decentespresso/openscale/README.md

# Decent Open Scale (aka "openscale")
Decent Open Scale
Copyright 2024 Decent Espresso International Ltd

Credits:
Invention and authorship: Chen Zhichao (aka "Sofronio")

# Introduction:
The Decent Open Scale is a full open sourced(software/hardware/cad design) BLE scale. Currently you can use it with de1app and Decent Espresso machine. But with Decent Scale API, you can use it for anything.<br />
To make it work, you need at least an ESP32 for MCU, a Loadcell for weighing, an HX711 for Loadcell ADC, a SSD1306 for OLED display, a MPU6050 for gyro function.<br />
The current PCB for HDS uses ESP32S3N16, i2000 2kg loadcell, ADS1232(instead of HX711), SH1106/SH1116(instead of SSD1306), ADS1115(for battery voltage), TP4056(battery charging), CH340K(COM to USB), REF5025(analog VDD), BMA400(instead of MPU6050, but gyro will be dropped in the future).
If you want to use it unplugged, you'll also need a 3.7v battery.<br />
If you only want to burn the firmware, please read How to upload HEX file.<br />

# How to build

Beginning with firmware version 3.0.0, OpenScale now uses [Platform.io](https://platformio.org) for development, building and flashing the firmware.  

To build and flash the scale from your computer, make sure you have the `pio` command line tool and OpenSSL installed. Set `OPENSSL` to its executable path if it is not available through `PATH`; Git for Windows is also detected when `git.exe` is on `PATH`.
After this, one can simply use `$pio run -t upload` and platformio will build and flash the firmware to the connected Esp32s3 chip.

# New in 3.1.14

## Custom firmware

The [custom build configurator](https://decentespresso.github.io/openscale/custom-build/) builds approved feature and plugin combinations. Choose `3.1.14 (stable)`, selected by default, for normal use. The other option, `main (development)`, is for testing only and requires confirmation before building. Download the build for USB installation or assign it to linked scales for signed WiFi installation and status tracking.

Plugin authors can use the [plugin development guide](docs/plugin-development.md) for package, webapp, and presentation rules.

## App Text (Development)

Development firmware includes BLE App Text in standard and custom builds. Enable
`Setup > Display > App Text` on the scale before connecting a supported app. The
setting defaults Off and survives reboot. Apps can show up to 128 printable ASCII
characters underneath the live weight or clear them to restore the timer area.
Text that fits stays centered. Longer instructions scroll left, pausing for one
second at the beginning and end before repeating.
The timer keeps running. Menus, errors, Pressensor, and grinder-operation screens
retain priority. Hold Circle while text is visible to block it until reconnection.
See the [protocol and browser example](examples/ble-app-text/README.md).

On updated `main`, custom firmware can include both Pressensor and Grind by Weight.
Their Enabled controls switch integrations immediately in the menu; saved sensor,
plug, and tuning settings remain intact. Switching is blocked while grinder
shutdown is unconfirmed. App Text has its own setting and does not select a mode.
Older firmware refs keep their existing plugin conflicts.

## Scale-top tap controls

Optional scale-top gestures can tare with a double tap and start or stop the timer with a triple tap. Both are disabled by default and can be enabled independently under `Setup > Scale`.

## Power and wake

Weight changes during use now refresh the auto-off timer, so active weighing does not require a button press to keep the scale awake. A static load does not keep resetting the timer.

Optional [Wake-on-Weight](docs/wake-on-weight.md) is available under `Setup > Power` and defaults to off. It checks for added or removed weight between deep-sleep intervals. This mode consumes battery during standby and has no ongoing low-voltage cutoff; read its limitations before enabling it.

Custom builds with `Energy Saving Beta` also expose OLED idle/redraw controls and a single `Light Sleep` toggle under `Power`. These remain optional, not part of the standard release build.

# New Features in 3.0.0

## Wifi mode

Decent Scale uses WiFi for web apps, WebSocket data streaming, and OTA updates.

To enable WiFi mode in 3.1.14, open `Setup > Connections` and toggle `WiFi`. Older firmware groups these entries under `WiFi Settings`. A restart is required for changes to take effect; exiting setup applies the queued restart.

**First-time setup:** if no WiFi credentials are stored, the scale opens its own access point: SSID `DecentScale`, password `12345678`, IP `192.168.1.1`. Connect to it and open [192.168.1.1](http://192.168.1.1), or [hds.local](http://hds.local) if your device resolves that hostname, to enter your home WiFi credentials. The same page can rename the scale (see **Scale name** below). Published 3.1.14 saves the credentials and restarts; its dashboard retains the manual setup controls.

In 3.1.15, enter the network name and password manually while `DecentScale` is active. Network search is hidden in setup AP mode, including AP+STA, because scanning can disconnect the phone from the scale. Find networks remains available when the setup AP is off.

**3.1.15 setup:** Connect opens a progress dialog. For a different network, stay on the original network while the scale tests the new connection without saving credentials, then returns to report the result. When starting from `DecentScale`, the setup AP stays active during the test and reports the result before the final switch. If your phone cannot reach the setup AP while mobile data is enabled, temporarily use airplane mode with WiFi enabled. A successful test offers the scale's tested IP address and starts the final switch. Click that link to show the network-change instructions, join the new network on your phone or computer, then select Continue. IP address is selected by default; hostname is an explicit alternative. The link also opens this address choice after a confirmed connection or same-network reconnect, without asking you to change networks again. If DHCP changes the address, enter the current IP shown on the scale. The destination checks the same scale and operation before confirming that credentials were saved. Navigation never starts automatically, and losing contact does not prove success. A failed switch restores the previous network or opens the setup AP. Retry closes the result dialog and returns to the password field without resubmitting. Current setup pages use network names and passwords exactly as entered, including meaningful leading or trailing spaces.

**Reconnect:** once configured, the scale stays in STA mode and reconnects automatically after signal loss with exponential backoff (5 s → 10 → 20 → 40 → 60 s cap). Ordinary signal loss does not open the AP. After a failed 3.1.15 setup test whose previous network cannot be restored, the recovery AP retries the saved network after ten minutes; a failed retry reopens the AP.

**Discovery:** the scale advertises itself via mDNS (`hds.local` by default) and DNS-SD (`_decentscale._tcp`) so apps can discover it on the LAN without knowing the IP.

**Scale name:** the mDNS name defaults to `hds`, so a scale you never rename answers at [hds.local](http://hds.local). When two scales share a network they both ask for that name and the mDNS stack pushes the loser to `hds-2.local` — which works, but which scale gets which address depends on boot order. Name them instead: on the scale's web page, use the "Scale Name" field in the WiFi setup area. Names are 1-24 characters of letters, digits, and hyphens (lowercased automatically); leaving the field empty restores `hds`, and re-submitting the name a scale already has changes nothing and does not restart it. Otherwise saving restarts the scale, after which it answers at `<name>.local`, advertises the DNS-SD instance `Half Decent Scale (<name>)`, and reports the name in the `/snapshot` status frame as `mdns_name`. The name is also shown on the scale's WiFi status screen (setup menu, "Wifi settings"). Names are not checked for uniqueness — pick a different one per scale.

If you rename during first-time setup, before entering WiFi credentials, the scale restarts back into access-point mode under the new name — reach it at `192.168.1.1` or `<name>.local`, not `hds.local`.

WiFi firmware updates are documented in [docs/wifi-ota.md](docs/wifi-ota.md).

## Web apps
The same web apps that could be used with Half Decent Scale from [the web](https://decentespresso.com/docs/introducing_half_decent_scale_web_apps) have now been rewritten to run directly from the Half Decent Scale.

You can find these apps on the index page of Half Decent Scale Web User Interface - navigating to [hds.local](http://hds.local)

## WebSockets support

When WiFi mode is enabled on HDS, there is also a new WebSocket endpoint available, where you can receive real-time information regarding the weight in the following format  

```json
{
  "grams": 25.66,
  "ms": 12345
}
```

you can also send a simple `tare` String over the websocket and the scale will tare itself.

For backwards compatibility, snapshot frames do not include a `type` field.
Clients should treat the absence of `type` as a weight snapshot. Event and
response frames always include `type`.

> **Security / trust model:** the WebSocket endpoint is unauthenticated, just
> like the BLE interface. Any host that can reach the scale on the network can
> read weight and send control commands, including destructive ones such as
> `power off`, `soft_sleep on`, and `display off` (a remote `power off` cannot
> be woken over the network). Only expose HDS on a trusted LAN.

Multiple clients may connect at once (e.g. the on-device web UI and a separate
app). They share a single negotiated stream rate (the most recent `rate` command
applies to all clients); each client is served independently, so a backed-up
client drops its own frames without stalling the others.

By default, WiFi clients receive weight snapshots at 2 Hz. A connected client
can negotiate one of the supported WiFi stream rates by sending one of these
WebSocket messages:

```text
rate 2k
rate 5k
rate 10k
```

or JSON (any of these forms work):

```json
{ "command": "rate", "value": "10k" }
{ "rate": "10k" }
{ "rate_hz": 10 }
{ "hz": 10 }
{ "interval_ms": 100 }
```

The supported rates are 2 Hz, 5 Hz, and 10 Hz. The firmware sends back a
`type: "rate"` acknowledgement with the active interval and rate. The firmware
does not automatically downgrade a requested rate on weak WiFi; if a client's
socket is not writable for a tick, that frame is skipped for that client rather
than queued.

WiFi snapshots are intentionally kept small, especially at 10 Hz:

```json
{
  "grams": 25.66,
  "ms": 12345
}
```

Battery, charging, timer, and power/display state are sent in typed `status`
frames on demand only. Send `status`, `battery`, or `info` to get one. The
firmware does not push status periodically (mirrors the BT side, which has no
periodic state push either — clients request battery via `0x22`, etc.).

WiFi clients can send these text commands over the same WebSocket:

```text
tare
events on
events off
timer start
timer stop
timer reset
display on
display off
low_power on
low_power off
soft_sleep on
soft_sleep off
power off
status
battery
info
```

The legacy text `tare` command is intentionally silent for backwards
compatibility. JSON `{ "command": "tare" }` returns a `type: "status"` ack.

The same commands can be sent as JSON (full form):

```json
{ "command": "tare" }
{ "command": "timer", "action": "start" }
```

**JSON shorthand** — control keys at the top level are also accepted:

```json
{ "events": "on" }
{ "display": "off" }
{ "tare": true }
{ "timer": "start" }
```

Bool values map to on/off (`{"display":false}` → off). The `power` key is excluded from the bool form — power-off requires the explicit `{"command":"power","action":"off"}` or text `power off`.

An unrecognized or malformed command (bad JSON, or an unknown verb) returns an
`error` frame rather than silence, so a client can distinguish a rejected
command from a frame that never arrived:

```json
{
  "type": "error",
  "code": "unknown_command",
  "message": "unrecognized or malformed command",
  "ms": 12345
}
```

Status frame shape:

```json
{
  "type": "status",
  "status": "ok",
  "protocol_version": 1,
  "firmware_version": "FW: 3.0.9",
  "grams": 25.66,
  "ms": 12345,
  "battery_percent": 82,
  "battery_voltage": 3.95,
  "charging": false,
  "timer_running": true,
  "timer_seconds": 12,
  "display_on": true,
  "low_power": false,
  "soft_sleep": false,
  "events_enabled": true,
  "rate_hz": 10,
  "interval_ms": 100
}
```

For backwards compatibility, WiFi only sends weight snapshots by default. A
client must send `events on` before local scale button presses or power-off
notifications are emitted (status frames remain on-request regardless of the
`events` flag). The event stream resets to off when the WebSocket disconnects.

Button event fields:

```json
{
  "type": "button",
  "button": "circle",
  "button_number": 1,
  "press": "short",
  "press_code": 1,
  "ms": 12345
}
```

Button numbers are `1 = circle` and `2 = square`. Press codes currently emitted
over WiFi are `1 = short` and `2 = long`; the current finger-detection path only
emits short-press events.

Power event fields:

```json
{
  "type": "power",
  "event": "power_off",
  "reason": "low_battery",
  "reason_code": 3,
  "ms": 12345
}
```

Power reason codes are `0 = disabled/failed`, `1 = circle double-click`,
`2 = square double-click`, `3 = low battery`, and `4 = gyro` when gyro support
is compiled in.

Power and display command semantics:

- `display on` / `display off`: OLED power save on/off. The scale and WiFi stay
  awake.
- `low_power on` / `low_power off`: sets OLED contrast to minimum/maximum. It
  does not disable the WiFi modem or drop the WebSocket link.
- `soft_sleep on`: turns off the OLED and sensor power rails and pauses normal
  scale-loop work. WiFi remains configured so a later WebSocket command can wake
  it, but weight snapshots stop while soft sleep is active.
- `soft_sleep off` / `soft_sleep wake`: restores sensor power, OLED power, and
  normal scale-loop work.
- `power off`: full scale power-off. The WebSocket link will drop and cannot
  wake the scale.

A scriptable regression test for this protocol lives in
[`tools/ws_feature_test.py`](tools/ws_feature_test.py): with WiFi enabled on the
scale, `pip install websocket-client` then `python3 tools/ws_feature_test.py`
(it auto-discovers `hds.local`, or pass an IP).

# How to upload Web apps?

In order to build and upload Web apps to HDS, you need to use `pio` to build and upload the filesystem image to the Esp32s3.  
Simply run `pio run -t buildfs -t uploadfs` with the Esp32s3 connected to your computer

# Development workflow

Trunk-based: `main` is the single long-lived branch and is always releasable. Do work on short-lived feature branches and merge into `main` once CI passes.

`Release firmware` prepares a signed draft from a version tag (`vX.Y.Z`); `Publish firmware` publishes the verified draft without rebuilding. See [release workflow details](docs/AI_RELEASE_NOTES.md#release-model) for inputs and checks. Releases include the legacy USB ZIP, dependency inventory, signed release evidence, and machine-readable OTA assets:

- `firmware.bin`: raw OTA firmware image.
- `littlefs.bin`: raw filesystem image. WiFi OTA releases always publish and require it so skipped versions and test builds with unknown filesystem state are brought back to the production filesystem.
- `manifest.json`: release metadata downloaded by the scale before installing.
- `manifest.sig`: detached SHA-256 signature. The workflow requires `HDS_OTA_SIGNING_KEY_PEM` as a repository secret. Firmware trusts the three public keys tracked under `keys/ota/`.

Key 1 continues signing releases until firmware containing all three public keys has rolled out. Firmware released before the three-key migration trusts only Key 1 and cannot recover with Key 2 or Key 3 if the Key 1 private key is lost. Losing a private key does not require removing its public key from firmware.

The scale checks `https://github.com/decentespresso/openscale/releases/latest/download/manifest.json`, downloads `manifest.sig`, verifies the detached signature with the public key compiled into the firmware, then verifies `model`, optional `pcb`, `min_from`, chip, environment, flash size, partition schema, filesystem partition size/schema, HTTPS certificate chain, asset URL prefix, asset size, and SHA-256 before writing firmware. Manifest `version` and `min_from` must be stable numeric `major.minor.patch` values. The workflow builds a signed catalog from `v3.1.13` upward by merging the previous latest stable signed manifest with the new release, deduping compatible entries, and sorting newest to oldest. The WiFi updater lists compatible stable releases except the firmware version already running.

WiFi OTA always stages the required LittleFS update. With signed rollback metadata available, the current firmware saves both target and rollback metadata, writes the inactive app slot, and reboots. The new firmware verifies or attempts the target filesystem at most twice before accepting normal operation. On failure it rolls back, restoring the previous filesystem once if writing had begun. Firmware with the 3.1.14 recovery support pauses a failed restore, disables unverified web assets, and keeps the embedded WiFi setup page and update menus available for repair. Older rollback firmware can instead stop at `UPDATE ERROR` and require USB recovery. Successful recovery clears the pending state and reboots.

When the installed build has no published recovery assets, firmware that already supports forward recovery may install a signed target declaring `forward_recovery: 1`. It verifies the newly running firmware before attempting filesystem writes, then either completes the update or retains filesystem-free repair access. This cannot add recovery support to already-installed older firmware. See [WiFi OTA updates](docs/wifi-ota.md) for supported source paths. `HDS_RELEASE_MIN_FROM` may raise the minimum source version, but release verification rejects a value that excludes the previous stable release.

The single LittleFS partition has no independent rollback slot, so recovery requires the signed rollback asset to remain available. The firmware records attempt and write state before changing the partition so power loss resumes the same bounded recovery transaction instead of entering normal weighing with a partial installation.

# Automated builds

With version 3, we have also started using GitHub actions to build the firmware and filesystem images. You can find the recent builds on the "Actions" tab on the GitHub page of this project. From there you can also download the firmware files (e.g. for development builds).

# How to upload firmware files
Web USB Flash(please use Chrome/Edge, Safari or Firefox is not supported):<br />
https://adafruit.github.io/Adafruit_WebSerial_ESPTool/ <br />
The offset values are:<br />
bootloader.bin 0x0000<br />
partitions.bin 0x8000<br />
firmware.bin 0x10000<br />
littlefs.bin: 0x670000<br />

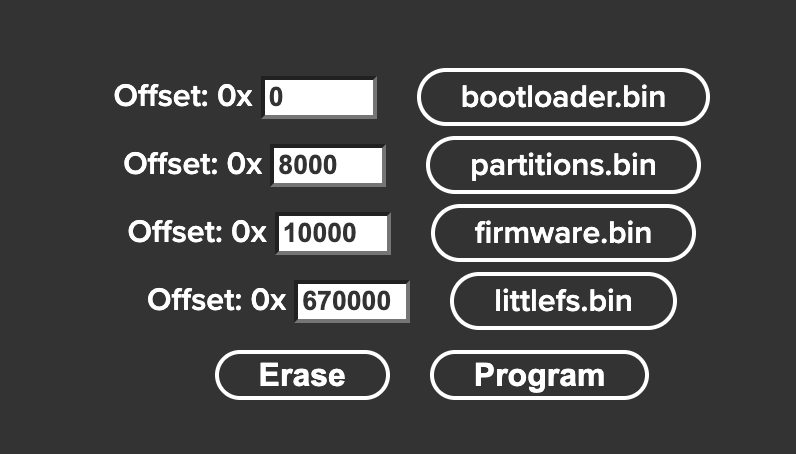
[picture p1: assets/esp-tool.png]
binary offsets


This tool works great, but need to reset by pressing the button on the PCB.<br />
And as it erase the eprom, a calibration is also required.<br />

Or use OpenJumper™ Serial Assistant, link as below.(In Chinese)<br />
https://www.cnblogs.com/wind-under-the-wing/p/14686625.html <br />
