decentespresso/openscale/plugins/grind-by-weight/README.md

# HDS Grind by weight

HDS support for using a Tasmota smart plug as a grinder power switch.

Plug-side firmware lives at:

https://github.com/decentespresso/tasmota-auto-doser

This is a trusted-local-WLAN feature. The plug MAC is used as an identity label, not as authentication.

## What It Does

- Lets the scale switch the grinder plug on and off automatically
- After a new plug connection, starts only after you tare the empty cup and it becomes stable
- Stops the grinder when the dose reaches the target
- Waits for cup removal before preparing the next dose
- Learns a better safety value from normal shots over time
- Keeps the plug off if the connection is lost while grinding
- Keeps normal weighing responsive even when the plug is offline

The grinder itself still needs to be ready to run. This feature controls power to the plug, not the physical grinder switch.

## Plug Setup

Install the linked plug firmware on the Tasmota plug, then connect the plug to the same WiFi network as the scale.

## Scale Setup

1. Build firmware with the `Grind by weight` plugin and flash it to the HDS scale.
2. Connect the scale to WiFi.
3. Open the HDS OLED menu.
4. Open `Grind by weight`.
5. Select `Enable`.
6. Select `Select Plug`.
7. Choose the plug MAC address.
8. Adjust the grinder settings if needed.
9. Leave the menu with `Back`.

The selected MAC is the saved identity. Hostname and IP are cached only to find the plug faster later.

## First Safe Test

Keep the grinder's physical switch off for the first test so the plug can switch without starting the motor.

1. Complete `Scale Setup` and leave the menu.
2. Confirm that the display reaches `Tare to arm`.
3. Put the empty dosing cup in its normal position and tare the scale.
4. Wait for `Ready` and confirm that the plug relay switches on.
5. Add weight gradually until the cutoff is reached and confirm that the plug switches off.
6. Remove the weight and return the empty cup. After stable zero, the display should return to `Ready`.

Only enable the grinder's physical switch after this dry test works reliably.

## Settings

From the normal weight view, hold both buttons for 500 ms to open the `Grind by weight` menu when the feature is enabled. Use `Target g` there for quick target changes.

Defaults:

```text
Grind by weight: disabled
Target: 15.0 g
Safety: 2.0 g
Zero range: -1.0 g to 1.0 g
Zero hold: 1000 ms
Target tolerance: 0.5 g
```

`Enable` forces WiFi on boot.

Entering the grinder menu while the plug is armed sends OFF first. The TCP connection is kept alive where possible, and leaving the menu rearms only after stable zero.

The cutoff threshold is:

```text
target grams - safety grams
```

Latency compensation is not used. Adaptive safety is the only early-stop compensation.

Example with the defaults:

```text
target: 15.0 g
safety: 2.0 g
cutoff: 13.0 g
```

The earlier cutoff allows for grounds that continue falling after power is removed. Adaptive learning adjusts safety from valid completed doses; it does not change the target.

## Normal Use

1. Enable Grind by weight and select a plug.
2. Put the empty dosing cup on the scale.
3. On the first plug connection after Grind by weight starts, the display shows `Tare to arm`.
4. Tare the scale.
5. Wait until the cup is stable inside the zero range.
6. The display shows `Ready` and the scale sends `ON` to the plug.
7. Start the grinder physically if needed.
8. The display changes to `Grinding` after a rising dose is detected.
9. The scale sends fast OFF when cutoff is reached.
10. Remove the filled cup.
11. Put the empty cup back.
12. The scale rearms after stable zero hold without requiring another tare.

After a reconnect, the existing tare baseline remains valid. The relay stays off; remove and return the cup to resume without another tare. Automatic startup, charging-wake, and ADC-recovery tares do not arm the grinder.

After `Ready` appears, only ground coffee should add weight. Slowly placing another object can look like a valid grind because the scale only sees weight changes. If the cup or setup changes, tare again before grinding.

## Display Status

| Display | Meaning | What to do |
| --- | --- | --- |
| `WiFi wait` | Scale is waiting for WiFi | Wait for WiFi or check the saved network |
| `Plug wait` | Selected plug is not reachable | Power the plug or use `Select Plug` |
| `Tare to arm` | Plug is connected but safely OFF | Put down the empty cup and tare |
| `Zero wait` | Waiting for a stable zero reading | Leave the empty cup untouched |
| `Ready` | Plug relay is ON and dosing can begin | Start the grinder physically |
| `Grinding` | A plausible rising dose was detected | Let the dose run |
| `Stopping` | OFF was sent and acknowledgement is pending | Wait briefly |
| `Remove cup` | Dose ended | Remove the filled cup |
| `Await zero` | Waiting for the empty cup to return | Return the empty cup and leave it stable |
| `Tare cup` | Weight rose too quickly to be a plausible grind | Return to zero or tare the changed setup |
| `Busy` | Another scale/client owns the plug connection | Disconnect the other client or restart the plug |
| `Error` | Fail-safe stopped Grind by weight | Check the plug and reconnect Grind by weight |

`Grinding` is a display indication, not the cutoff authority. It appears after at least 750 ms, 1.0 g rise, three positive steps, and an average rise no faster than 6 g/s.

## Cutoff Protection

OFF is blocked until all of these are true:

- tare is not pending
- one user-requested tare completed during the current grinder session
- weight has left zero range
- 1500 ms passed since leaving zero range
- weight is at or above `target - safety`
- the selected plug connection is still valid

Grind confirmation changes the display from `Ready` to `Grinding`. If cutoff weight is reached at an impossible average rate above 6 g/s, the scale treats it as cup/setup mass and does not send OFF. This block remains until tare or return to zero, so a stationary cup cannot later become a valid grind merely because time passes.

`Target g` accepts 10.0 to 200.0 g. `Safety g` accepts 0.0 to the smaller of 10.0 g or `target - 5.0 g`, keeping cutoff at 5.0 g or higher.

## Adaptive Safety

After a valid grind, the scale compares final weight to target and adjusts safety for later shots.

Example:

```text
target: 15.0 g
final: 15.3 g
result: safety increases for future shots
```

The adaptive value averages the last 3 valid recommendations.

Learning is skipped when the shot does not look like a normal grind:

- final weight did not become stable
- the cup was removed too early
- weight dropped after OFF
- the grind stalled below target
- average grind rate was too high
- final result was too far from target

Adaptive changes are saved before deep sleep instead of on every loop.

## Technical Details

The plug advertises itself with mDNS:

```text
service: _grinderplug._tcp.local
port: 31980
TXT mac=<plug_mac>
TXT proto=1
TXT model=<optional model name>
```

The scale stores the selected plug MAC as the identity. Hostname and last IP are only cached lookup hints.

The scale keeps one TCP connection open while active. It sends `HELLO <scale_mac>` and only accepts the plug if the returned MAC matches the selected MAC.

After validation, cutoff uses the fast OFF command `!`. The scale also sends PING heartbeats while connected.

The plug relay must default to OFF on boot. If the active TCP connection drops, the plug must also turn the relay OFF.

Each plug accepts one active scale connection. A second client receives `BUSY` and is closed.

## Troubleshooting

### Select Plug Finds Nothing

Check mDNS from another machine:

```powershell
dns-sd -B _grinderplug._tcp local
dns-sd -L "INSTANCE NAME HERE" _grinderplug._tcp local
```

Expected result:

```text
port=31980
mac=<plug_mac>
proto=1
model=<optional model name>
```

If `_http._tcp` appears but `_grinderplug._tcp` does not, the plug service advertisement is wrong.

### Scale Shows Plug Wait

The selected plug cannot currently be reached.

Check:

- plug is powered
- plug is on the same WLAN
- plug TCP service is listening on port 31980
- saved hostname still resolves
- saved IP still belongs to the selected plug

If the plug IP changed and hostname lookup does not recover it, run `Select Plug` again.

### Scale Shows Busy

Another scale or client is already connected to the plug. Disconnect the other client or restart the plug.

### Scale Shows Wrong Mac

The TCP server answered with a MAC different from the selected plug MAC. This usually means the cached IP points to another device. Run `Select Plug` again.

### Scale Shows an Error

The scale entered the Grind by weight fail-safe state.

Common causes:

- plug connection lost while grinding
- malformed TCP response
- wrong plug MAC
- plug returned `ERR`
- `ON` timed out
- `OFF` timed out

The plug is expected to turn OFF automatically when the active TCP connection drops.

### Scale Shows Tare To Arm

The plug connection is valid, but the grinder remains OFF until a user-requested tare completes. Put the empty basket on the scale and press tare. Startup and recovery tares do not clear this prompt.

### Plug Is Offline And Weighing Must Stay Responsive

Normal weighing does not run full blocking service discovery in the background. Runtime lookup only tries the saved IP and saved hostname with short timeouts. Full mDNS discovery happens in manual `Select Plug`.

### The Scale Does Not Rearm

Rearming requires:

- filled cup removal detected
- empty cup returned
- weight stable inside zero range for the zero hold time

Default zero hold is 1000 ms.

## Serial Debug

Grind by weight debug logs are printed on USB serial. The internal prefix remains:

```text
[grinder] connect
[grinder] tx HELLO
[grinder] rx OK
[grinder] cutoff
[grinder] safety learn
[grinder] error
```

## Security Notes

This protocol has no cryptographic authentication. Any host on the trusted WLAN that can reach the plug or scale network services may interact with them. Do not expose the scale or plug to untrusted networks.
