decentespresso/openscale/docs/AI_PROTOCOL_NOTES.md

# AI Protocol Notes

Read this when changing Decent binary commands, BLE or USB framing, shared response packets, compatibility behavior, or the WebSocket control surface.

## Sources

- Shared Decent packet helpers, response builders, command lengths, and dispatch: `include/decent_protocol.h`.
- BLE GATT transport and `BleDecentCommandSink`: `include/ble.h`.
- USB buffering, text/binary separation, and `UsbDecentCommandSink`: `include/usbcomm.h`.
- WebSocket text and JSON protocol: `include/websocket.h`; its user-facing wire contract is in `README.md`.
- ADS debug host helpers and decoders: `tools/ads_debug_protocol.py`, `tools/decode_ads_debug.py`.

WebSocket is not a wrapper around the Decent binary dispatcher. Keep its backward-compatible JSON/text behavior separate while routing equivalent hardware actions through the same runtime helpers where practical.

## Binary Command Flow

BLE and USB both route Decent commands through `handleDecentBinaryCommand()`. The shared dispatcher owns command validation and meaning; transport sink methods own delivery and transport-specific side effects.

- BLE accepts one GATT write on service `fff0`, write characteristic `36f5`, and notifies responses on `fff4`.
- USB shares serial with text commands and logs. It buffers up to 160 bytes, separates text from frames beginning with `0x03`, and uses a 30 ms timeout to resolve incomplete legacy frames.
- `decentCommandFrameLength()` is the USB stream boundary contract. Update it whenever a binary command length changes.
- Every command handler must guard the bytes it reads with `decentRequireLength()`.

Do not duplicate command interpretation in BLE and USB. Add shared behavior to the dispatcher and only add sink methods when the transports genuinely perform the effect differently.

## BLE Notification State

App Text is a separate core characteristic in `FFF0`, UUID
`8b8dc7c0-6bf7-4bdf-9a2c-0ba9cb9a4a01`. Read returns `[1,128,10,enabled]`;
write `[1,...text]` to Show or `[0]` to Clear. Text is 1-128 printable ASCII bytes.
Each Show is one acknowledged write, up to 129 bytes; the BLE stack handles
long-write assembly. The updated browser helper negotiates the advertised limit
and still accepts the original 18-byte firmware capability.
Only the local persisted Display opt-in enables Show. BLE callbacks validate and
update protected fixed buffers; the main loop renders text below weight on the
normal weighing screen. Overflowing text holds its beginning for one second,
scrolls left at ten pixels per second until its end is visible, holds for one
second, and starts over. Scrolling position participates in Energy Menu redraw
detection. Legacy heartbeat refreshes the ten-second text session, not scrolling.
Disconnect, expiry, Off, or Clear removes text; Circle cancellation blocks Show
until reconnection. Neither USB nor WebSocket exposes this text command. See
`examples/ble-app-text/README.md` and run `python tools/test_app_text.py`.

A live BLE connection does not imply an FFF4 notification subscription. A client becomes eligible for outbound FFF4 notifications only after its current connection handle subscribes to the characteristic.

All outbound FFF4 paths pass through `bleCanNotifyCurrent()`. The shared gate checks the feature state, characteristic, live connection, and current subscription before touching the characteristic.

On iOS 9 the pinned arduino-esp32 framework can insert a peer before descriptor lookup, then skip both `onConnect` and its connection-count increment when that lookup fails. `onSubscribe` removes the uncounted peer before disconnect can underflow the framework counter, adopts the connection without clearing queued responses, and records that the connection requires direct NimBLE notifications. Normal connections continue through `BLECharacteristic::notify()`.

Display status responses are deferred through a mailbox. The BLE callback queues the response, and `processBleStatusResponse()` drains it from the main loop. The mailbox waits two seconds for the FFF4 subscription, then rechecks the connection handle, connection generation, pending requests, and subscription before disconnecting. A newer request or reused connection cancels stale recovery.

## Framing And Checksums

Decent binary frames begin with model byte `0x03`. Checksums are XORs of the preceding bytes.

- `0x0F` tare is a seven-byte checksummed command; an invalid checksum must not tare.
- `0x0A`, `0x0B`, `0x25`, and `0x26` have legacy short-form compatibility in the USB length resolver. Do not make checksums universally mandatory without checking existing clients.
- A short USB form is accepted after the receive timeout; a complete valid checksummed form takes precedence.
- Shared seven-byte response builders calculate byte 6 from bytes 0 through 5.
- The `03 0A` LED response stores weight in bytes 2-3, battery state in byte 4, firmware major in byte 5, and checksum in byte 6. The firmware byte must be assigned before calculating the checksum.
- Weight packets use command `0xCE` and signed tenths of a gram. Decent fixed-point values are rounded to the nearest tenth rather than truncated, then clamped to the `int16_t` range.

`0x1B` starts a WiFi pull OTA and has two accepted forms:

- `03 1B` is the bare form. It starts the interactive on-OLED release picker and frames as exactly two bytes. An isolated prefix waits for the existing 30 ms USB receive timeout; a following unbiased byte resolves it immediately.
- `03 1B <major> <minor> <patch>` names a target release for an unattended install. Each version byte is encoded `0x80 | value`, so every component is capped at 127 and the firmware masks with `0x7F` on receipt.

The USB length resolver picks the five-byte form only when `data[2]` has its high bit set. A following command always begins with model byte `0x03`, and a biased version byte never can, so that byte distinguishes the forms without a checksum. Until a third byte arrives, the resolver retains the two-byte prefix. Timeout resolution waits while UART bytes remain unread, including across the main loop's 32-byte receive boundary. A frame whose payload has begun but is shorter than five bytes is refused and logged, never truncated to the bare form.

Every byte of a started payload must stay biased. An unbiased byte resynchronizes the resolver after one byte, so `03 1B 83` followed by `03 22` refuses the update and still delivers `03 22`. The dispatcher repeats the check, since BLE delivers whole packets and never reaches the resolver.

The bias is what lets one request form serve every scale. `processUsbRxBuffer()` enters the binary resolver only when the buffer's first byte is `0x03`, so firmware predating the payload frames `03 1B` as two bytes, starts its picker, and then discards the trailing bytes through the text path. A client never has to know the scale's firmware version or negotiate a capability.

The reserved target `0.0.0`, encoded as `03 1B 80 80 80`, requests an unattended
installation of the currently assigned Custom Build instead of an official release.
It uses the same BLE and USB queue and five-byte framing. No individual version bit
is repurposed. A missing pairing or assignment never starts an installation or pairing.
An already installed combination never downloads again. Older firmware does not
support this target: it either rejects the unsupported version or opens its legacy picker.

The client supplies no asset URLs. Official assets come from the signature-verified
catalog; custom assets come from the authenticated assignment and verified custom
manifest, with the same mandatory LittleFS and rollback checks. See `docs/AI_OTA_NOTES.md`.

The `/snapshot` WebSocket carries the same request as a `wifi_update` control command, accepted bare, as `wifi_update <version>`, and as `{"command":"wifi_update","action":"<version>"}`. The version is dotted `major.minor.patch` with an optional leading `v`. The command is compiled out when `HDS_FEATURE_PULL_OTA` is disabled and then answers `unknown_command`. A JSON `action` that is present but not a string answers `invalid_action`: an omitted action means the bare form, so a boolean, number, or object must not silently collapse into it.

ADS debug responses are separate fixed formats: the debug packet is 41 bytes and the reset response is 5 bytes. Keep their Python helpers, decoder, and firmware builders aligned.

Because WebSocket OTA uses the same target dispatcher, `wifi_update 0.0.0` also
requests the assigned Custom Build. Ordinary release versions and the bare picker
command retain their existing behavior.

## Runtime Effects

Shared packet meaning does not imply identical execution context:

- BLE sink actions that touch display, power, timer, or sleep state generally queue pending work for the main loop.
- USB sink actions run through the USB path and currently perform some effects directly.
- AsyncTCP WebSocket callbacks must only update visible state, reply to their client, or queue main-loop work. Never move I2C, SPI, OLED, power-gating, or blocking work into them.
- Remote tare paths should converge on `requestRemoteTare()`.
- Soft wake paths should converge on `wakeScaleFromSoftSleep()` and remain idempotent.

Preserve response ownership: BLE replies notify `fff4`; USB replies use `Serial.write`; WebSocket replies go only to the requesting client unless an event is explicitly broadcast and heap-gated.

## Compatibility Checklist

- Search both sinks and every response builder before changing a command.
- Preserve exact command lengths, legacy short forms, checksum coverage, and byte order unless a protocol version transition is planned.
- Keep BLE and USB response payloads identical when they use the same shared builder.
- Do not add a WebSocket `type` field to weight snapshots; clients use its absence to identify legacy snapshot frames.
- Keep the legacy WebSocket text `tare` command silent; JSON tare returns a status response.
- Treat `03 0A` as compatibility-sensitive because it covers display, power, low-power, heartbeat, soft-sleep, and the LED response.
- Keep `0x1B` version bytes biased with `0x80`. An unbiased payload could hold `0x03`, which older firmware would read as the start of a command: a `3.10.2` target would decode to `03 0A 02`, the power-off command, and `3.11.x` would land on the timer opcode.

## Checks

Use the smallest relevant set:

```sh
python tools/test_ads_debug_protocol.py
python tools/test_decode_ads_debug.py
python tools/test_soft_sleep_ads_wake.py
python tools/test_ble_subscription_contract.py
python tools/test_decent_ota_target_contract.py
pio run -e esp32s3
```

Device checks are still required for transport timing and delivery: use `tools/ble_scale_client.py` for BLE heartbeat behavior, `tools/usb_rate_check.py` for USB framing/rate behavior, and the matching ADS monitor for debug packets. There is no complete host-side test for the shared Decent dispatcher, so command-length or dispatch changes need focused coverage rather than relying only on a successful build.
