decentespresso/openscale/plugins/default-web-apps/assets/Quality_Control_Assistant/README.md

# A Quality Control Weighing Application for Decent Scales

Use this app for repeated pass/fail weighing on a Half Decent Scale. The
bundled app connects to the serving scale's `/snapshot` WebSocket over WiFi;
it does not use browser Bluetooth or a pairing dialog.

---

## Live Demo

The separately hosted Bluetooth variant is available here. Its connection
controls differ from the firmware-bundled WiFi app described below:

[https://decentespresso.com/support/scale/decentscale_qcweigh](https://decentespresso.com/support/scale/decentscale_qcweigh)

---

## Features

* **Real-time Weight Display:** Get live weight readings from your Half Decent Scale in grams.
* **Guided QC Workflow:** A robust **state machine** guides you through the measurement process, prompting for object placement and removal.
* **Configurable Thresholds:** Define **goal weight**, **low threshold**, **high threshold**, and a **minimum weight** for object detection to customize pass/fail criteria.
* **Audible Feedback:** Optional sound alerts indicate whether a measurement **passed or failed**, allowing for quick, non-visual feedback.
* **Comprehensive Measurement Logging:** Every QC reading is saved with:
    * A unique reading ID
    * Timestamp
    * Measured weight
    * Pass/Fail result
    * The exact QC settings active at the time of measurement.
* **Local Data Storage:** Completed readings are saved in this browser's local storage and restored on reload at the same origin. Clearing site data, private-browsing restrictions, or storage limits can remove or prevent persistence. Export important readings; a storage warning means the current readings must be exported before closing the tab. Each reading has its own `hds.qc.history.v1.*` key, so simultaneous tabs do not overwrite one another. Reload combines saved readings and numbers the displayed rows.
* **Flexible Data Export:** Easily download your collected QC data in:
    * **CSV (Comma Separated Values):** Perfect for spreadsheet analysis.
    * **JSON (JavaScript Object Notation):** Ideal for programmatic use or integration with other systems.
* **User Presets:** Save and load your specific QC settings (e.g., for different coffee beans or products) to quickly switch between workflows. Presets are stored locally for convenience.
* **Fullscreen Mode:** Toggle full-screen view for a distraction-free experience.
* **No Frameworks:** Built purely with native JavaScript, HTML, and CSS for a lightweight and transparent codebase.

---

## How to Use

1.  **Ensure Scale is Ready:** Turn on your Half Decent Scale and connect it to WiFi.
2.  **Open in Browser:** Join the scale's network and open its web page at `http://hds.local` or its displayed IP address, then select Quality Control Assistant.
3.  **Check Connection:** Wait for `Status: Connected (WebSocket)`. The app connects to the scale serving the page; no Bluetooth pairing is needed.
4.  **Configure Settings:**
    * Input your target **Goal Weight**, allowable **Low Threshold**, and **High Threshold**.
    * Set the **Min Weight** above 0.2 g (the empty-scale tolerance). All weight fields must be finite, with the goal between the low and high thresholds. Incomplete or inconsistent settings cannot start QC.
    * Check **"Enable Sounds"** if you want audio cues for pass/fail.
    * You can also save your current settings as a **preset** by typing a name in "Object Name" and selecting "Save Current Settings as Preset" from the dropdown. To load a saved preset, simply select it from the dropdown.
5.  **Start QC Mode:** Click the **"Start QC Mode"** button. The app will tare the scale and display status messages.
6.  **Follow On-Screen Prompts:**
    * "Place object on scale": Place your first item on the scale.
    * "Stabilizing...": The app waits for the weight to become stable.
    * "Measurement done, place next object": Once a stable reading is recorded and evaluated (Pass/Fail), a sound will play (if enabled), and you'll be prompted to remove the current item and place the next.
7.  **Export Data:** After completing your measurements, click **"Export to CSV"** or **"Export to JSON"** to download your collected data.
8.  **Stop QC Mode:** Click **"Stop QC Mode"** to end the current QC session.

---

## Technical Details

The `decentscale_qcweigh` application relies on a few key technical aspects:

* **WebSocket Communication:** `quality_control.js` connects to `ws://<page-host>/snapshot`, receives weight snapshots, and sends `tare` on that connection. A successful send does not acknowledge completed hardware tare. Use only a trusted network; the endpoint has no client authentication.
* **QC State Machine:** The core of the QC logic is managed by a state machine with three states:
    * **`WAITING_FOR_NEXT`**: The scale is waiting for an object to be placed.
    * **`MEASURING`**: An object has been detected, and the app is waiting for the weight to stabilize.
    * **`REMOVAL_PENDING`**: A measurement has been recorded, and the app is waiting for the object to be removed before prompting for the next.
* **Weight Stability:** After object detection, the observed weight range must stay within `stabilityThreshold` (default **0.2 g**) for **2.5 seconds**. A sample gap over one second or a WebSocket interruption restarts settling. Removing an unsettled object does not create a reading. A completed object still has to be removed before the next reading, including after reconnect. Stopping QC clears settling and its pending removal reminder.
* **Local Storage for Presets:** QC uses `decentScaleQCPresets` with `{version: 1, presets: {...}}` and `lastUsedQCPreset`, separate from Dosing Assistant. Before the first save, it reads compatible legacy entries and selections from `decentScalePresets` and `lastUsedPreset`. Saving copies them into the QC namespace without changing the legacy data. Once the QC store exists, the app stops consulting either shared key. It ignores unsupported store versions and refuses to overwrite them.
* **Sound Generation:** Basic pass/fail sounds are generated directly in the browser using the **Web Audio API** (`AudioContext`, `OscillatorNode`, `GainNode`).
* **Fullscreen API:** Utilizes the HTML Fullscreen API (`requestFullscreen`, `exitFullscreen`) for a more immersive user interface.

---

## Development Setup

To explore, modify, or contribute to this application:

1.  **Download all files in this folder**.
2.  **Navigate to the folder** in your terminal:

    ```bash
    cd openscale/plugins/default-web-apps/assets/Quality_Control_Assistant
    ```

3.  **Serve the files locally over HTTP/HTTPS:**
    A local server lets you inspect layout, but the app tries `/snapshot` on
    that server's host. It will not connect to a separate scale without a
    development proxy or an explicit development-only endpoint change. For
    end-to-end use, serve the bundled app from the scale with the shared assets.
    You can use a local web server for the layout preview:

    **Using Python's `http.server` (Python 3, recommended):**

    ```bash
    python -m http.server 8000
    ```

    Then, open your Chrome or Edge browser and go to: `http://localhost:8000/`

    **Using Node.js `http-server` (if you have Node.js installed):**

    ```bash
    npm install -g http-server
    http-server -p 8000
    ```

    Then, open your Chrome or Edge browser and go to: `http://localhost:8000/`

---

## Code Structure Highlights

The core logic resides within the `DecentScale` class (`quality_control.js`):

* **`constructor()`**: Initializes properties, sets up event listeners after DOM is loaded, and loads saved presets.
* **`initializeElements()` & `addEventListeners()`**: Handles linking JavaScript to HTML elements and attaching user interaction handlers.
* **`handleWebSocketWeight(weight)`**: Updates the displayed weight from `/snapshot`.
* **`processQCWeight(weight)`**: Runs the QC state machine and weight evaluation.
* **`tare()`**: Sends the WebSocket tare command.
* **`evaluateWeight(weight)`**: Simple logic to determine if a reading is "pass" or "fail" based on thresholds.
* **`playSound(type)`**: Generates audible feedback for pass/fail results.
* **`toggleQCmode()`, `startQCMode()`, `stopQCMode()`**: Controls the overall QC mode activation and deactivation.
* **`updateQCStatus(state, message)`**: Updates the user interface with current QC status messages and dynamic styling.
* **`saveMeasurement(weight, result)`**: Records each individual QC measurement, including its context.
* **`displayWeightReadings()`**: Updates the displayed list of past measurements and manages export button states.
* **`exportToCSV()` / `exportToJSON()` / `downloadFile()`**: Handles the logic for converting `weightData` into downloadable CSV and JSON files.
* **`setupPresetHandlers()`, `saveCurrentPreset()`, `savePreset()`, `getPresets()`, `getPreset()`, `loadPresets()`, `loadPreset()`, `updatePresetList()`**: A comprehensive set of methods for managing user-defined QC presets via `localStorage`.
* **`toggleFullScreen()`, `setupFullscreenHandler()`, `updateFullscreenState()`**: Manages the fullscreen browser functionality.

---

## Contributing

We welcome community contributions! If you have suggestions, bug reports, or want to contribute code, please refer to the main [Programmers guide to the Half Decent Scale](https://decentespresso.com/docs/programmers_guide_to_the_half_decent_scale).

---

## License

This project is licensed under the **GNU General Public License v3.0**. See the `LICENSE` file in the main repository for more details.

---
