decentespresso/openscale/Scale Case/half_decent_scale_electrionics v8.step

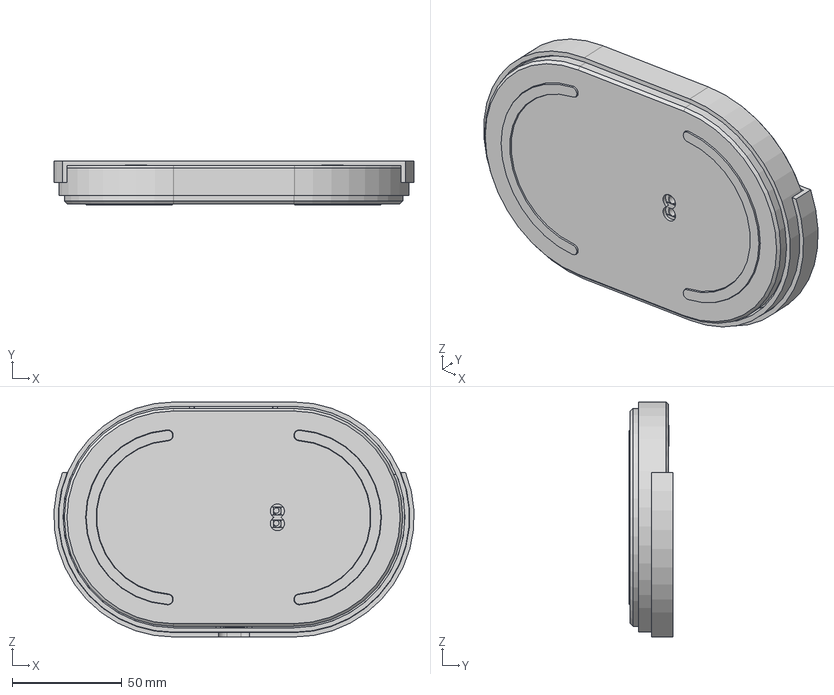
[picture p2: CAD file, 2024-04-07]
Scale Case/half_decent_scale_electrionics v8.step
164.2 x 20.1 x 107.2 mm
PRT0002_2
称重单元47x9.5x6
SH1116
ESP32 Wemos Lolin32 Lite
PCB (6)
零部件2
零部件4
零部件5
零部件6
零部件7
零部件8
零部件9
零部件10
零部件11
零部件12
零部件13
零部件14
零部件15
零部件16
零部件17
零部件18
零部件19
零部件20
零部件21
零部件22
零部件23
零部件24
零部件25
零部件26
零部件27
零部件28
零部件29
零部件30
零部件31
零部件32
零部件33
零部件34
零部件35
零部件36
零部件37
零部件38
零部件39
零部件40
零部件41
零部件42
零部件43
零部件44
零部件45
零部件46
零部件47
Type-C 母座
MPU6050
SHELL3_8(镜像)
