decentespresso/openscale/Scale Case/half_decent_scale v9.step

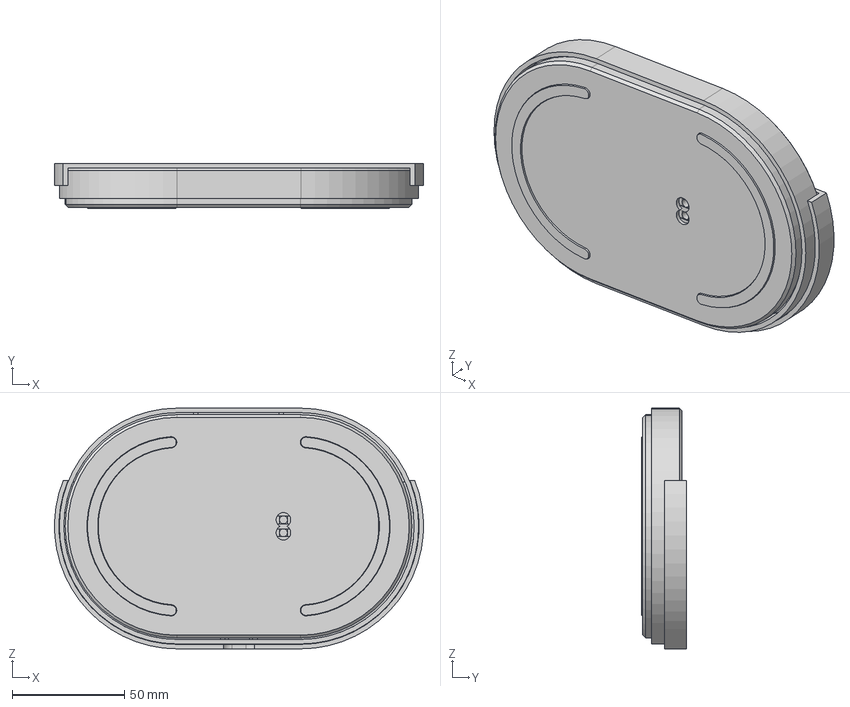
[picture p3: CAD file, 2024-04-07]
Scale Case/half_decent_scale v9.step
164.3 x 20.1 x 107.2 mm
SHELL3_8(镜像)
