decentespresso/openscale/docs/custom-build/scale-workbench.webp

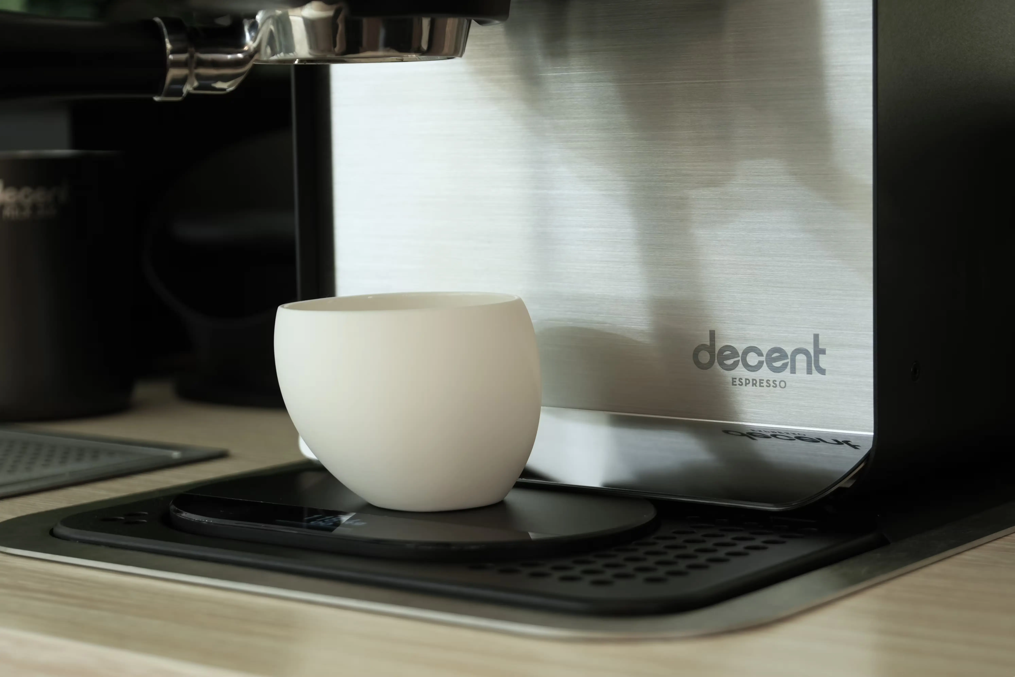
docs/custom-build/scale-workbench.webp
