decentespresso/openscale/(threads)

Thread 1 (2024-05-27):

Missing files so_boot_menu.h and so_wifi_ota.h

smc8050, 2024-05-27:
Can it be that the files `so_boot_menu.h` and `so_wifi_ota.h` used by the `2024-04-06_SofronioCoffeeRatioScale.ino` file are missing in this repository?
I have problems compiling the `.ino` file

decentjohn, 2024-05-28:
@Sofronio can you answer?

Sofronio, 2024-05-28:
those two files are added at version 4.2. Hope this helps.

smc8050, 2024-05-28:
Thank you, yes now I can upload it to the ESP32.
All files complete 👍

Closed 2024-05-28.

Thread 2 (2025-06-05):

hardware buttons disabled when connected to bluetooth

vasu2001, 2025-06-05:
DecentScale disables the tare and timer function through the button when it is connected to any bluetooth client. This means the client will have to implement those features at their end.

For clients like bean-conqueror where i want to only record the data, this becomes a nuisance to operate the scale from the app.

Ideally, there should be a flag that can turn those buttons back on to their default features. It can be defaulted to FALSE to maintain the current expected behaviour

decentjohn, 2025-06-05:
Agreed. We're implementing it.

decentjohn, 2025-06-05:
we're going to make the default be buttons-respond and there'll be a special BLE command to make buttons-not-respond, so I think there won't be any work for app programmers to do.

Sofronio, 2025-06-17:
This issue was resolved in release v2.7.3. 🎉
See: https://github.com/decentespresso/openscale/releases/tag/v2.7.3

Closed 2025-06-17.
