decentespresso/openscale/src/hds.ino

#include <Arduino.h>
#include <cstring>
#include "config.h"

#include "parameter.h"
#if HDS_ENABLE_ENERGY_MENU
#include "energy_idle_wake.h"
void applyEnergyDisplayCommand(bool enabled);
void applyEnergyLowPowerCommand();
void applyEnergyFeatureTransition(EnergyFeature feature, bool wasEnabled, bool isEnabled);
bool initEnergyPowerManagement();
bool applyEnergyLightSleepSetting(bool enabled);
bool setEnergyLightSleepEnabled(bool enabled);
void refreshEnergyIdleWakeForRuntimeState();
bool setEnergyPerformanceCritical(bool required);
void serviceEnergyPowerManagement();
bool setEnergyIdleWakeEnabled(bool enabled);
void waitForEnergyMainLoopWork();
#endif

#include "storage.h"
#include "power.h"
#include "gyro.h"
#include "display.h"
#include "declare.h"
#if HDS_FEATURE_WIFI
#include "wifi_setup.h"
#include <WiFi.h>
#endif
#if HDS_FEATURE_WEBSERVER
#include "webserver.h"
#endif
#include "websocket.h"
#if HDS_FEATURE_ELEGANT_OTA
#include "wifi_ota.h"
#endif
#if HDS_ENABLE_GRINDER
#include "grinder_runtime.h"
#endif
#if HDS_FEATURE_PULL_OTA
#include "pull_ota.h"
#include "ota_rollback.h"
#include "custom_build_ota.h"
#endif


#include "menu.h"
#include "ble.h"
#include "usbcomm.h"
#include "fuel_gauge.h"
#include "finger_detection.h"
#include "timing.h"
#include "tap_detection.h"

#if HDS_ENABLE_GRINDER
#ifndef GRINDER_MENU_CHORD_HOLD_MS
#define GRINDER_MENU_CHORD_HOLD_MS 500
#endif
#endif
bool handleMenuChord();

constexpr unsigned long BUTTON_POLL_INTERVAL_MS = 2;

bool anyScaleButtonPressed() {
  return digitalRead(BUTTON_CIRCLE) == LOW || digitalRead(BUTTON_SQUARE) == LOW;
}

void resetReleasedScaleButtons() {
  const uint16_t debounceDelay = config1.getDebounceDelay();
  config1.setDebounceDelay(0);
  buttonCircle.init(BUTTON_CIRCLE);
  buttonCircle.checkState(HIGH);
  buttonCircle.checkState(HIGH);
  buttonSquare.init(BUTTON_SQUARE);
  buttonSquare.checkState(HIGH);
  buttonSquare.checkState(HIGH);
  config1.setDebounceDelay(debounceDelay);
}

bool buttonChecksSuppressedUntilRelease() {
  if (!b_buttonChordSuppressUntilRelease) {
    return false;
  }
  if (!anyScaleButtonPressed()) {
    resetReleasedScaleButtons();
    b_buttonChordSuppressUntilRelease = false;
  }
  return true;
}

#if HDS_ENABLE_ENERGY_MENU
constexpr unsigned long ENERGY_ADC_SIGNAL_TIMEOUT_MS = 301;
constexpr unsigned long ENERGY_ADC_RECOVERY_START_MS = 1501;
constexpr unsigned long ENERGY_ADC_RECOVERY_RETRY_MS = 5001;
constexpr unsigned long ENERGY_DISPLAY_DEADLINE_MS = 500;
constexpr unsigned long ENERGY_USB_FALLBACK_POLL_MS = 10;
constexpr unsigned long ENERGY_BUTTON_RESPONSE_BOOST_MS = 50;

bool energyLightSleepButtonWake(uint64_t wakeMask) {
  return (wakeMask & energyLightSleepWakePinMask((gpio_num_t)BUTTON_CIRCLE)) != 0 ||
         (wakeMask & energyLightSleepWakePinMask((gpio_num_t)BUTTON_SQUARE)) != 0;
}

bool clearEnergyLightSleepProfileSelection() {
  energyPolicy.settings.select(EnergyFeature::LightSleep, false);
  energyPolicy.settings.select(EnergyFeature::LightSleepPlus, false);
  const bool lightStored = energyStoreFeature(EnergyFeature::LightSleep, false);
  const bool plusStored = energyStoreFeature(EnergyFeature::LightSleepPlus, false);
  updateEnergyMenuRow(EnergyFeature::LightSleep);
  return lightStored && plusStored;
}

bool energySerialTransportActive() {
#ifdef USB_DET
  return b_usbLinked || digitalRead(USB_DET) == LOW;
#else
  return true;
#endif
}

bool energyLightSleepAllowedByUsbPolicy() {
  return energyPolicy.settings.lightSleepAllowed(energySerialTransportActive());
}

bool energyUsbSleepTestActive() {
  return energyPolicy.settings.usbSleepTestActive();
}

bool setEnergyIdleWakeEnabled(bool enabled) {
  const bool scaleWakeEnabled = !b_softSleep;
  const bool usbWakeEnabled =
    !energyPolicy.featureEnabled(EnergyFeature::UsbSleepTest);
  if (enabled == energyIdle.wakeInterruptsAttached &&
      scaleWakeEnabled == energyIdle.scaleWakeEnabled &&
      usbWakeEnabled == energyIdle.usbWakeEnabled) return true;
  uint64_t rtcWakeMask = 0;
  if (!setEnergyLightSleepWakeSourceEnabled(
        enabled, scaleWakeEnabled, usbWakeEnabled, &rtcWakeMask)) {
    if (energyIdle.wakeInterruptsAttached) {
      detachInterrupt(digitalPinToInterrupt(SCALE_DOUT));
      detachInterrupt(digitalPinToInterrupt(BUTTON_CIRCLE));
      detachInterrupt(digitalPinToInterrupt(BUTTON_SQUARE));
#ifdef USB_DET
      detachInterrupt(digitalPinToInterrupt(USB_DET));
#endif
      energyIdle.wakeInterruptsAttached = false;
    }
    energyIdle.scaleWakeFallback = false;
    energyIdle.circleButtonWakeFallback = false;
    energyIdle.squareButtonWakeFallback = false;
    energyIdle.usbWakeFallback = false;
    energyIdle.rtcWakeMask = 0;
    return false;
  }
  const bool interruptsChanged = enabled != energyIdle.wakeInterruptsAttached;
  if (interruptsChanged && enabled) {
    attachInterruptArg(digitalPinToInterrupt(SCALE_DOUT), energyMainLoopWakeIsr,
                       energyIdle.mainTask, FALLING);
    attachInterruptArg(digitalPinToInterrupt(BUTTON_CIRCLE), energyMainLoopWakeIsr,
                       energyIdle.mainTask, FALLING);
    attachInterruptArg(digitalPinToInterrupt(BUTTON_SQUARE), energyMainLoopWakeIsr,
                       energyIdle.mainTask, FALLING);
#ifdef USB_DET
    attachInterruptArg(digitalPinToInterrupt(USB_DET), energyMainLoopWakeIsr,
                       energyIdle.mainTask, FALLING);
#endif
  } else if (interruptsChanged) {
    detachInterrupt(digitalPinToInterrupt(SCALE_DOUT));
    detachInterrupt(digitalPinToInterrupt(BUTTON_CIRCLE));
    detachInterrupt(digitalPinToInterrupt(BUTTON_SQUARE));
#ifdef USB_DET
    detachInterrupt(digitalPinToInterrupt(USB_DET));
#endif
  }
  energyIdle.wakeInterruptsAttached = enabled;
  energyIdle.scaleWakeEnabled = scaleWakeEnabled;
  energyIdle.usbWakeEnabled = usbWakeEnabled;
  energyIdle.scaleWakeFallback = enabled && scaleWakeEnabled &&
    !energyLightSleepWakePinSupported((gpio_num_t)SCALE_DOUT);
  energyIdle.circleButtonWakeFallback = enabled &&
    !energyLightSleepWakePinSupported((gpio_num_t)BUTTON_CIRCLE);
  energyIdle.squareButtonWakeFallback = enabled &&
    !energyLightSleepWakePinSupported((gpio_num_t)BUTTON_SQUARE);
#ifdef USB_DET
  energyIdle.usbWakeFallback = enabled && usbWakeEnabled &&
    !energyLightSleepWakePinSupported((gpio_num_t)USB_DET);
#else
  energyIdle.usbWakeFallback = enabled && usbWakeEnabled;
#endif
  energyIdle.rtcWakeMask = rtcWakeMask;
  return true;
}

bool initEnergyIdleWake() {
  if (energyIdle.lightSleepCallbackRegistered) return true;
  energyIdle.lightSleepCallbackRegistered =
    registerEnergyMainLoopLightSleepCallback(&energyIdle);
  return energyIdle.lightSleepCallbackRegistered;
}

bool setEnergyLightSleepEnabled(bool enabled) {
  if (enabled) {
    if (!energyPowerManagement.ready() ||
        !energyIdle.lightSleepCallbackRegistered ||
        !setEnergyIdleWakeEnabled(true)) {
      setEnergyIdleWakeEnabled(false);
      applyEnergyLightSleepSetting(false);
      return false;
    }
    if (applyEnergyLightSleepSetting(true)) return true;
    setEnergyIdleWakeEnabled(false);
    applyEnergyLightSleepSetting(false);
    return false;
  }
  const bool powerManagementDisabled = applyEnergyLightSleepSetting(false);
  const bool wakeDisabled = setEnergyIdleWakeEnabled(false);
  return powerManagementDisabled && wakeDisabled;
}

void refreshEnergyIdleWakeForRuntimeState() {
  if (!energyPolicy.featureEnabled(EnergyFeature::LightSleep) ||
      setEnergyIdleWakeEnabled(true)) return;
  setEnergyLightSleepEnabled(false);
  clearEnergyLightSleepProfileSelection();
  Serial.println("[energy] Light Sleep disabled after wake source failure");
}

uint64_t serviceEnergyLightSleepWakeRestore() {
  if (!energyIdle.wakePinsNeedRestore) return 0;
  energyIdle.wakePinsNeedRestore = false;
  const uint64_t wakeMask = esp_sleep_get_wakeup_cause() == ESP_SLEEP_WAKEUP_EXT1
                              ? esp_sleep_get_ext1_wakeup_status()
                              : 0;
  energyIdle.lastLightSleepWakeMask = wakeMask;
  if (energyLightSleepButtonWake(wakeMask)) {
    const unsigned long wakeAt = millis();
    energyIdle.buttonGestureActive = true;
    energyIdle.lastButtonActivityAt = wakeAt;
    energyIdle.lastLightSleepButtonWakeAt = wakeAt;
    energyIdle.lastLightSleepButtonPollAt = 0;
    energyIdle.lastLightSleepButtonEventAt = 0;
    energyIdle.lightSleepButtonTracePending = true;
    energyIdle.lightSleepButtonWakeCount++;
  }
  const bool restored = restoreEnergyLightSleepWakePins(energyIdle.rtcWakeMask);
  pinMode(SCALE_DOUT, INPUT);
  pinMode(BUTTON_CIRCLE, INPUT_PULLUP);
  pinMode(BUTTON_SQUARE, INPUT_PULLUP);
#ifdef USB_DET
  pinMode(USB_DET, INPUT_PULLUP);
#endif
  if (restored) return wakeMask;
  setEnergyLightSleepEnabled(false);
  clearEnergyLightSleepProfileSelection();
  Serial.println("[energy] Light Sleep disabled after wake pin restore failure");
  return 0;
}

bool serviceEnergyButtonGesture(unsigned long now) {
  if (!energyPolicy.featureEnabled(EnergyFeature::LightSleep)) return true;
  if (anyScaleButtonPressed()) {
    energyIdle.buttonGestureActive = true;
    energyIdle.lastButtonActivityAt = now;
  } else if (energyIdle.buttonGestureActive &&
             now - energyIdle.lastButtonActivityAt > DOUBLECLICK_DELAY) {
    energyIdle.buttonGestureActive = false;
    energyIdle.lightSleepButtonTracePending = false;
  }
  return energyIdle.buttonGestureActive;
}

bool energyResponsiveButtonBoostActive(unsigned long now) {
  return energyPolicy.featureEnabled(EnergyFeature::LightSleep) &&
         energyIdle.buttonGestureActive &&
         now - energyIdle.lastButtonActivityAt <= ENERGY_BUTTON_RESPONSE_BOOST_MS;
}

bool energyMainLoopHasPendingWork() {
  if ((!b_softSleep && digitalRead(SCALE_DOUT) == LOW) || wsPendingMask != 0 ||
      bleStatusResponsesPending != 0 || bleVoltageResponsesPending != 0 ||
      otaDisplayState != OTA_DISPLAY_NONE || b_powerOff) {
    return true;
  }
  return !b_softSleep && hasRemoteTareRequest();
}

bool energyMainLoopCanBlock() {
  const bool usbSleepTest = energyUsbSleepTestActive();
  const bool chargingBlocksSleep = !usbSleepTest &&
    (b_showChargingUI || b_is_charging ||
     GPIO_power_on_with == BATTERY_CHARGING);
  if (!energyLightSleepAllowedByUsbPolicy() ||
      b_ota || b_pullOtaRunning || b_menu || b_calibration ||
      chargingBlocksSleep) {
    return false;
  }
#if HDS_ENABLE_GRINDER
  if (grinderRuntimeKeepsAwake()) return false;
#endif
#if HDS_FEATURE_WIFI && !HDS_FEATURE_WEBSERVER
  if (b_wifiEnabled) return false;
#endif
  return true;
}

unsigned long energyMainLoopWaitMs(unsigned long now) {
  unsigned long waitMs = 200;
  if (!b_softSleep && scale.getSignalTimeoutFlag()) {
    const unsigned long dataWait = EnergyRuntimePolicy::timeUntil(
      now, energyIdle.lastScaleData, ENERGY_ADC_RECOVERY_START_MS);
    const unsigned long recoveryWait = EnergyRuntimePolicy::timeUntil(
      now, energyIdle.lastScaleRecovery, ENERGY_ADC_RECOVERY_RETRY_MS);
    waitMs = max(dataWait, recoveryWait);
  } else if (!b_softSleep) {
    waitMs = EnergyRuntimePolicy::timeUntil(
      now, energyIdle.lastScaleData, ENERGY_ADC_SIGNAL_TIMEOUT_MS);
  }

  if (!b_softSleep && energyIdle.scaleWakeFallback) {
    const float conversionMs = scale.getConversionTime();
    const unsigned long scalePollMs = isfinite(conversionMs) && conversionMs >= 1.0f
      ? static_cast<unsigned long>(ceilf(conversionMs))
      : ADS1232_DEFAULT_CONVERSION_MS;
    waitMs = EnergyRuntimePolicy::earlier(
      waitMs, EnergyRuntimePolicy::timeUntil(
        now, energyIdle.lastScaleData, max(1UL, scalePollMs)));
  }

  if (energyIdle.circleButtonWakeFallback ||
      energyIdle.squareButtonWakeFallback) {
    waitMs = EnergyRuntimePolicy::earlier(waitMs, BUTTON_POLL_INTERVAL_MS);
  }

  if (energyIdle.usbWakeFallback) {
    waitMs = EnergyRuntimePolicy::earlier(waitMs, ENERGY_USB_FALLBACK_POLL_MS);
  }

  if (anyScaleButtonPressed() || energyIdle.buttonGestureActive) {
    waitMs = EnergyRuntimePolicy::earlier(
      waitMs, EnergyRuntimePolicy::timeUntil(
        now, energyIdle.lastButtonPoll, BUTTON_POLL_INTERVAL_MS));
  }

  const bool weightOutputActive = b_weight_in_serial || b_usbweight_enabled ||
                                  bleHasLiveClient()
#if HDS_FEATURE_WEBSOCKET
                                  || (b_wifiEnabled && websocketHasClients())
#endif
                                  ;
  if (!b_softSleep && weightOutputActive) {
    waitMs = EnergyRuntimePolicy::earlier(
      waitMs, EnergyRuntimePolicy::timeUntil(
        now, energyIdle.lastWeightTick, WEIGHT_BASE_INTERVAL_MS));
  }

  if (stopWatch.isRunning()) {
    waitMs = EnergyRuntimePolicy::earlier(waitMs, 1000);
  }
  if (!b_u8g2Sleep) {
    waitMs = EnergyRuntimePolicy::earlier(waitMs, ENERGY_DISPLAY_DEADLINE_MS);
  }
  waitMs = EnergyRuntimePolicy::earlier(waitMs, 200);
  if (!b_softSleep) {
    waitMs = EnergyRuntimePolicy::earlier(
      waitMs, EnergyRuntimePolicy::timeUntil(
        now, t_batteryRefresh, i_batteryRefreshTareInterval));
  }

#if HDS_FEATURE_WIFI
  if (b_wifiEnabled) {
    waitMs = EnergyRuntimePolicy::earlier(waitMs, WIFI_SUPERVISE_INTERVAL_MS);
  }
#endif

  if (bleHasLiveClient() && b_requireHeartBeat) {
    unsigned long heartbeatWait = max(
      EnergyRuntimePolicy::timeUntil(now, t_firstConnect, HEARTBEAT_TIMEOUT + 1),
      EnergyRuntimePolicy::timeUntil(now, t_heartBeat, HEARTBEAT_TIMEOUT + 1));
    if (t_lastDisconnectAttempt != 0) {
      heartbeatWait = max(
        heartbeatWait,
        EnergyRuntimePolicy::timeUntil(
          now, t_lastDisconnectAttempt, HEARTBEAT_DISCONNECT_RETRY_INTERVAL));
    }
    waitMs = EnergyRuntimePolicy::earlier(waitMs, heartbeatWait);
  }
  return waitMs;
}

void waitForEnergyMainLoopWork() {
  if (!energyMainLoopCanBlock() || energyMainLoopHasPendingWork()) return;
  const unsigned long waitMs = energyMainLoopWaitMs(millis());
  if (waitMs == 0) return;
  TickType_t waitTicks = pdMS_TO_TICKS(waitMs);
  if (waitTicks == 0) waitTicks = 1;
  ulTaskNotifyTake(pdTRUE, waitTicks);
}
#endif

bool serviceScaleButtonInputs(bool forcePoll) {
  const bool buttonInputAllowed = !b_ota
      && !buttonChecksSuppressedUntilRelease()
      && !handleMenuChord()
      ;
  if (!buttonInputAllowed) return false;
  const unsigned long buttonNow = millis();
#if HDS_ENABLE_ENERGY_MENU
  const bool gestureWasActive = energyIdle.buttonGestureActive;
  const bool gestureActive = serviceEnergyButtonGesture(buttonNow);
  const bool gestureExpired = gestureWasActive && !gestureActive;
  const bool buttonPollDue = forcePoll || gestureExpired ||
    (gestureActive &&
     hdsIntervalElapsed(buttonNow, energyIdle.lastButtonPoll, BUTTON_POLL_INTERVAL_MS));
  if (buttonPollDue) energyIdle.lastButtonPoll = buttonNow;
#else
  static unsigned long lastButtonPoll = 0;
  const bool buttonPollDue = forcePoll ||
    hdsIntervalElapsed(buttonNow, lastButtonPoll, BUTTON_POLL_INTERVAL_MS);
  if (buttonPollDue) lastButtonPoll = buttonNow;
#endif
  if (!buttonPollDue) return false;
#if HDS_ENABLE_ENERGY_MENU
  if (forcePoll && energyIdle.lightSleepButtonTracePending &&
      energyIdle.lastLightSleepButtonPollAt == 0) {
    energyIdle.lastLightSleepButtonPollAt = buttonNow;
  }
  const uint8_t previousCircleState = buttonCircle.getLastButtonState();
  const uint8_t previousSquareState = buttonSquare.getLastButtonState();
#endif
  buttonCircle.check();
  buttonSquare.check();
#if HDS_ENABLE_ENERGY_MENU
  if ((previousCircleState == LOW && buttonCircle.getLastButtonState() == HIGH) ||
      (previousSquareState == LOW && buttonSquare.getLastButtonState() == HIGH)) {
    energyIdle.lastButtonActivityAt = millis();
    energyIdle.buttonGestureActive = true;
  }
#endif
  return true;
}

#if HDS_ENABLE_ENERGY_MENU
void primeScaleButtonInputs() {
  buttonCircle.check();
  buttonSquare.check();
  const unsigned long startedAt = millis();
  while (millis() - startedAt < config1.getDebounceDelay()) {
    delay(BUTTON_POLL_INTERVAL_MS);
  }
  buttonCircle.check();
  buttonSquare.check();
  serviceEnergyButtonGesture(millis());
}

void finishEnergyButtonWakeDebounce() {
  if (energyPolicy.settings.lightSleepPlusActive()) return;
  const unsigned long startedAt = millis();
  const unsigned long debounceMs = config1.getDebounceDelay();
  while ((buttonCircle.isPressedRaw() && buttonCircle.getLastButtonState() != LOW) ||
         (buttonSquare.isPressedRaw() && buttonSquare.getLastButtonState() != LOW)) {
    if (millis() - startedAt >= debounceMs + BUTTON_POLL_INTERVAL_MS) break;
    delay(BUTTON_POLL_INTERVAL_MS);
    if (!serviceScaleButtonInputs(true)) break;
  }
}
#endif

void adsDebugCallback(const ADS1232DebugInfo& info) {
  static unsigned long lastDebugPrint = 0;
  unsigned long now = millis();

  if (now - lastDebugPrint >= 1000) {
    Serial.println("=== ADS1232 Debug Info ===");
    Serial.print("Timestamp: "); Serial.println(info.timestamp);
    Serial.print("Raw Value: "); Serial.print(info.rawValue);
    Serial.print(" | Smoothed: "); Serial.println(info.smoothedValue);
    Serial.print("Tare Offset: "); Serial.println(info.tareOffset);
    Serial.print("Conv Time: "); Serial.print(info.conversionTimeMs, 3);
    Serial.print("ms | SPS: "); Serial.println(info.sps, 2);
    Serial.print("Samples: "); Serial.print(info.samplesInUse);
    Serial.print(" | Valid: "); Serial.print(info.validSamples);
    Serial.print(" | Read Index: "); Serial.println(info.readIndex);

    Serial.print("Flags - OutOfRange: "); Serial.print(info.dataOutOfRange);
    Serial.print(" | SignalTimeout: "); Serial.println(info.signalTimeout);
    Serial.println("==========================");

    lastDebugPrint = now;
  }
}


void aceButtonHandleEvent(AceButton *button, uint8_t eventType, uint8_t buttonState) {
  power_off(-1);
  const bool chargingUi = chargingUiActive();
#if HDS_ENABLE_ENERGY_MENU
  if (!chargingUi && b_u8g2Sleep && !energyRuntime.explicitDisplayOff) {
    u8g2.setPowerSave(0);
    b_u8g2Sleep = false;
  }
#else
  if (!chargingUi && b_u8g2Sleep) {
    u8g2.setPowerSave(0);
    b_u8g2Sleep = false;
  }
#endif
  if (!chargingUi && b_softSleep) {
    Serial.println("Exit Soft Sleep.");
    wakeScaleFromSoftSleep("button soft wake");
  }
#if HDS_ENABLE_ENERGY_MENU
  if (!chargingUi && !energyRuntime.explicitDisplayOff) {
    u8g2.setContrast(255);
    b_websocketLowPowerEnabled = false;
    energyRuntime.requestedDisplayContrast = 255;
  }
#else
  if (!chargingUi) {
    u8g2.setContrast(255);
    b_websocketLowPowerEnabled = false;
  }
#endif
  int pin = button->getPin();
  switch (eventType) {
    case AceButton::kEventPressed:
#if HDS_ENABLE_ENERGY_MENU
      if (energyIdle.lightSleepButtonTracePending) {
        energyIdle.lastLightSleepButtonEventAt = millis();
        energyIdle.lightSleepButtonTracePending = false;
      }
#endif
#ifdef BUZZER
      if (GPIO_power_on_with != BATTERY_CHARGING)
        buzzer.beep(1, BUZZER_DURATION);
#endif
      if (b_menu) {
        recordEnergyActivity();
        if (pin == BUTTON_CIRCLE) {
          b_menuCirclePressPending = true;
          b_menuCircleLongHandled = false;
        } else if (pin == BUTTON_SQUARE) {
          b_menuSquarePressPending = true;
          b_menuSquareLongHandled = false;
        }
        break;
      }
      switch (pin) {
        case BUTTON_CIRCLE:
          buttonCircle_Pressed();
          break;
        case BUTTON_SQUARE:
          buttonSquare_Pressed();
          break;
      }
      break;
    case AceButton::kEventDoubleClicked:
      switch (pin) {
        case BUTTON_CIRCLE:
          buttonCircle_DoubleClicked();
          break;
        case BUTTON_SQUARE:
          buttonSquare_DoubleClicked();
          break;
      }
      break;
    case AceButton::kEventLongPressed:
      if (pin == BUTTON_CIRCLE && b_menuCirclePressPending) {
        b_menuCircleLongHandled = true;
        navigateMenu(-1);
        break;
      }
      if (pin == BUTTON_SQUARE && b_menuSquarePressPending) {
        b_menuSquareLongHandled = true;
        backMenu();
        break;
      }
      switch (pin) {
        case BUTTON_CIRCLE:
          buttonCircle_LongPressed();
          break;
        case BUTTON_SQUARE:
          buttonSquare_LongPressed();
          break;
      }
      break;
    case AceButton::kEventReleased:
      if (pin == BUTTON_CIRCLE && b_menuCirclePressPending) {
        if (!b_menuCircleLongHandled && b_menu) navigateMenu(1);
        b_menuCirclePressPending = false;
        b_menuCircleLongHandled = false;
        break;
      }
      if (pin == BUTTON_SQUARE && b_menuSquarePressPending) {
        if (!b_menuSquareLongHandled && b_menu) selectMenu();
        b_menuSquarePressPending = false;
        b_menuSquareLongHandled = false;
        break;
      }
      switch (pin) {
        case BUTTON_CIRCLE:
          buttonCircle_Released();
          break;
        case BUTTON_SQUARE:
          buttonSquare_Released();
          break;
      }
      break;
  }
}

void scaleTimer() {
  if (stopWatch.isRunning() == false) {
    if (stopWatch.elapsed() == 0) {
      stopWatch.start();
      recordEnergyActivity();
      Serial.println("Timer Start");
    }
    if (stopWatch.elapsed() > 0) {
      stopWatch.reset();
      recordEnergyActivity();
      Serial.println("Timer Reset");
    }
  } else {
    stopWatch.stop();
    recordEnergyActivity();
    Serial.println("Timer Stop");
  }
}

void enterUsbStandby() {
  b_powerOff = false;
  if (b_menu || b_calibration) return;
#if HDS_ENABLE_GRINDER
  if (grinderSettings.enabled &&
      (grinderRuntime.state == GRINDER_STATE_ARMED ||
       grinderRuntime.state == GRINDER_STATE_GRINDING ||
       grinderRuntime.state == GRINDER_STATE_STOPPING ||
       grinderRuntime.state == GRINDER_STATE_ERROR ||
       grinderRuntime.relayOn || grinderRuntime.recovery.active)) {
    Serial.println("USB standby blocked: stop grinder first");
    return;
  }
#endif
  if (b_softSleep) wakeScaleFromSoftSleep("USB standby");
  b_shutdownFailBle = false;
  GPIO_power_on_with = BATTERY_CHARGING;
  b_showChargingUI = b_chargingOLED;
  b_buttonChordSuppressUntilRelease = true;
  circle_press_data = {};
  square_press_data = {};
#if HDS_ENABLE_GRINDER
  grinderPauseForMenu();
#endif
#if HDS_ENABLE_ENERGY_MENU
  requestEnergyDisplay(b_chargingOLED);
  applyEnergyDisplayCommand(b_chargingOLED);
#else
  b_u8g2Sleep = !b_chargingOLED;
  u8g2.setPowerSave(!b_chargingOLED);
#endif
  Serial.println("USB charging standby");
}

void wakeFromChargingUi(uint8_t buttonPin) {
  if (!chargingUiActive()) return;
  if (b_softSleep) wakeScaleFromSoftSleep("charging button wake");
  GPIO_power_on_with = buttonPin;
  b_showChargingUI = false;
  b_is_charging = false;
  b_buttonChordSuppressUntilRelease = true;
  circle_press_data = {};
  square_press_data = {};
#if HDS_ENABLE_GRINDER
  grinderResumeAfterMenu();
#endif
#if HDS_ENABLE_ENERGY_MENU
  requestEnergyDisplay(true);
  applyEnergyDisplayCommand(true);
#else
  b_u8g2Sleep = false;
  u8g2.setPowerSave(0);
#endif
  if (!b_ble_enabled) {
    b_ble_enabled = true;
    ble_init();
  }
#if HDS_FEATURE_WIFI
  if (!b_wifiEnabled) {
    wifi_init();
  }
#endif
}

void buttonCircle_Released() {
  Serial.println("O button released");
  onButtonReleased(BUTTON_CIRCLE);
}

void buttonCircle_Pressed() {
  recordEnergyActivity();
  if (chargingUiActive()) {
    if (i_buttonBootDelay == 0) wakeFromChargingUi(BUTTON_CIRCLE);
    return;
  }

  if (b_menu) {
    navigateMenu(1);
  }
  if (b_calibration) {
    recordEnergyActivity();
    i_cal_weight++;
    Serial.print("i_cal_weight = ");
    Serial.println(i_cal_weight);
    if (i_cal_weight > 5)
      i_cal_weight = 0;
  }
  if (!b_calibration) {
    startPressSampling(BUTTON_CIRCLE);
  }
}
void buttonSquare_Released() {
  Serial.println("□ button released");
  if (!b_calibration) {
    onButtonReleased(BUTTON_SQUARE);
  }
}

void buttonSquare_Pressed() {
  recordEnergyActivity();
  if (chargingUiActive()) {
    if (i_buttonBootDelay == 0) wakeFromChargingUi(BUTTON_SQUARE);
    return;
  }
  if (b_menu) {
    selectMenu();
  } else if (b_calibration) {
    recordEnergyActivity();
    i_button_cal_status++;
    Serial.print("i_button_cal_status:");
    Serial.println(i_button_cal_status);
  }
  if (bleHasLiveClient() && millis() - t_shutdownFailBle < 3000 && !b_menu && !b_calibration && millis() - t_menuExitTime > 1000) {
    Serial.println("Going to sleep now by SquarePress");
    b_powerOff = true;
  }
  if (!b_calibration) {
    startPressSampling(BUTTON_SQUARE);
  }
}

void setButtonPressConfig(int button, float min_peak, float max_net,
                         float min_recovery, unsigned long max_press_time,
                         unsigned long min_total_time) {
  Serial.print("Button config updated for ");
  Serial.print(button == BUTTON_CIRCLE ? "Circle" : "Square");
  Serial.print(": min_peak=");
  Serial.print(min_peak);
  Serial.print(", max_net=");
  Serial.print(max_net);
  Serial.print(", min_recovery=");
  Serial.print(min_recovery);
  Serial.println();
}



void buttonCircle_DoubleClicked() {
  Serial.println("O button double clicked");
  const bool bleClientLive = bleHasLiveClient();
  if (!bleClientLive && !b_menu && !b_calibration) {
    Serial.println("Going to sleep now by CircleDoubleClick");
    sendBlePowerOff(1);
#if HDS_FEATURE_WEBSOCKET
    sendWebsocketPowerOff(1);
#endif
    b_powerOff = true;
  } else {
    if (bleClientLive) {
      t_shutdownFailBle = millis();
      b_shutdownFailBle = true;
      Serial.println("BLE connected, not going to sleep.");
    }
    if (b_menu)
      Serial.println("Menu operating, not going to sleep.");
    if (!b_menu) {
      sendBlePowerOff(0);
#if HDS_FEATURE_WEBSOCKET
      sendWebsocketPowerOff(0);
#endif
    }
  }
}

void buttonSquare_DoubleClicked() {
  Serial.println("[] button double clicked");
  const bool bleClientLive = bleHasLiveClient();
  if (!bleClientLive && !b_menu && !b_calibration) {
    Serial.println("Going to sleep now by SquareDoubleClick");
    sendBlePowerOff(2);
#if HDS_FEATURE_WEBSOCKET
    sendWebsocketPowerOff(2);
#endif
    b_powerOff = true;
  } else {
    if (bleClientLive) {
      t_shutdownFailBle = millis();
      b_shutdownFailBle = true;
      Serial.println("BLE connected, not going to sleep.");
    }
    if (b_menu)
      Serial.println("Menu operating, not going to sleep.");
    if (!b_menu) {
      sendBlePowerOff(0);
#if HDS_FEATURE_WEBSOCKET
      sendWebsocketPowerOff(0);
#endif
    }
  }
}

void buttonCircle_LongPressed() {
  if (!b_menu) {
    Serial.println("O button long pressed");
#ifdef BUZZER
    buzzer.beep(1, 200);
#endif
    if (GPIO_power_on_with == BATTERY_CHARGING) {
      wakeFromChargingUi(BUTTON_CIRCLE);
    }
  }
}

void buttonSquare_LongPressed() {
  if (!b_menu) {
    Serial.println("[] button long pressed");
#ifdef BUZZER
    buzzer.beep(1, 200);
#endif
    if (GPIO_power_on_with == BATTERY_CHARGING) {
      wakeFromChargingUi(BUTTON_SQUARE);
    }
  }
}

bool handleMenuChord() {
  const bool bothPressed = digitalRead(BUTTON_CIRCLE) == LOW && digitalRead(BUTTON_SQUARE) == LOW;
#if HDS_ENABLE_GRINDER
  const bool grinderMenuRequested = grinderSettings.enabled && GPIO_power_on_with != BATTERY_CHARGING;
  const unsigned long holdMs = GRINDER_MENU_CHORD_HOLD_MS;
#else
  const bool grinderMenuRequested = false;
  const unsigned long holdMs = 500;
#endif
  if (!bothPressed || b_menu || b_calibration ||
      (!grinderMenuRequested && !usbPowerKeepsAwake())) {
    menuChordPressedAt = 0;
    return false;
  }
  const unsigned long now = millis();
  if (menuChordPressedAt == 0) {
    menuChordPressedAt = now;
    return true;
  }
  if (now - menuChordPressedAt < holdMs) {
    return true;
  }
  wakeFromChargingUi(BUTTON_SQUARE);
  b_menu = true;
  invalidateMenuFrame();
  b_buttonChordSuppressUntilRelease = true;
  circle_press_data = {};
  square_press_data = {};
  currentMenu = mainMenu;
  currentMenuSize = getMenuSize(mainMenu);
#if HDS_ENABLE_GRINDER
  b_grinderMenuDirectEntry = grinderMenuRequested;
  if (grinderMenuRequested) {
    currentMenu = grinderMenu;
    currentMenuSize = getMenuSize(grinderMenu);
  }
  grinderPauseForMenu();
#endif
  currentIndex = 0;
  currentSelection = currentMenu[currentIndex];
  menuChordPressedAt = 0;
  Serial.println("Menu chord");
  return true;
}


void button_init() {
  pinMode(BUTTON_CIRCLE, INPUT_PULLUP);
  pinMode(BUTTON_SQUARE, INPUT_PULLUP);
  buttonCircle.init(BUTTON_CIRCLE);
  buttonSquare.init(BUTTON_SQUARE);
  config1.setEventHandler(aceButtonHandleEvent);
  config1.setFeature(ButtonConfig::kFeatureClick);
  config1.setFeature(ButtonConfig::kFeatureDoubleClick);
  config1.setFeature(ButtonConfig::kFeatureLongPress);
  config1.setClickDelay(CLICK_DELAY);
  config1.setDoubleClickDelay(DOUBLECLICK_DELAY);
  config1.setLongPressDelay(LONGPRESS_DELAY);
}

#if HDS_FEATURE_WIFI
void _wifi_init(void *args) {
  wifiWorkerStarted();
  bool transportsStarted = false;
  for (;;) {
    if (!transportsStarted || (!b_wifiEnabled && wifiWorkerNeedsStart())) {
      setupWifi();
      if (b_wifiEnabled) {
#if HDS_FEATURE_ELEGANT_OTA
        wifiOta();
#endif
#if HDS_FEATURE_WEBSOCKET
        setupWebsocketEvents();
#endif
#if HDS_FEATURE_WEBSERVER
        startWebServer();
#endif
        transportsStarted = true;
      }
    }
    wifiSupervise();
    vTaskDelay(pdMS_TO_TICKS(WIFI_SUPERVISE_INTERVAL_MS));
  }
}
void wifi_init() {
  if (!b_wifiOnBoot) {
    return;
  }
  if (!wifiRequestWorkerStart()) return;
  if (xTaskCreate(_wifi_init, "Wifi Init Task", configMINIMAL_STACK_SIZE + 6144,
                  NULL, 0, NULL) != pdPASS) {
    wifiWorkerStartFailed();
    Serial.println("WiFi worker startup failed");
  }
}
#endif

MyUsbCallbacks usbCallbacks;

const char *resetReasonStr(esp_reset_reason_t r) {
  switch (r) {
    case ESP_RST_POWERON:   return "poweron";
    case ESP_RST_EXT:       return "ext";
    case ESP_RST_SW:        return "sw";
    case ESP_RST_PANIC:     return "panic";
    case ESP_RST_INT_WDT:   return "int_wdt";
    case ESP_RST_TASK_WDT:  return "task_wdt";
    case ESP_RST_WDT:       return "wdt";
    case ESP_RST_DEEPSLEEP: return "deepsleep";
    case ESP_RST_BROWNOUT:  return "brownout";
    case ESP_RST_SDIO:      return "sdio";
    default:                return "unknown";
  }
}

#if HDS_ENABLE_GRINDER
void beforeDeepSleepFlush() {
  grinderFlushSettingsIfDirty();
}
#endif

void setup() {
  wowMicroWakeOrContinue();
#if HDS_ENABLE_ENERGY_MENU
  energyIdle.mainTask = xTaskGetCurrentTaskHandle();
#endif
  Serial.begin(115200);
  while (!Serial)
    ;
  {
    esp_reset_reason_t r = esp_reset_reason();
    g_resetReasonCode = (uint8_t)r;
    Serial.printf("[boot] reset_reason=%s (%u)\n", resetReasonStr(r), (unsigned)g_resetReasonCode);
#if HDS_FEATURE_PULL_OTA
    hdsOtaRollbackBegin(r);
#endif
  }
  if (!storageInit()) {
    Serial.println("NVS settings init failed!");
    while (1) {
      delay(1000);
    }
  }
#if HDS_ENABLE_ENERGY_MENU
  if (!energyLoadSettings(energyPolicy.settings)) {
    Serial.println("Energy settings init failed!");
    while (1) {
      delay(1000);
    }
  }
  if (energyPolicy.featureEnabled(EnergyFeature::UsbSleepTest)) {
    Serial.println("[energy] USB Sleep Test ON: USB serial reliability not guaranteed");
  }
  if (!initEnergyPowerManagement() || !applyEnergyLightSleepSetting(false)) {
    Serial.println("[energy] Light Sleep unavailable; continuing awake");
  }
  energyPolicy.begin(millis());
  refreshEnergyMenuRows();
#endif
#if HDS_ENABLE_GRINDER
  grinderLoadSettings();
#endif

  b_quickBoot = storageGetBool(KEY_QUICK_BOOT, false);
  i_buttonBootDelay = b_quickBoot ? 0 : 500;
  i_wow_interval = storageGetInt(KEY_WOW_INTERVAL, 0);

  Serial.println("NVS settings init success");

  usbCallbacks.setStableOutputThreshold = setStableOutputThreshold;
  usbCallbacks.setTrackingThreshold = setTrackingThreshold;
  usbCallbacks.setTrackingUpdateInterval = setTrackingUpdateInterval;
  usbCallbacks.buttonSquare_Pressed = buttonSquare_Pressed;
  usbCallbacks.buttonCircle_Pressed = buttonCircle_Pressed;
  usbCallbacks.toggleTimer = scaleTimer;
#ifdef ESP32
  releaseWakePinsFromRtcMode();
#endif
  button_init();
  pinMode(BATTERY_CHARGING, INPUT_PULLUP);
#if defined(V7_4) || defined(V7_5) || defined(V8_0) || defined(V8_1) || defined(V9_0_5)
  pinMode(USB_DET, INPUT_PULLUP);
  pinMode(OLED_CS, OUTPUT);
  pinMode(OLED_DC, OUTPUT);
  pinMode(SCALE_PDWN, OUTPUT);
  pinMode(SCALE_SCLK, OUTPUT);
  pinMode(PWR_CTRL, OUTPUT);
#endif
  print_wakeup_reason();
  Serial.println("GPIO_power_on_with = " + String(GPIO_power_on_with));

  if (GPIO_power_on_with == BATTERY_CHARGING)
    b_is_charging = true;
  if (GPIO_power_on_with == BUTTON_CIRCLE)
    b_ble_enabled = true;
  else {
    b_ble_enabled = false;
  }
  if (GPIO_power_on_with == -1) {
    b_ble_enabled = true;
  }
  while (true && GPIO_power_on_with > 0) {
    if (GPIO_power_on_with == BATTERY_CHARGING && usbPowerKeepsAwake()) break;
#ifdef ADS1232ADC
    if (wowButtonWake) break;
#endif
    if (i_buttonBootDelay == 0){
      Serial.println("Quick boot. Powering on...");
      break;
    }

    if (digitalRead(GPIO_power_on_with) == LOW) {
      if (!b_button_pressed) {
        t_power_on_button = millis();
        b_button_pressed = true;
      }

      if (millis() - t_power_on_button >= i_buttonBootDelay) {
        Serial.println("Button held for 0.5 second. Powering on...");
        break;
      }
    } else {
      Serial.println("Button released before 0.5 second.");
      Serial.println("Going to sleep now.");
      esp32_sleep();
      break;
      b_button_pressed = false;
    }
  }
  pinMode(PWR_CTRL, OUTPUT);
  digitalWrite(PWR_CTRL, HIGH);
  pinMode(OLED_SDIN, OUTPUT);
  digitalWrite(OLED_SDIN, LOW);
  pinMode(OLED_SCLK, OUTPUT);
  digitalWrite(OLED_SCLK, LOW);
  pinMode(OLED_DC, OUTPUT);
  digitalWrite(OLED_DC, LOW);
  pinMode(OLED_RST, OUTPUT);
  digitalWrite(OLED_RST, HIGH);
  pinMode(OLED_CS, OUTPUT);
  digitalWrite(OLED_CS, HIGH);
  pinMode(SCALE_SCLK, OUTPUT);
  digitalWrite(SCALE_SCLK, LOW);
  pinMode(SCALE_PDWN, OUTPUT);
  digitalWrite(SCALE_PDWN, HIGH);
  pinMode(SCALE_DOUT, INPUT);
  pinMode(SCALE2_SCLK, OUTPUT);
  digitalWrite(SCALE2_SCLK, LOW);
  pinMode(SCALE2_PDWN, OUTPUT);
  digitalWrite(SCALE2_PDWN, HIGH);
  pinMode(SCALE2_DOUT, INPUT);
  pinMode(I2C_SCL, INPUT_PULLUP);
  pinMode(I2C_SDA, INPUT_PULLUP);
  gpio_hold_dis((gpio_num_t)OLED_SDIN);
  gpio_hold_dis((gpio_num_t)OLED_SCLK);
  gpio_hold_dis((gpio_num_t)OLED_DC);
  gpio_hold_dis((gpio_num_t)OLED_RST);
  gpio_hold_dis((gpio_num_t)OLED_CS);
  gpio_hold_dis((gpio_num_t)SCALE_SCLK);
  gpio_hold_dis((gpio_num_t)SCALE_PDWN);
  gpio_hold_dis((gpio_num_t)SCALE_DOUT);
  gpio_hold_dis((gpio_num_t)SCALE2_SCLK);
  gpio_hold_dis((gpio_num_t)SCALE2_PDWN);
  gpio_hold_dis((gpio_num_t)SCALE2_DOUT);
  gpio_hold_dis((gpio_num_t)I2C_SCL);
  gpio_hold_dis((gpio_num_t)I2C_SDA);
  gpio_hold_dis((gpio_num_t)PWR_CTRL);

#if defined(V7_3) || defined(V7_4) || defined(V7_5) || defined(V8_0) || defined(V8_1) || defined(V9_0_5)
  gpio_hold_dis((gpio_num_t)ACC_PWR_CTRL);
#endif
  gpio_deep_sleep_hold_dis();
#ifdef ESP32
  Wire.begin(I2C_SDA, I2C_SCL);
#endif
  b_batteryProtect = storageGetBool(KEY_BAT_PROTECT, false);
  const int storedBatteryCapacity = storageGetInt(KEY_BAT_CAPACITY, 0);
  const uint16_t batteryCapacity = storedBatteryCapacity >= 300 && storedBatteryCapacity <= 2000
      ? static_cast<uint16_t>(storedBatteryCapacity) : 0;
  fuelGaugeBegin(batteryCapacity, storageGetBool(KEY_BAT_CAPACITY_SET, false));
  if (fuelGaugeLegacyHardware()) {
    pinMode(ACC_PWR_CTRL, OUTPUT);
    digitalWrite(ACC_PWR_CTRL, HIGH);
  }
#ifdef HW_SPI
  SPI.begin(OLED_SCLK, -1, OLED_SDIN, OLED_CS);
#endif
#ifdef ADS1115ADC
  if (fuelGaugeLegacyHardware()) {
    ADS_init();
  }
#endif
  delay(50);
  b_requireHeartBeat = storageGetBool(KEY_HEARTBEAT, true);
  Serial.println("Begin!");
#if defined(ACC_MPU6050) || defined(ACC_BMA400)
  ACC_init();
  Serial.println("ACC_init complete");
  if (b_gyroEnabled) {
#ifdef GYROFACEUP
#if HDS_ENABLE_ENERGY_MENU
    const double bootGyroZUp = gyro_z(true);
#else
    const double bootGyroZUp = gyro_z();
#endif
    if (bootGyroZUp < 8) {
      Serial.print("gyro_z:");
      Serial.println(bootGyroZUp);
      shut_down_now_accidentTouch();
    }
#endif
#ifdef GYROFACEDOWN
#if HDS_ENABLE_ENERGY_MENU
    const double bootGyroZDown = gyro_z(true);
#else
    const double bootGyroZDown = gyro_z();
#endif
    if (bootGyroZDown > -8) {
      Serial.print("gyro_z:");
      Serial.println(bootGyroZDown);
      shut_down_now_accidentTouch();
    }
#endif
  }
#endif
  analogReadResolution(ADC_BIT);
#ifdef BUZZER
  pinMode(BUZZER, OUTPUT);
  b_beep = storageGetInt(KEY_BEEP, 1);

  if (GPIO_power_on_with != BATTERY_CHARGING) {
    buzzer.beep(1, BUZZER_DURATION);
  }
#endif
  u8g2.begin();
  b_u8g2Sleep = false;
  u8g2.enableUTF8Print();
  u8g2.setContrast(255);
  u8g2.setFont(FONT_M);
  power_off(15);
  b_screenFlipped = storageGetBool(KEY_SCREEN_FLIP, false);
  if (b_screenFlipped)
    u8g2.setDisplayRotation(U8G2_R0);
  else
    u8g2.setDisplayRotation(U8G2_R2);

  invalidateEnergyOledFrame();
  u8g2.firstPage();
  do {
    u8g2.setFont(u8g2_font_logisoso22_tf);
    u8g2.drawStr(AC("Half"), 26, "Half");
    u8g2.drawBox(4, LCDHeight / 2, LCDWidth - 4 * 2, 2);
    u8g2.drawStr(AC("Decent"), LCDHeight - 2, "Decent");
  } while (u8g2.nextPage());
  unsigned long stabilizingtime = 500;
  scale.begin();
  scale.setSamplesInUse(1);
  scale.start(stabilizingtime, false);
  resetAdcRecoveryState();
  scale.setCalFactor(f_calibration_value);

  scale.setDebugCallback(adsDebugCallback);


  stopWatch.setResolution(StopWatch::SECONDS);
  stopWatch.start();
  stopWatch.reset();
  INPUTCOFFEEPOUROVER = storageGetFloat(KEY_POUROVER, 16.0f);
  INPUTCOFFEEESPRESSO = storageGetFloat(KEY_ESPRESSO, 18.0f);
  f_batteryCalibrationFactor = storageGetFloat(KEY_BAT_CAL, storageBatteryCalibrationDefault());
  b_mode = storageGetInt(KEY_MODE, 0);
  f_maxDriftCompensation = storageGetFloat(KEY_DRIFT_MAX, 0.05f);

  if (isnan(INPUTCOFFEEPOUROVER)) {
    INPUTCOFFEEPOUROVER = 16.0;
    storagePutFloat(KEY_POUROVER, INPUTCOFFEEPOUROVER);
  }
  if (isnan(INPUTCOFFEEESPRESSO)) {
    INPUTCOFFEEESPRESSO = 18.0;
    storagePutFloat(KEY_ESPRESSO, INPUTCOFFEEESPRESSO);
  }
  if (isnan(f_maxDriftCompensation)) {
    f_maxDriftCompensation = 0.05;
    storagePutFloat(KEY_DRIFT_MAX, f_maxDriftCompensation);
  }
#ifdef V7_2
  if (isnan(f_batteryCalibrationFactor) || f_batteryCalibrationFactor < 1.4 || f_batteryCalibrationFactor > 1.8) {
    f_batteryCalibrationFactor = 1.66;
    storagePutFloat(KEY_BAT_CAL, f_batteryCalibrationFactor);
  }
#else
  if (isnan(f_batteryCalibrationFactor) || f_batteryCalibrationFactor < 0.9 || f_batteryCalibrationFactor > 1.3) {
    f_batteryCalibrationFactor = 1.06;
    storagePutFloat(KEY_BAT_CAL, f_batteryCalibrationFactor);
  }
#endif
#ifdef BUZZER
  if (b_beep != 0 && b_beep != 1) {
    b_beep = 1;
    storagePutInt(KEY_BEEP, b_beep);
  }
#endif

  b_timeOnTop = storageGetBool(KEY_TIME_ON_TOP, false);
  b_btnFuncWhileConnected = storageGetBool(KEY_BTN_CONN, false);
  b_autoSleep = storageGetBool(KEY_AUTO_SLEEP, true);
  b_tapTareEnabled = storageGetBool(KEY_TAP_TARE, false);
  b_tapTimerEnabled = storageGetBool(KEY_TAP_TIMER, false);
  if (b_mode > 1) {
    b_mode = 0;
    storagePutInt(KEY_MODE, b_mode);
  }
  if (b_mode < 0) {
    b_mode = 0;
    storagePutInt(KEY_MODE, b_mode);
  }

  f_calibration_value = storageGetFloat(KEY_CAL1, CALIBRATION_VALUE_DEFAULT);
  if (!isValidCalibrationValue(f_calibration_value)) {
    float storedCalibrationValue = f_calibration_value;
    CalibrationRejectReason bootCalibrationReason = CAL_REJECT_FACTOR_SIGN;
    if (!isfinite(storedCalibrationValue) ||
        fabsf(storedCalibrationValue) < CALIBRATION_VALUE_MIN_ABS) {
      bootCalibrationReason = CAL_REJECT_FACTOR_NEAR_ZERO;
    } else if (fabsf(storedCalibrationValue) > CALIBRATION_VALUE_MAX_ABS) {
      bootCalibrationReason = CAL_REJECT_FACTOR_TOO_LARGE;
    }
    b_calibrationInvalid = true;
    snprintf(c_calibrationStatus, sizeof(c_calibrationStatus), "%s",
             calibrationRejectReasonText(bootCalibrationReason));
    Serial.print(F("Invalid stored calibration value: "));
    Serial.print(storedCalibrationValue, 6);
    Serial.print(F(" reason="));
    Serial.println(c_calibrationStatus);
    f_calibration_value = CALIBRATION_VALUE_DEFAULT;
    Serial.println(F("Using temporary default calibration; NVS not overwritten."));
  } else {
    b_calibrationInvalid = false;
    snprintf(c_calibrationStatus, sizeof(c_calibrationStatus), "%s",
             calibrationRejectReasonText(CAL_REJECT_NONE));
  }
  scale.setCalFactor(f_calibration_value);

#ifdef DEBUG
  if (digitalRead(BUTTON_DEBUG) == LOW && digitalRead(BUTTON_CIRCLE) == HIGH)
    b_debug = true;
  if (digitalRead(BUTTON_DEBUG) == LOW && digitalRead(BUTTON_CIRCLE) == LOW)
    b_debug_battery = true;
#endif  //DEBUG

#ifdef CAL
  if (digitalRead(BUTTON_CIRCLE) == HIGH && digitalRead(BUTTON_SQUARE) == LOW) {
    b_calibration = true;
    i_button_cal_status = 1;
    calibration(0);
  }
#endif
#if HDS_FEATURE_WIFI
  b_wifiOnBoot = storageGetBool(KEY_WIFI_BOOT, false);
#endif
#if HDS_ENABLE_GRINDER
  if (grinderSettings.enabled && !b_wifiOnBoot) {
    b_wifiOnBoot = true;
  }
  grinderRuntimeBegin();
#endif
  refreshMenuRows();
#if HDS_FEATURE_PULL_OTA
  const bool b_pendingOtaLittleFs = pullOtaHasPendingLittleFs();
#else
  const bool b_pendingOtaLittleFs = false;
#endif
  if (b_ble_enabled && !b_pendingOtaLittleFs) {
    ble_init();
  }
#if HDS_FEATURE_WIFI
  if (b_wifiOnBoot && GPIO_power_on_with != BATTERY_CHARGING && !b_pendingOtaLittleFs &&
      !filesystemRecoveryActive.load()) {
    wifi_init();
  }
#endif
  if (digitalRead(BUTTON_CIRCLE) == LOW && digitalRead(BUTTON_SQUARE) == LOW) {
    b_menu = true;
    invalidateMenuFrame();
    b_buttonChordSuppressUntilRelease = true;
#if HDS_ENABLE_GRINDER
    b_grinderMenuDirectEntry = false;
    grinderPauseForMenu();
#endif
    refreshOLED((char *)"HDS Setup", FONT_EXTRACTION);
    delay(1000);
  }

#if DEBUG
  Serial.print("digitalRead(BUTTON_CIRCLE):");
  Serial.print(digitalRead(BUTTON_CIRCLE));
  Serial.print("\tdigitalRead(BUTTON_CIRCLE):");
  Serial.println(digitalRead(BUTTON_CIRCLE));
#endif

  {
#ifdef WELCOME
    String welcome = storageGetString(KEY_WELCOME, String(WELCOME1));
    welcome.trim();
#else
    String welcome = "welcome";
#endif
    Serial.print("Welcome: ");
    if (welcome.length() == 127)
      Serial.print(WELCOME1);
    else
      Serial.print(welcome);
    Serial.print("\t");
    Serial.print(WELCOME2);
    Serial.print("\t");
    Serial.println(WELCOME3);
  }
  Serial.print("Info: ");
  Serial.print(LINE1);
  Serial.print("\t");
  Serial.print(LINE2);
  Serial.print("\t");
  Serial.print(LINE3);
  Serial.print("\t");
  Serial.println(GIT_REV);
  Serial.print("\tCal_Val: ");
  Serial.print(f_calibration_value);
  Serial.print("\tHB_DET: ");
  Serial.print(b_requireHeartBeat);
  Serial.print("\tTime_on_top: ");
  Serial.print(b_timeOnTop);
  Serial.print("\tButton_Func_While_Connected: ");
  Serial.print(b_btnFuncWhileConnected);
  Serial.println("");


  Serial.println("Button:\tSQARE\tCIRCLE");
  Serial.print("Pin:");
  Serial.print("\t");
  Serial.print(BUTTON_SQUARE);
  Serial.print("\t");
  Serial.println(BUTTON_CIRCLE);
#ifdef ADS1232ADC
#ifdef BUZZER
  Serial.println("Pin:\tI2C_SDA\tI2C_SCK ADC_DOUT ADC_SCLK\tADC_PWDN\tBUZZER");
#else
  Serial.println("Pin:\tI2C_SDA\tI2C_SCK ADC_DOUT ADC_SCLK\tADC_PWDN");
#endif
  Serial.print("Pin:");
  Serial.print("\t");
  Serial.print(I2C_SDA);
  Serial.print("\t");
  Serial.print(I2C_SCL);
  Serial.print("\t ");
  Serial.print(SCALE_DOUT);
  Serial.print("\t ");
  Serial.print(SCALE_SCLK);
  Serial.print("\t");
  Serial.print(SCALE_PDWN);
#ifdef BUZZER
  Serial.print("\t");
  Serial.print(BUZZER);
#endif
  Serial.println("");

#endif
#ifdef HX711ADC
  Serial.println("Button:\tI2C_SDA\tI2C_SCK\t711SDA\t711SCK\tBUZZER");
  Serial.print("Pin:");
  Serial.print("\t");
  Serial.print(I2C_SDA);
  Serial.print("\t");
  Serial.print(I2C_SCL);
  Serial.print("\t");
  Serial.print(HX711_SDA);
  Serial.print("\t");
  Serial.print(HX711_SCL);
  Serial.print("\t");
  Serial.println(BUZZER);
#endif

  Serial.println("Setup complete...");
  t_bootTare = millis();
  b_bootTare = true;
  updateBattery(BATTERY_PIN);
#if HDS_FEATURE_PULL_OTA
  if (b_pendingOtaLittleFs) {
    b_ota = true;
    blePauseForOta();
    if (!pullOtaResumePendingLittleFs()) {
      hdsOtaRollback("LittleFS update");
    }
  } else {
    if (filesystemRecoveryActive.load()) {
      if (!filesystemRecoveryStore(true) || !hdsOtaAcceptFilesystemRecovery()) {
        hdsOtaRollback("LittleFS recovery");
      }
    } else {
      hdsOtaRollbackMarkValid();
    }
  }
  if (filesystemRecoveryActive.load()) {
    b_ota = false;
    if (b_pendingOtaLittleFs && b_ble_enabled) ble_init();
    if (!b_wifiEnabled) {
      b_wifiOnBoot = true;
      wifi_init();
    } else {
      pullOtaResumeFilesystemServices();
    }
  }
#endif
#if HDS_ENABLE_ENERGY_MENU
  primeScaleButtonInputs();
  const bool lightSleepRequested =
    energyPolicy.featureEnabled(EnergyFeature::LightSleep);
  const bool lightSleepReady = initEnergyIdleWake();
  if (lightSleepRequested &&
      (!lightSleepReady || !setEnergyLightSleepEnabled(true))) {
    setEnergyLightSleepEnabled(false);
    const bool stored = clearEnergyLightSleepProfileSelection();
    Serial.println(stored
      ? "[energy] Stored Light Sleep rejected; disabled"
      : "[energy] Stored Light Sleep rejected; persistence failed");
  } else if (!lightSleepReady) {
    Serial.println("[energy] Light Sleep wake setup unavailable; continuing awake");
  }
#endif
}

void updateAdaptiveTracking(float current_weight) {
  unsigned long current_time = millis();

  if (!b_tracking_enabled) {
    return;
  }

  float weight_diff = current_weight - f_tracking_target;

  if (fabs(weight_diff) <= TRACKING_THRESHOLD) {
    i_stable_count++;

    if (i_stable_count >= 3) {
      float adjustment = weight_diff * 0.1;

      if (fabs(adjustment) > MAX_TRACKING_ADJUSTMENT) {
        adjustment = (adjustment > 0) ? MAX_TRACKING_ADJUSTMENT : -MAX_TRACKING_ADJUSTMENT;
      }

      f_tracking_target += adjustment;
   }

  } else {
    i_stable_count = 0;
    b_tracking_active = false;

    if (fabs(weight_diff) > TRACKING_THRESHOLD * 2) {
      if (verifyWeightStability(current_weight)) {
        f_tracking_target = current_weight;
        b_tracking_active = true;
        if (b_weight_in_serial) {
          Serial.print("New weight target set: ");
          Serial.println(f_tracking_target, 4);
        }
      }
    }
  }

  if (i_stable_count >= i_STABLE_COUNT_THRESHOLD) {
    if (current_time - t_last_tracking_update >= TRACKING_UPDATE_INTERVAL) {
      performTrackingAdjustment(current_weight);
    }
  }
}

void performTrackingAdjustment(float current_weight) {
  float old_offset = f_tracking_offset;

  float calculated_offset = current_weight - f_tracking_target;

  f_tracking_offset = f_tracking_offset * 0.8 + calculated_offset * 0.2;

  if (!b_tracking_active) {
    b_tracking_active = true;
  }

  if (b_weight_in_serial) {
    Serial.print("Tracking adjustment: Offset ");
    Serial.print(old_offset, 4);
    Serial.print("g -> ");
    Serial.print(f_tracking_offset, 4);
    Serial.print("g | Target: ");
    Serial.print(f_tracking_target, 4);
    Serial.print("g | Raw: ");
    Serial.print(current_weight, 4);
    Serial.println("g");
  }

  i_stable_count = i_STABLE_COUNT_THRESHOLD - 2;
  t_last_tracking_update = millis();
}

bool verifyWeightStability(float current_weight) {
  static float last_verified_weight = 0.0;
  static int verification_count = 0;

  if (fabs(current_weight - last_verified_weight) <= TRACKING_THRESHOLD) {
    verification_count++;
  } else {
    verification_count = 0;
  }

  last_verified_weight = current_weight;

  return (verification_count >= 3);
}

float applyTrackingCompensation(float raw_weight) {
  if (b_tracking_active && b_tracking_enabled) {
    return raw_weight - f_tracking_offset;
  }
  return raw_weight;
}

float applyStableOutput(float current_value) {
  if (!b_stable_output_enabled) {
    return current_value;
  }

  float change = fabs(current_value - f_previous_stable_value);

  if (change >= STABLE_OUTPUT_THRESHOLD) {
    f_previous_stable_value = current_value;
    t_last_stable_change = millis();

    if (b_weight_in_serial) {
      Serial.print("Output updated: ");
      Serial.print(current_value, 4);
      Serial.print("g (Change: ");
      Serial.print(change, 4);
      Serial.println("g)");
    }
  }

  return f_previous_stable_value;
}

void pureScale() {
  static bool b_newDataReady = 0;
#if HDS_ENABLE_ENERGY_MENU
  static float f_last_displayed = 0.0;
#endif
#if HDS_ENABLE_ENERGY_MENU
  unsigned long &t_lastScaleData = energyIdle.lastScaleData;
  unsigned long &t_lastScaleRecovery = energyIdle.lastScaleRecovery;
#else
  static unsigned long t_lastScaleData = 0;
  static unsigned long t_lastScaleRecovery = 0;
#endif
  static unsigned long t_zeroDisplayMismatch = 0;
  static int f_similar_diff_count = 0;
  static float f_last_diff = 0.0;

  if (t_lastScaleData == 0) {
    t_lastScaleData = millis();
  }

  if (scale.update()) {
    b_newDataReady = true;
    t_lastScaleData = millis();
    resetAdcRecoveryState();
  } else if (scale.getSignalTimeoutFlag() &&
             millis() - t_lastScaleData > 1500 &&
             millis() - t_lastScaleRecovery > 5000) {
    Serial.println("Scale ADC timeout. Power cycling ADC.");
#if HDS_ENABLE_GRINDER
    if (grinderSettings.enabled && grinderRuntime.state != GRINDER_STATE_ERROR &&
        grinderRuntime.state != GRINDER_STATE_DISABLED) {
      grinderEnterError("ADC timeout");
    }
#endif
    b_adc_recovery_active = true;
    if (i_adc_recovery_count < 255) {
      i_adc_recovery_count++;
    }
    scale.powerDown();
    delay(5);
    scale.powerUp();
    if (refreshScaleDatasetAfterDiscontinuity("ADC recovery") &&
        tareScaleWhenAdcReady("ADC recovery tare")) {
      resetScaleOutputAfterAdcDiscontinuity();
    }
    t_lastScaleRecovery = millis();
    t_lastScaleData = millis();
  }

  if (b_newDataReady) {
    float raw_weight = scale.getData();
    updatePressSampling();
    f_current_raw_value = raw_weight;
    if (b_tapTraceEnabled) {
      Serial.printf("[TAPRAW] %lu %.3f\n", t_lastScaleData, raw_weight);
    }

    float current_diff = raw_weight - f_displayedValue - f_driftCompensation;

    if (fabs(current_diff) > 0.01 && fabs(current_diff) < f_maxDriftCompensation) {
      if ((f_last_diff * current_diff) > 0) {
        f_similar_diff_count++;

        if (f_similar_diff_count >= 3) {
          f_driftCompensation += current_diff * 0.3;

          if (fabs(f_driftCompensation) > 2.0) {
            f_driftCompensation = (f_driftCompensation > 0) ? 2.0 : -2.0;
          }

          if (b_weight_in_serial) {
            Serial.print("TEMP-DRIFT-COMP: diff=");
            Serial.print(current_diff, 4);
            Serial.print("g, total_comp=");
            Serial.print(f_driftCompensation, 4);
            Serial.print("g, count=");
            Serial.println(f_similar_diff_count);
          }

          f_similar_diff_count = 2;
        }
      } else {
        f_similar_diff_count = 1;
      }

      f_last_diff = current_diff;
    } else {
      f_similar_diff_count = 0;
      f_last_diff = 0.0;
    }

    float temperature_compensated = raw_weight - f_driftCompensation;

    float tracking_compensated = applyTrackingCompensation(temperature_compensated);
#if HDS_ENABLE_GRINDER
    f_grinder_fast_weight = tracking_compensated;
    grinderFastWeightSequence++;
    if (grinderFastWeightSequence == 0) {
      grinderFastWeightSequence = 1;
    }
    grinderRuntimeFreshWeightTick(f_grinder_fast_weight, grinderFastWeightSequence);
#endif
    float stable_output = applyStableOutput(tracking_compensated);

    if (stable_output >= -0.14 && stable_output <= 0.14) {
      f_displayedValue = 0.0;
    } else {
      f_displayedValue = stable_output;
    }
#if HDS_ENABLE_ENERGY_MENU
    if (EnergyRuntimePolicy::meaningfulWeightChange(
          f_last_displayed, f_displayedValue, STABLE_OUTPUT_THRESHOLD)) {
      recordEnergyActivity();
      f_last_displayed = f_displayedValue;
    }
#endif
    updateAdaptiveTracking(tracking_compensated);

    if (!b_bootTare && !b_weight_quick_zero &&
        fabs(f_displayedValue) <= 0.14 &&
        fabs(raw_weight) > ZERO_DISPLAY_MISMATCH_THRESHOLD) {
      if (t_zeroDisplayMismatch == 0) {
        t_zeroDisplayMismatch = millis();
      } else if (millis() - t_zeroDisplayMismatch > ZERO_DISPLAY_MISMATCH_TIMEOUT) {
        Serial.println("Display held at zero while raw weight moved. Resetting output filters.");
        resetTracking();
        resetStableOutput();
        f_driftCompensation = 0.0;
        f_displayedValue = raw_weight;
        t_zeroDisplayMismatch = 0;
      }
    } else {
      t_zeroDisplayMismatch = 0;
    }

    formatFloatSafe(c_weight, sizeof(c_weight), f_displayedValue, i_decimal_precision);
    if (b_weight_in_serial == true) {
      unsigned long current_time = millis();
      if (current_time - t_last_status_display >= STATUS_DISPLAY_INTERVAL) {
        Serial.println("=== Temperature Drift Status ===");
        Serial.print("Raw: ");
        Serial.print(raw_weight, 4);
        Serial.print("g | TempComp: ");
        Serial.print(f_driftCompensation, 4);
        Serial.print("g | AfterTempComp: ");
        Serial.print(temperature_compensated, 4);
        Serial.println("g");

        Serial.print("Displayed: ");
        Serial.print(f_displayedValue, 4);
        Serial.print("g | Raw-Display Diff: ");
        Serial.print(raw_weight - f_displayedValue, 4);
        Serial.println("g");

        displayEnhancedStatus(temperature_compensated, tracking_compensated, stable_output);
        t_last_status_display = current_time;
      }
    }

    b_newDataReady = false;
  }

  if (!b_bootFreshTarePending && scale.getTareStatus()) {
    t_tareStatus = millis();
    b_weight_quick_zero = false;
    resetTracking();
    resetStableOutput();
    f_driftCompensation = 0.0;
    f_displayedValue = 0.0;
#if HDS_ENABLE_GRINDER
    f_grinder_fast_weight = 0.0f;
    grinderRuntimeNotifyTareComplete();
#endif
    if (b_weight_in_serial) {
      Serial.println("TARE: Temperature drift compensation reset");
    }
  }
  if (b_weight_quick_zero && millis() - t_quickZeroStart > QUICK_ZERO_HOLD_TIMEOUT) {
    Serial.println("Quick zero timeout. Releasing display zero hold.");
    b_weight_quick_zero = false;
    resetTracking();
    resetStableOutput();
    f_driftCompensation = 0.0;
#if HDS_ENABLE_GRINDER
    f_grinder_fast_weight = 0.0f;
#endif
  }


  if (b_weight_quick_zero || b_bootTare) {
    f_displayedValue = 0.0;
    f_driftCompensation = 0.0;
  }
}

float getTemperatureDriftCompensation() {
  return f_driftCompensation;
}

void adjustTemperatureDriftCompensation(float amount) {
  f_driftCompensation += amount;
  Serial.print("Manual temp-comp adjust: ");
  Serial.print(amount, 4);
  Serial.print("g, total: ");
  Serial.println(f_driftCompensation, 4);
}

void resetTracking() {
  f_tracking_offset = 0.0;
  f_tracking_target = 0.0;
  i_stable_count = 0;
  b_tracking_active = false;
  t_last_tracking_update = millis();
  if (b_weight_in_serial) {
    Serial.println("Tracking system reset");
  }
}

void resetStableOutput() {
  f_previous_stable_value = 0.0;
  t_last_stable_change = millis();
  if (b_weight_in_serial) {
    Serial.println("Stable output reset");
  }
}

bool wakeScaleFromSoftSleep(const char *context) {
  digitalWrite(PWR_CTRL, HIGH);
  if (fuelGaugeLegacyHardware()) {
    digitalWrite(ACC_PWR_CTRL, HIGH);
  }
  delay(5);
  scale.powerUp();
#if HDS_ENABLE_ENERGY_MENU
  b_softSleep = false;
  refreshEnergyIdleWakeForRuntimeState();
  clearPendingEnergyActivity();
  energyPolicy.recordActivity(millis());
  applyEnergyDisplayCommand(!energyRuntime.explicitDisplayOff);
#else
  u8g2.setPowerSave(0);
  b_softSleep = false;
  b_u8g2Sleep = false;
#endif
  if (refreshScaleDatasetAfterDiscontinuity(context)) {
    resetScaleOutputAfterAdcDiscontinuity();
    return true;
  }
  return false;
}

bool refreshScaleDatasetAfterDiscontinuity(const char *context) {
  if (scale.refreshDataSet()) {
    resetAdcRecoveryState();
    Serial.print(context);
    Serial.println(" dataset refreshed");
    return true;
  }

  b_adc_recovery_active = true;
  if (i_adc_recovery_count < 255) {
    i_adc_recovery_count++;
  }
  Serial.print(context);
  Serial.println(" dataset refresh failed");
  return false;
}

void resetScaleOutputAfterAdcDiscontinuity() {
  resetTracking();
  resetStableOutput();
  f_driftCompensation = 0.0;
  f_displayedValue = 0.0;
#if HDS_ENABLE_GRINDER
  f_grinder_fast_weight = 0.0f;
#endif
  formatFloatSafe(c_weight, sizeof(c_weight), f_displayedValue,
                  i_decimal_precision);
}

void holdScaleOutputAtZero() {
  f_driftCompensation = 0.0;
  f_displayedValue = 0.0;
  formatFloatSafe(c_weight, sizeof(c_weight), f_displayedValue,
                  i_decimal_precision);
}

bool isBootFreshTareInputSettled() {
  if (b_menu || b_calibration || GPIO_power_on_with == BATTERY_CHARGING) {
    return false;
  }
  if (digitalRead(BUTTON_CIRCLE) == LOW || digitalRead(BUTTON_SQUARE) == LOW) {
    return false;
  }
  if (t_menuExitTime > 0 &&
      millis() - t_menuExitTime <= BOOT_FRESH_TARE_INPUT_SETTLE) {
    return false;
  }
  return true;
}

void restoreBootFreshTareSamples() {
  uint8_t samplesInUse = i_bootFreshTareSamplesInUse > 0
                           ? i_bootFreshTareSamplesInUse
                           : 1;
  if (scale.getSamplesInUse() != samplesInUse) {
    scale.setSamplesInUse(samplesInUse);
  }
  i_bootFreshTareSamplesInUse = samplesInUse;
}

bool startBootFreshTare() {
  if (b_bootFreshTarePending) {
    return true;
  }

  int currentSamplesInUse = scale.getSamplesInUse();
  i_bootFreshTareSamplesInUse = currentSamplesInUse > 0
                                  ? (uint8_t)currentSamplesInUse
                                  : 1;
  if (scale.getSamplesInUse() != BOOT_FRESH_TARE_SAMPLES) {
    scale.setSamplesInUse(BOOT_FRESH_TARE_SAMPLES);
  }
  scale.tareFreshNoDelay();
  t_bootFreshTare = millis();
  b_bootFreshTarePending = true;
  holdScaleOutputAtZero();
  Serial.println("Boot fresh tare started");
  return true;
}

bool processBootFreshTare() {
  holdScaleOutputAtZero();

  if (!b_bootFreshTarePending) {
    if (!isBootFreshTareInputSettled()) {
      t_bootTare = millis();
      return false;
    }
    if (millis() - t_bootTare <= (unsigned long)i_bootTareDelay) {
      return false;
    }
    return startBootFreshTare();
  }

  if (scale.getTareStatus()) {
    b_bootFreshTarePending = false;
    restoreBootFreshTareSamples();
    if (!refreshScaleDatasetAfterDiscontinuity("boot tare restore")) {
      t_bootTare = millis();
      resetScaleOutputAfterAdcDiscontinuity();
      Serial.println("Boot fresh tare restore failed");
      return false;
    }
    resetScaleOutputAfterAdcDiscontinuity();
    b_bootTare = false;
    t_bootFreshTare = 0;
    Serial.println("Boot fresh tare complete");
    return true;
  }

  if (millis() - t_bootFreshTare > BOOT_FRESH_TARE_TIMEOUT) {
    b_bootFreshTarePending = false;
    restoreBootFreshTareSamples();
    resetScaleOutputAfterAdcDiscontinuity();
    t_bootTare = millis();
    t_bootFreshTare = 0;
    Serial.println("Boot fresh tare timeout");
  }

  return false;
}

bool tareScaleWhenAdcReady(const char *context, bool userRequested) {
  if (userRequested) recordEnergyActivity();
  const ADS1232DebugInfo info = scale.getDebugInfo();
  const unsigned long sampleAge = millis() - info.lastConversionTimestamp;
  if (info.signalTimeout || sampleAge > DEFAULT_SIGNAL_TIMEOUT_MS ||
      (info.samplesInUse > 0 && info.validSamples < info.samplesInUse)) {
    if (!refreshScaleDatasetAfterDiscontinuity(context)) {
      return false;
    }
  }
#if HDS_ENABLE_GRINDER
  grinderRuntimeNotifyTareRequested(userRequested);
#endif
  scale.tareNoDelay();
  return true;
}

void consumeScaleTareStatus() {
  scale.getTareStatus();
}

void clearPendingAutomaticTareState() {
  if (b_bootFreshTarePending) {
    restoreBootFreshTareSamples();
  }
  b_bootFreshTarePending = false;
  b_bootTare = false;
  b_weight_quick_zero = false;
  b_tareByButton = false;
  b_tareByBle = false;
  t_bootFreshTare = 0;
  t_quickZeroStart = 0;
  consumeRemoteTareRequests();
}

bool setScaleSamplesInUseWhenReady(uint8_t samplesInUse, const char *context) {
#if HDS_ENABLE_GRINDER
  if (grinderRuntimeLocksScaleSampling()) {
    Serial.print("Samples in use locked by grinder: ");
    Serial.println(context);
    return false;
  }
#endif
  scale.setSamplesInUse(samplesInUse);
  if (!refreshScaleDatasetAfterDiscontinuity(context)) {
    return false;
  }
  resetScaleOutputAfterAdcDiscontinuity();
  return true;
}

void setStableOutputEnabled(bool enabled) {
  b_stable_output_enabled = enabled;
  if (!enabled) {
    resetStableOutput();
  }
  Serial.print("Stable output ");
  Serial.println(enabled ? "enabled" : "disabled");
}

void setStableOutputThreshold(float threshold) {
  STABLE_OUTPUT_THRESHOLD = threshold;
  Serial.print("Stable threshold set to: ");
  Serial.println(threshold, 4);
}

void setTrackingThreshold(float threshold) {
  TRACKING_THRESHOLD = threshold;
  Serial.print("Tracking threshold set to: ");
  Serial.println(threshold, 4);
}

void setTrackingUpdateInterval(float interval) {
  TRACKING_UPDATE_INTERVAL = interval;
  Serial.print("Tracking update interval set to: ");
  Serial.println(interval, 4);
}


void setTrackingEnabled(bool enabled) {
  b_tracking_enabled = enabled;
  if (!enabled) {
    resetTracking();
  }
  Serial.print("Tracking system ");
  Serial.println(enabled ? "enabled" : "disabled");
}

void displayEnhancedStatus(float raw_weight, float compensated_weight, float stable_weight) {
  Serial.println("=== Enhanced Scale Status ===");
  Serial.print("Raw Input: ");
  Serial.print(raw_weight, 4);
  Serial.print("g | Compensated: ");
  Serial.print(compensated_weight, 4);
  Serial.print("g | Stable Output: ");
  Serial.print(stable_weight, 4);
  Serial.println("g");

  Serial.print("Stable Output: ");
  Serial.print(b_stable_output_enabled ? "ON" : "OFF");
  Serial.print(" | Threshold: ±");
  Serial.print(STABLE_OUTPUT_THRESHOLD, 4);
  Serial.println("g");

  Serial.print("Last Stable Change: ");
  Serial.print((millis() - t_last_stable_change) / 1000);
  Serial.println("s ago");

  Serial.print("Tracking System: ");
  Serial.print(b_tracking_enabled ? "ON" : "OFF");
  Serial.print(" | Active: ");
  Serial.println(b_tracking_active ? "YES" : "NO");

  Serial.print("Tracking Offset: ");
  Serial.print(f_tracking_offset, 4);
  Serial.print("g | Target: ");
  Serial.print(f_tracking_target, 4);
  Serial.println("g");

  Serial.print("Stable Count: ");
  Serial.print(i_stable_count);
  Serial.print("/");
  Serial.println(i_STABLE_COUNT_THRESHOLD);

  Serial.println("=============================");
}

float getTrackingOffset() {
  return f_tracking_offset;
}

float getStableOutputValue() {
  return f_previous_stable_value;
}

void setManualTrackingOffset(float offset) {
  f_tracking_offset = offset;
  b_tracking_active = true;
  Serial.print("Manual tracking offset set: ");
  Serial.println(offset, 4);
}

void setManualStableValue(float value) {
  f_previous_stable_value = value;
  t_last_stable_change = millis();
  Serial.print("Manual stable value set: ");
  Serial.println(value, 4);
}

#if HDS_ENABLE_ENERGY_MENU
void recordEnergyStateTransitions() {
  static bool initialized = false;
  static bool charging = false;
  static bool calibrating = false;
#if HDS_ENABLE_GRINDER
  static GrinderDosingState grinderState = GRINDER_STATE_DISABLED;
#endif
  const bool chargingNow = b_is_charging;
  if (!initialized) {
    charging = chargingNow;
    calibrating = b_calibration;
#if HDS_ENABLE_GRINDER
    grinderState = grinderRuntime.state;
#endif
    initialized = true;
    return;
  }
  if (charging != chargingNow) {
    charging = chargingNow;
    recordEnergyActivity();
  }
  if (calibrating != b_calibration) {
    calibrating = b_calibration;
    recordEnergyActivity();
  }
#if HDS_ENABLE_GRINDER
  if (grinderState != grinderRuntime.state) {
    grinderState = grinderRuntime.state;
    recordEnergyActivity();
  }
#endif
}

uint32_t mixEnergyDisplaySignature(uint32_t signature, uint32_t value) {
  return (signature ^ value) * 16777619u;
}

uint32_t mixEnergyDisplayText(uint32_t signature, const char *text) {
  while (*text != '\0') {
    signature = mixEnergyDisplaySignature(signature, static_cast<uint8_t>(*text));
    text++;
  }
  return signature;
}

uint32_t energyDisplaySignature(unsigned long now) {
  uint32_t signature = 2166136261u;
  const bool bleConnected = bleHasLiveClient();
#if HDS_FEATURE_WIFI
  const bool wifiBlink = b_wifiEnabled && WiFi.getMode() == WIFI_STA &&
                         WiFi.status() != WL_CONNECTED;
#else
  const bool wifiBlink = false;
#endif
  const int percent = batteryPercent();
  bool chargingNow = digitalRead(BATTERY_CHARGING) == LOW;
#ifdef USB_DET
  chargingNow = digitalRead(USB_DET) == LOW;
#endif
  const uint8_t batteryBucket = EnergyRuntimePolicy::batteryDisplayBucket(percent);
  const uint8_t displayedBattery = chargingNow ? 5 : batteryBucket;
  const bool tareVisible = now - t_tareStatus < 500;
  const bool shutdownWarningVisible = b_shutdownFailBle && now - t_shutdownFailBle < 3000;
  const uint32_t animationPhase =
    ((wifiBlink || (!chargingNow && batteryBucket == 0)) ? (now / 500) & 1 : 0) |
    ((b_ble_enabled && !bleConnected ? (now / 1000) & 1 : 0) << 1);
  signature = mixEnergyDisplaySignature(signature, static_cast<uint32_t>(lroundf(f_displayedValue * 10.0f)));
  signature = mixEnergyDisplaySignature(signature, (f_displayedValue > OVER_WEIGHT) |
                                                    ((f_displayedValue <= -1000.0f) << 1));
  signature = mixEnergyDisplaySignature(signature, stopWatch.elapsed());
  signature = mixEnergyDisplaySignature(signature, displayedBattery);
#if HDS_FEATURE_WIFI
  signature = mixEnergyDisplaySignature(signature, static_cast<uint32_t>(WiFi.status()));
  signature = mixEnergyDisplaySignature(signature, static_cast<uint32_t>(WiFi.getMode()));
#endif
#if HDS_ENABLE_GRINDER
  signature = mixEnergyDisplaySignature(signature, static_cast<uint32_t>(grinderRuntime.state));
  signature = mixEnergyDisplayText(signature, grinderRuntime.status);
#endif
  signature = mixEnergyDisplaySignature(signature, animationPhase);
  signature = mixEnergyDisplaySignature(signature, b_screenFlipped | (b_debug << 1) |
                                                    (b_about << 2) | (b_timeOnTop << 3));
  signature = mixEnergyDisplaySignature(signature, b_adc_recovery_active | (b_heartBeatIcon << 1) |
                                                    (tareVisible << 2) | (shutdownWarningVisible << 3));
  signature = mixEnergyDisplaySignature(signature, i_adc_recovery_count);
  uint32_t connectionState = bleConnected | (b_ble_enabled << 1);
#if HDS_FEATURE_WIFI
  connectionState |= b_wifiEnabled << 2;
#endif
  signature = mixEnergyDisplaySignature(signature, connectionState);
  signature = mixEnergyDisplaySignature(signature, digitalRead(BUTTON_CIRCLE) | (digitalRead(BUTTON_SQUARE) << 1));
  return signature;
}

bool energyDisplayIdleInhibited() {
  bool usbPower = b_is_charging || b_showChargingUI;
#ifdef USB_DET
  usbPower = usbPower || digitalRead(USB_DET) == LOW;
#endif
#if HDS_ENABLE_GRINDER
  const bool grinderDisplayRequired = grinderSettings.enabled &&
                                      grinderRuntime.state >= GRINDER_STATE_ARMED;
#else
  const bool grinderDisplayRequired = false;
#endif
  return usbPower || b_menu || b_calibration || b_ota ||
         b_adc_recovery_active || stopWatch.isRunning() || grinderDisplayRequired ||
         b_debug || b_about || b_shutdownFailBle;
}

void applyEnergyDisplayMode(DisplayIdleMode requested, bool force = false) {
  if (!force && requested == energyRuntime.displayMode) return;
  energyRuntime.displayMode = requested;
  if (requested == DisplayIdleMode::Off) {
    u8g2.setPowerSave(1);
    b_u8g2Sleep = true;
    return;
  }
  u8g2.setPowerSave(0);
  u8g2.setContrast(EnergyRuntimePolicy::displayContrast(
    energyRuntime.requestedDisplayContrast, requested));
  b_u8g2Sleep = false;
  if (requested == DisplayIdleMode::Active) energyRuntime.oledFrames.invalidate();
}

void applyEnergyDisplayCommand(bool enabled) {
  applyEnergyDisplayMode(enabled ? DisplayIdleMode::Active : DisplayIdleMode::Off, true);
}

void applyEnergyLowPowerCommand() {
  u8g2.setContrast(EnergyRuntimePolicy::displayContrast(
    energyRuntime.requestedDisplayContrast, energyRuntime.displayMode));
  energyRuntime.oledFrames.invalidate();
}

bool initEnergyPowerManagement() {
  return energyPowerManagement.begin();
}

bool applyEnergyLightSleepSetting(bool enabled) {
  return energyPowerManagement.applyLightSleepSetting(enabled);
}

bool setEnergyPerformanceCritical(bool required) {
  return energyPowerManagement.setPerformanceCritical(required);
}

void serviceEnergyPowerManagement() {
  static bool failureLogged = false;
  energyPowerManagement.setSerialTransportActive(energySerialTransportActive());
  energyPowerManagement.setUsbSleepTestEnabled(
    energyPolicy.featureEnabled(EnergyFeature::UsbSleepTest));
  const unsigned long now = millis();
  const bool performanceOk = setEnergyPerformanceCritical(
    b_ota || b_pullOtaRunning || energyResponsiveButtonBoostActive(now));
  const bool serviceOk = energyPowerManagement.service(now);
  if (performanceOk && serviceOk) {
    failureLogged = false;
    return;
  }
  if (energyPolicy.featureEnabled(EnergyFeature::LightSleep)) {
    setEnergyLightSleepEnabled(false);
    clearEnergyLightSleepProfileSelection();
  }
  if (!failureLogged) {
    Serial.println("[energy] PM transition failed; Light Sleep disabled");
    failureLogged = true;
  }
}

void applyEnergyDisplayIdle(unsigned long now) {
  if (b_softSleep) return;
  const DisplayIdleMode requested = EnergyRuntimePolicy::displayMode(
    energyPolicy.featureEnabled(EnergyFeature::OledIdle), energyDisplayIdleInhibited(),
    energyRuntime.explicitDisplayOff, energyPolicy.inactiveFor(now));
  applyEnergyDisplayMode(requested);
}

void applyEnergyFeatureTransition(EnergyFeature feature, bool wasEnabled, bool isEnabled) {
  if (wasEnabled == isEnabled) return;
  if (feature == EnergyFeature::OledRedraw) {
    energyRuntime.oledFrames.invalidate();
  } else if (feature == EnergyFeature::OledIdle) {
    clearPendingEnergyActivity();
    if (isEnabled) {
      energyPolicy.begin(millis());
      applyEnergyDisplayIdle(millis());
    } else {
      applyEnergyDisplayMode(energyRuntime.explicitDisplayOff ? DisplayIdleMode::Off
                                                             : DisplayIdleMode::Active);
    }
  } else if (feature == EnergyFeature::LightSleep) {
    setEnergyLightSleepEnabled(isEnabled);
  } else if (feature == EnergyFeature::UsbSleepTest) {
    refreshEnergyIdleWakeForRuntimeState();
    serviceEnergyPowerManagement();
  }
}

void serviceEnergyHousekeeping(unsigned long now) {
  if (b_softSleep || !energyPolicy.featureEnabled(EnergyFeature::OledIdle)) return;
  if (!energyRuntime.oledIdle.shouldRun(now, 100)) return;
  processEnergyActivities(now);
  recordEnergyStateTransitions();
  applyEnergyDisplayIdle(now);
}

#endif



void loop() {
  static bool otaBleClientDisconnected = false;
  static bool otaTransportsStopped = false;
#if HDS_ENABLE_ENERGY_MENU
  const uint64_t lightSleepWakeMask = serviceEnergyLightSleepWakeRestore();
  if (energyLightSleepButtonWake(lightSleepWakeMask)) {
    setEnergyPerformanceCritical(true);
    if (serviceScaleButtonInputs(true)) finishEnergyButtonWakeDebounce();
  }
#endif
  processWsPendingCmds();
  if (b_ota) {
    fuelGaugePauseCharging();
    if (!otaRuntimeIsPaused()) {
      if (!otaTransportsStopped) {
        otaBleClientDisconnected =
            blePauseForOta() || otaBleClientDisconnected;
        otaTransportsStopped = true;
#if HDS_FEATURE_WEBSOCKET
        websocket.closeAll();
#endif
      }
      if (b_softSleep) {
        wakeScaleFromSoftSleep("OTA wake");
      }
#if HDS_ENABLE_ENERGY_MENU
      setEnergyPerformanceCritical(true);
#endif
      if (!bleHasLiveClient()) {
        setOtaRuntimePaused(true);
      }
    } else {
      if (bleHasLiveClient()) {
        otaBleClientDisconnected =
            blePauseForOta() || otaBleClientDisconnected;
      }
#if HDS_ENABLE_ENERGY_MENU
      setEnergyPerformanceCritical(true);
#endif
    }
#if HDS_FEATURE_ELEGANT_OTA
    ElegantOTA.loop();
    processOtaDisplayUpdate();
    processElegantOtaTimeout();
#endif
    return;
  }
  if (otaTransportsStopped) {
    setOtaRuntimePaused(false);
    bleResumeAfterOta(
        otaBleClientDisconnected && !bleHasLiveClient());
    otaBleClientDisconnected = false;
    otaTransportsStopped = false;
  }

  processBleStatusResponse();
  processBleVoltageResponse();
  serviceFuelGauge();
#if HDS_ENABLE_ENERGY_MENU
  serviceEnergyPowerManagement();
  serviceEnergyHousekeeping(millis());
#endif

  if (b_powerOff){
    shut_down_now_nobeep();
    return;
  }

  const unsigned long now = millis();
  if (bleHasLiveClient()
      && b_requireHeartBeat
      && now - t_firstConnect > HEARTBEAT_TIMEOUT
      && now - t_heartBeat > HEARTBEAT_TIMEOUT
      && (t_lastDisconnectAttempt == 0
          || now - t_lastDisconnectAttempt >= HEARTBEAT_DISCONNECT_RETRY_INTERVAL)) {
    disconnectBLE();
  }
#ifdef HEARTBEATICON
  if (millis() - t_heartBeat < 500)
    b_heartBeatIcon = true;
  else
    b_heartBeatIcon = false;
#endif
  if (b_ota || bleHasLiveClient()
#if HDS_FEATURE_WEBSOCKET
      || (b_wifiEnabled && websocketHasClients())
#endif
#if HDS_ENABLE_GRINDER
      || grinderRuntimeKeepsAwake()
#endif
  ) {
    power_off(-1);
  } else {
    power_off(15);
  }
  if (!b_ota && Serial.available()) {
    uint8_t data[32];
    size_t len = 0;
    while (Serial.available() && len < sizeof(data)) {
      data[len++] = Serial.read();
    }
    usbCallbacks.onStream(data, len);
  }
  if (!b_ota) {
    usbCallbacks.poll();
  }

  serviceScaleButtonInputs(false);
#ifdef BUZZER
  buzzer.check();
#endif

  if (b_ota && b_softSleep) {
    wakeScaleFromSoftSleep("OTA wake");
  }
#if HDS_FEATURE_WIFI
  if (b_softSleep && b_wifiEnabled) {
    wifiSupervise();
  }
#endif
  if (!b_softSleep) {
#if defined(ACC_MPU6050) || defined(ACC_BMA400)
    if (b_gyroEnabled) {
#ifdef GYROFACEUP
      if (gyro_z() > 5)
        power_off_gyro(-1);
#endif
#ifdef GYROFACEDOWN
      if (gyro_z() < -5)
        power_off_gyro(-1);
#endif
      power_off_gyro(10);
    }
#endif
#if defined(DEBUG) && defined(CHECKBATTERY)
    debugData();
#endif  //DEBUG
    if (millis() - t_batteryRefresh > i_batteryRefreshTareInterval){
      updateBattery(BATTERY_PIN);
    }
    if (powerCadence.chargeCheck.shouldRun(millis(), 200)) {
      checkBattery();
    }
    if (b_menu) {
#if HDS_FEATURE_WIFI
      if (b_wifiEnabled) {
        wifiSupervise();
      }
#endif
#if HDS_ENABLE_GRINDER
      grinderRuntimeTick(f_displayedValue);
#endif
      showMenu();
    } else if (GPIO_power_on_with == BATTERY_CHARGING && !b_calibration) {
#if HDS_ENABLE_GRINDER
      grinderRuntimeTick(f_displayedValue);
#endif
      if ((digitalRead(BATTERY_CHARGING) == LOW || usbPowerKeepsAwake()) && !b_calibration) {
        b_showChargingUI = b_chargingOLED;
        if (b_chargingOLED) {
          float perc = batteryPercent();
          chargingOLED((int)perc, f_batteryVoltage);
        }
      } else {
        b_showChargingUI = false;
        bool b_usbDisconnected = false;
#ifdef USB_DET
        b_usbDisconnected = digitalRead(USB_DET) == HIGH;
#endif
        if (b_usbDisconnected) {
          Serial.println("USB unplugged. Entering scale mode.");
          wakeFromChargingUi(BUTTON_SQUARE);
          scale.powerUp();
          if (refreshScaleDatasetAfterDiscontinuity("charging wake") &&
              tareScaleWhenAdcReady("charging wake tare")) {
            resetScaleOutputAfterAdcDiscontinuity();
          }
        } else {
          if (f_batteryVoltage > 4.1) {
            Serial.println("Charging complete.");
          } else {
            Serial.println("Charging stopped before full.");
          }
          b_powerOff = true;
          Serial.println("Going to sleep now by BatteryFull");
        }
      }
    } else {
      if (b_calibration == true) {
        calibration(i_calibration);
      } else if (b_usbLinked == true) {
      } else {
#if HDS_FEATURE_WIFI
        if (b_wifiEnabled) {
          wifiSupervise();
#if HDS_FEATURE_ELEGANT_OTA
          ElegantOTA.loop();
          processOtaDisplayUpdate();
#endif
        }
#endif

        g_timerRunning = stopWatch.isRunning();
        g_timerElapsed = (unsigned long)stopWatch.elapsed();

        if (!b_adc_recovery_active) {
#if HDS_ENABLE_ENERGY_MENU
          unsigned long &t_weightTick = energyIdle.lastWeightTick;
#else
          static unsigned long t_weightTick = 0;
#endif
          static unsigned long weightTickCount = 0;
          unsigned long nowMs = millis();
          if (nowMs - t_weightTick >= WEIGHT_BASE_INTERVAL_MS) {
            t_weightTick += WEIGHT_BASE_INTERVAL_MS;
            if (nowMs - t_weightTick >= WEIGHT_BASE_INTERVAL_MS) t_weightTick = nowMs;
            weightTickCount++;
            const bool textDue =
              weightTickCount % max(1UL, weightTextNotifyInterval / WEIGHT_BASE_INTERVAL_MS) == 0;
            const bool bleDue = b_ble_enabled &&
              weightTickCount % max(1UL, weightBleNotifyInterval / WEIGHT_BASE_INTERVAL_MS) == 0;
            const bool usbDue = b_usbweight_enabled &&
              weightTickCount % max(1UL, weightUsbNotifyInterval / WEIGHT_BASE_INTERVAL_MS) == 0;
#if HDS_FEATURE_WEBSOCKET
            const bool websocketDue = b_wifiEnabled &&
              weightTickCount % max(1UL, weightWebsocketNotifyInterval / WEIGHT_BASE_INTERVAL_MS) == 0;
#endif
            if (textDue) sendUsbTextWeight();
            if (bleDue) sendBleWeight();
            if (usbDue) sendUsbWeight();
#if HDS_FEATURE_WEBSOCKET
            if (websocketDue) sendWebsocketWeightAll(f_displayedValue, nowMs);
#endif
          }
        }

        if (b_ble_enabled && bleHasLiveClient() && bleDebugMode != DEBUG_OFF) {
          if (bleDebugMode == DEBUG_SINGLE ||
              millis() - t_lastBleDebugNotify >= BLE_DEBUG_MIN_INTERVAL) {
            t_lastBleDebugNotify = millis();
            sendAdsDebugInfoBLE();
          }
        }
        if (b_bootTare) {
          processBootFreshTare();
        } else if (b_tareByButton) {
          if (millis() - t_tareByButton > i_tareDelay) {
            bool tareDone = tareScaleWhenAdcReady("button tare", true);
            b_tareByButton = false;
            Serial.println(tareDone ? "Tare by button" : "Tare by button failed");
          }
        } else if (hasRemoteTareRequest()) {
          uint8_t remoteTareRequests = consumeRemoteTareRequests();
          bool tareDone = tareScaleWhenAdcReady("remote tare", true);
          if (tareDone) {
            Serial.print("Tare by remote command");
            if (remoteTareRequests > 1) {
              Serial.print(" (");
              Serial.print(remoteTareRequests);
              Serial.print(" requests)");
            }
            Serial.println();
          } else {
            Serial.println("Tare by remote command failed");
          }
        }
        pureScale();
        tapDetectTick();
        updateOled();
#if HDS_ENABLE_GRINDER
        grinderRuntimeTick(f_displayedValue);
#endif
      }
    }
  }
#if HDS_ENABLE_ENERGY_MENU
  waitForEnergyMainLoopWork();
#endif
}


void chargingOLED(int perc, float voltage) {
  if (millis() - t_oled_refresh >= 1000) {
    t_oled_refresh = millis();
    invalidateEnergyOledFrame();
    u8g2.firstPage();
    do {
      u8g2.drawXBM(121, 51, 7, 12, image_battery_charging);
    } while (u8g2.nextPage());
  }








}


void updateOled() {
  const unsigned long frameNow = millis();
  if (frameNow - t_oled_refresh >= i_oled_print_interval) {
    t_oled_refresh = frameNow;

#if HDS_ENABLE_ENERGY_MENU
    const bool oledRedraw = energyPolicy.featureEnabled(EnergyFeature::OledRedraw);
    if (energyRuntime.displayMode == DisplayIdleMode::Off) {
      return;
    }
    if (oledRedraw) {
      if (!energyRuntime.oledFrames.shouldRender(
            true, energyDisplaySignature(frameNow), frameNow, 1000)) {
        return;
      }
    }
#endif

    u8g2.firstPage();
    do {
      if (b_screenFlipped)
        u8g2.setDisplayRotation(U8G2_R0);
      else
        u8g2.setDisplayRotation(U8G2_R2);
      u8g2.setFontMode(1);
      u8g2.setDrawColor(1);
      if (!b_debug) {
        if (b_adc_recovery_active) {
          drawAdcRecovery();
        } else {
          drawWeight(f_displayedValue);
          drawTime();
        }
      }
      u8g2.setDrawColor(2);

      drawBattery(frameNow);
      drawButton();
      drawBle(frameNow);
      drawHeartBeat();
#if HDS_ENABLE_GRINDER
      drawGrinder();
#endif
      drawTare();
      drawShutdownFail();
      drawAbout();
      drawDebug();

    } while (u8g2.nextPage());
  }
}

void drawShutdownFail() {
  if (b_shutdownFailBle && millis() - t_shutdownFailBle < 3000 && millis() - t_menuExitTime > 1000) {
    u8g2.setFont(FONT_S);
    u8g2.setDrawColor(0);
    u8g2.drawBox(0, 0, 128, 64);
    u8g2.setDrawColor(1);
    u8g2.drawStr(AC((char *)"Power off with app"), AM() - 25, (char *)"Power off with app");
    u8g2.drawStr(AC((char *)"(Or tap [] now"), AM(), (char *)"(Or tap [] now");
    u8g2.drawStr(AC((char *)"to force off)"), AM() + 25, (char *)"to force off)");
  }
  if (b_shutdownFailBle && millis() - t_shutdownFailBle >= 3000) {
    b_shutdownFailBle = false;
  }
}

int i_weightInt;
int i_weightFirstDecimal;
void separateFloat(float number) {
  int roundedTenths = (int)roundf(number * 10.0f);
  b_negativeWeight = roundedTenths < 0;
  i_weightInt = roundedTenths / 10;
  i_weightFirstDecimal = abs(roundedTenths % 10);
}

void drawWeight(float input) {
  if (input > OVER_WEIGHT){
    u8g2.setFont(FONT_GRAM);
    u8g2.drawStr(AC((char *)"Over"), AT(), (char *)"Over");
    u8g2.drawStr(AC((char *)"Weight"), AT() + 20, (char *)"Weight");
  }
  else {
    separateFloat(input);
    char integerStr[10] = "-0";
    char decimalStr[10] = "0";
    if (!b_negativeWeight || i_weightInt <= -1) {
      snprintf(integerStr, sizeof(integerStr), "%d", i_weightInt);
    }
    snprintf(decimalStr, sizeof(decimalStr), "%d", i_weightFirstDecimal);

    u8g2.setFont(FONT_TIMER);
    int y_timer = u8g2.getMaxCharHeight();
    u8g2.setFont(FONT_GRAM);
    int gramWidth = u8g2.getUTF8Width("g");
    u8g2.setFont(FONT_WEIGHT);
    int integerWidth = u8g2.getUTF8Width(trim(integerStr));
    int decimalWidth = u8g2.getUTF8Width(trim(decimalStr));
    int decimalPointWidth = u8g2.getUTF8Width(".");
    if (input <= -1000.0)
      gramWidth = 0;
    int x_integer = (128 - (integerWidth + decimalWidth + gramWidth + decimalPointWidth - 6 - 1)) / 2;
    int x_decimalPoint = x_integer + integerWidth - 4;
    int x_decimal = x_decimalPoint + decimalPointWidth - 4;
    int x_gram = x_decimal + decimalWidth - 1;
    int y = AT() - 15;
    if (b_timeOnTop)
      y = AT() + 9;
    if (strcmp(sec2sec(stopWatch.elapsed()), "0s") == 0) {
      y = AT();
    }
    u8g2.drawStr(x_decimalPoint, y, ".");
    u8g2.drawStr(x_integer, y, trim(integerStr));
    u8g2.drawStr(x_decimal, y, trim(decimalStr));
    if (input > -1000.0) {
      u8g2.setFont(FONT_GRAM);
      u8g2.drawStr(x_gram, y - 5, "g");
    }
  }
}

void drawTime() {
  if (strcmp(sec2sec(stopWatch.elapsed()), "0s") != 0) {
    u8g2.setFont(FONT_TIMER);
    int y = LCDHeight - 8;
    if (b_timeOnTop)
      y = u8g2.getMaxCharHeight() - 8;
    u8g2.drawStr(AC(sec2sec(stopWatch.elapsed())), y, sec2sec(stopWatch.elapsed()));
  }
}

void drawAdcRecovery() {
  u8g2.setFont(FONT_S);
  const char* line1 = getAdcRecoveryDisplayText();
  const char* line2 = "CHECK SCALE";
  u8g2.drawStr(AC(line1), AM() - 12, line1);
  u8g2.drawStr(AC(line2), AM() + 12, line2);
}

const char* getAdcRecoveryDisplayText() {
  return i_adc_recovery_count >= ADC_ERROR_RECOVERY_COUNT ? "ADC ERROR" : "ADC RECOVER";
}

void drawButton() {
  if (digitalRead(BUTTON_CIRCLE) == LOW) {
    if (b_screenFlipped)
      u8g2.drawXBM(113, 0, 15, 16, image_circle);
    else
      u8g2.drawXBM(0, 0, 15, 16, image_circle);
  }
  if (digitalRead(BUTTON_SQUARE) == LOW)
    if (b_screenFlipped)
      u8g2.drawXBM(0, 0, 14, 16, image_square);
    else
      u8g2.drawXBM(114, 0, 14, 16, image_square);
}

void drawBle(unsigned long now) {
  if (b_ble_enabled) {
    if (bleHasLiveClient()) {
      u8g2.drawXBM(3, 51, 5, 13, image_ble_enabled);
    } else if ((now / 1000) & 1) {
      u8g2.drawXBM(3, 51, 5, 13, image_ble_enabled);
    }
  }
}

void drawHeartBeat(){
  if (b_heartBeatIcon)
    u8g2.drawXBM(30, 51, 13, 13, image_heart_13x13);
}

#if HDS_ENABLE_GRINDER
void drawGrinder() {
  if (!grinderSettings.enabled) {
    return;
  }
  char text[28];
  grinderShortStatus(text, sizeof(text));
  u8g2.setFont(u8g2_font_5x8_tr);
  u8g2.drawStr(46, 64, text);
}
#endif

void drawBattery(unsigned long now) {
#if defined(V7_4) || defined(V7_5) || defined(V8_0) || defined(V8_1)
  if (digitalRead(USB_DET) == LOW) {
#else
  if (digitalRead(BATTERY_CHARGING) == LOW) {
#endif
    b_is_charging = true;
    u8g2.drawXBM(121, 51, 7, 12, image_battery_charging);
  } else {
    b_is_charging = false;
    int i_batteryPercent = batteryPercent();
    switch (EnergyRuntimePolicy::batteryDisplayBucket(i_batteryPercent)) {
      case 0:
        if ((now / 500) & 1) u8g2.drawXBM(121, 52, 7, 12, image_battery_0);
        break;
      case 1:
        u8g2.drawXBM(121, 52, 7, 12, image_battery_1);
        break;
      case 2:
        u8g2.drawXBM(121, 52, 7, 12, image_battery_2);
        break;
      case 3:
        u8g2.drawXBM(121, 52, 7, 12, image_battery_3);
        break;
      default:
        u8g2.drawXBM(121, 52, 7, 12, image_battery_4);
        break;
    }
  }

#if HDS_FEATURE_WIFI
  if (b_wifiEnabled) {
    bool connecting = WiFi.getMode() == WIFI_STA && WiFi.status() != WL_CONNECTED;
    if (!connecting || ((now / 500) & 1)) {
      u8g2.setFont(u8g2_font_open_iconic_www_1x_t);
      int glyph = WiFi.getMode() == WIFI_STA ? 0x004F : 0x0051;
      u8g2.drawGlyph(10, 64, glyph);
    }
  }
#endif
}

void drawAbout() {
  if (b_about) {
    u8g2.setFont(FONT_M);
    if (AC(FIRMWARE_VER) < 0 || AC(PCB_VER) < 0)
      u8g2.setFont(FONT_S);
    if (u8g2.getUTF8Width(FIRMWARE_VER) > LCDWidth ||
        u8g2.getUTF8Width(PCB_VER) > LCDWidth)
      u8g2.setFont(u8g2_font_5x7_tr);
    u8g2.setDrawColor(0);
    u8g2.drawBox(0, 0, LCDWidth, LCDHeight);
    u8g2.setDrawColor(1);
    u8g2.drawStr(AC(FIRMWARE_VER), AM() - 12, FIRMWARE_VER);
    u8g2.drawStr(AC(PCB_VER), AM() + 12, PCB_VER);
    if (digitalRead(BUTTON_SQUARE) == LOW)
      b_about = false;
  }
}

void drawDebug() {
  if (b_debug) {
    char bleText[20];
    if (b_ble_enabled) {
      if (bleHasLiveClient()) {
        snprintf(bleText, sizeof(bleText), "BLE connected");
      } else {
        snprintf(bleText, sizeof(bleText), "BLE enabled");
      }
    } else {
      snprintf(bleText, sizeof(bleText), "BLE disabled");
    }

    char chargingText[20];
    if (digitalRead(BATTERY_CHARGING) == LOW)
      snprintf(chargingText, sizeof(chargingText), "Charging");
    else
      snprintf(chargingText, sizeof(chargingText), "Not charging");

    char batteryText[10];
    int perc = batteryPercent();
    snprintf(batteryText, sizeof(batteryText), "%d%%", (perc > 100) ? 100 : perc);

    char voltageText[10];
    if (perc > 100) {
      strcat(batteryText, "+");
    }
    snprintf(voltageText, sizeof(voltageText), "%.1fV", f_batteryVoltage);

    char gpioText[10];
    snprintf(gpioText, sizeof(gpioText), "GPIO:%d", i_wakeupPin);

#if defined(ACC_MPU6050) || defined(ACC_BMA400)
    char gyroText[10];
    snprintf(gyroText, sizeof(gyroText), "Gyro:%.1f", gyro_z());
#endif

    char weightText[10];
    snprintf(weightText, sizeof(weightText), "%.1fg", f_displayedValue);

    u8g2.setFont(u8g2_font_6x13_tr);
    int lineHeight = 12;
    u8g2.drawStr(-54, lineHeight, LINE1);
    u8g2.drawStr(0, lineHeight * 2, (char *)trim(gpioText));
#if defined(ACC_MPU6050) || defined(ACC_BMA400)
    u8g2.drawStr(0, lineHeight * 3, (char *)trim(gyroText));
#endif
    u8g2.drawStr(0, lineHeight * 4, (char *)trim(chargingText));
    u8g2.drawStr(14, lineHeight * 5, (char *)trim(bleText));

    u8g2.drawStr(55, lineHeight, (char *)trim(batteryText));
    u8g2.drawStr(55, lineHeight * 2, (char *)trim(voltageText));

    u8g2.drawStr(AR((char *)trim(weightText)), lineHeight, (char *)trim(weightText));
    u8g2.drawStr(AR(sec2sec(stopWatch.elapsed())), lineHeight * 2, sec2sec(stopWatch.elapsed()));

  }
}

void drawTare() {
  if (millis() - t_tareStatus < 500) {
    u8g2.drawBox(30, 62, 128 - 30 * 2, 2);
  }
}

void drawDriftCompensationInfo() {
  char factorText[20];
  u8g2.setFont(u8g2_font_6x13_tr);

  snprintf(factorText, sizeof(factorText), "TUI:%lums", TRACKING_UPDATE_INTERVAL);
  u8g2.drawStr(0, 13, (char *)trim(factorText));
  snprintf(factorText, sizeof(factorText), "TT:%.2f", TRACKING_THRESHOLD);
  u8g2.drawStr(AR((char *)trim(factorText)), 13, (char *)trim(factorText));

  snprintf(factorText, sizeof(factorText), "%.3f", f_maxDriftCompensation);
  u8g2.drawStr(0, 26, (char *)"MDC");
  u8g2.drawStr(0, 39, (char *)trim(factorText));

  snprintf(factorText, sizeof(factorText), "TDC:%.2f", f_driftCompensation * -1);
  u8g2.drawStr(AR((char *)trim(factorText)), 26, (char *)trim(factorText));

  snprintf(factorText, sizeof(factorText), "RAW:%.2f", f_current_raw_value);
  u8g2.drawStr(12, 64, (char *)trim(factorText));
  snprintf(factorText, sizeof(factorText), "%.2f", f_displayedValue);
  u8g2.drawStr(80, 64, (char *)trim(factorText));
}
