decentespresso/openscale/include/usbcomm.h

#ifndef USBCOMM_H
#define USBCOMM_H

#include "ADS1232_ADC.h"
#include "decent_protocol.h"
#include <math.h>
#include <string.h>

extern ADS1232_ADC scale;

void sendUsbVoltage();
void sendUsbLedResponse();
void sendUsbAdsDebug();
void sendUsbAdsResetResponse(uint8_t mode, uint8_t status);
void handleAdsReset(uint8_t mode);
#if defined(ACC_MPU6050) || defined(ACC_BMA400)
void sendUsbGyro();
#endif

static inline uint16_t encodeScaledUInt16(float value, float scale) {
  float scaled = value * scale;
  if (!isfinite(scaled) || scaled <= 0.0f) {
    return 0;
  }
  if (scaled > 65535.0f) {
    return 65535;
  }
  return (uint16_t)scaled;
}

struct UsbDecentCommandSink {
  const char *transportName() {
    return "USB";
  }

  void requestTare() {
    requestRemoteTare();
  }

  void displayOff() {
#if HDS_ENABLE_ENERGY_MENU
    requestEnergyDisplay(false);
    applyEnergyDisplayCommand(false);
#else
    u8g2.setPowerSave(1);
    b_u8g2Sleep = true;
#endif
    sendUsbLedResponse();
  }

  void displayOn() {
#if HDS_ENABLE_ENERGY_MENU
    requestEnergyDisplay(true);
    applyEnergyDisplayCommand(true);
#else
    u8g2.setPowerSave(0);
    b_u8g2Sleep = false;
#endif
    sendUsbLedResponse();
  }

  void powerOff() {
    b_powerOff = true;
  }

  void lowPowerOn() {
#if HDS_ENABLE_ENERGY_MENU
    requestEnergyLowPower(true);
    applyEnergyLowPowerCommand();
#else
    u8g2.setContrast(0);
#endif
  }

  void lowPowerOff() {
#if HDS_ENABLE_ENERGY_MENU
    requestEnergyLowPower(false);
    applyEnergyLowPowerCommand();
#else
    u8g2.setContrast(255);
#endif
  }

  void softSleepOn() {
    remoteReplacePending(WSP_SLEEP_ON, WSP_SLEEP_OFF);
  }

  void softSleepOff() {
    remoteReplacePending(WSP_SLEEP_OFF, WSP_SLEEP_ON | WSP_DISPLAY_OFF);
  }

  void timerStart() {
    stopWatch.reset();
    stopWatch.start();
#if HDS_ENABLE_ENERGY_MENU
    recordEnergyActivity();
#endif
  }

  void timerStop() {
    stopWatch.stop();
#if HDS_ENABLE_ENERGY_MENU
    recordEnergyActivity();
#endif
  }

  void timerZero() {
    stopWatch.reset();
#if HDS_ENABLE_ENERGY_MENU
    recordEnergyActivity();
#endif
  }

  void wifiUpdate(const PullOtaTargetVersion &target) {
#if HDS_FEATURE_PULL_OTA
    if (b_pullOtaRunning || b_ota) {
      Serial.println("WiFi OTA already running; start ignored.");
      return;
    }
    if (!remoteQueueWifiUpdate(target)) {
      Serial.println("WiFi OTA start already queued; start ignored.");
      return;
    }
    Serial.println("Start WiFi OTA queued.");
#else
    (void)target;
    Serial.println("WiFi OTA unavailable.");
#endif
  }

#ifdef BUZZER
  void buzzerOff() {
    b_beep = false;
  }

  void buzzerOn() {
    b_beep = true;
  }

  void buzzerBeep() {
    buzzer.beep(1, 50);
  }
#endif

  void setSamplesInUse(uint8_t samplesInUse) {
    if (setScaleSamplesInUseWhenReady(samplesInUse, "USB samples")) {
      Serial.print("Samples in use set to: ");
      Serial.println(scale.getSamplesInUse());
    } else {
      Serial.println("Samples in use refresh failed");
    }
  }

  void reset() {
    ::reset();
  }

#if defined(ACC_MPU6050) || defined(ACC_BMA400)
  void sendGyro() {
    sendUsbGyro();
  }
#endif

  void sendVoltage() {
    sendUsbVoltage();
  }

  void adsDebug(uint8_t mode) {
    if (mode == 0x00) {
      Serial.println("ADS debug off via hex");
      scale.setDebugEnabled(false);
    } else if (mode == 0x01) {
      Serial.println("ADS debug on via hex");
      scale.setDebugEnabled(true);
    } else if (mode == 0x02) {
      Serial.println("ADS debug info via hex");
      sendUsbAdsDebug();
    }
  }

  bool supportsAdsReset() {
    return true;
  }

  void adsReset(uint8_t mode) {
    handleAdsReset(mode);
  }
};

class MyUsbCallbacks {
public:
  void (*setStableOutputThreshold)(float);
  void (*setTrackingThreshold)(float);
  void (*setTrackingUpdateInterval)(float);
  void (*buttonSquare_Pressed)();
  void (*buttonCircle_Pressed)();
  void (*toggleTimer)();

  static const size_t USB_RX_BUFFER_SIZE = 160;
  static const unsigned long USB_RX_FRAME_TIMEOUT_MS = 30;

  uint8_t usbRxBuffer[USB_RX_BUFFER_SIZE];
  size_t usbRxLen = 0;
  unsigned long usbLastByteAt = 0;

  void consumeUsbRxBytes(size_t count) {
    if (count >= usbRxLen) {
      usbRxLen = 0;
      return;
    }
    memmove(usbRxBuffer, usbRxBuffer + count, usbRxLen - count);
    usbRxLen -= count;
  }

  void appendToUsbRxBuffer(uint8_t *data, size_t len) {
    if (data == nullptr || len == 0) {
      return;
    }

    usbLastByteAt = millis();
    if (len > USB_RX_BUFFER_SIZE) {
      data += len - USB_RX_BUFFER_SIZE;
      len = USB_RX_BUFFER_SIZE;
      usbRxLen = 0;
      Serial.println("USB RX buffer overflow; keeping newest bytes");
    } else if (usbRxLen + len > USB_RX_BUFFER_SIZE) {
      usbRxLen = 0;
      Serial.println("USB RX buffer overflow; dropping buffered bytes");
    }

    memcpy(usbRxBuffer + usbRxLen, data, len);
    usbRxLen += len;
  }

  bool usbRxTimedOut() {
    return usbRxLen > 0 && millis() - usbLastByteAt >= USB_RX_FRAME_TIMEOUT_MS;
  }

  size_t bufferedTextLength(bool allowTimeout) {
    for (size_t i = 0; i < usbRxLen; i++) {
      if (usbRxBuffer[i] == 0x03) {
        return i;
      }
      if (usbRxBuffer[i] == '\n' || usbRxBuffer[i] == '\r') {
        return i + 1;
      }
    }
    return allowTimeout ? usbRxLen : 0;
  }

  void processUsbRxBuffer(bool allowTimeout) {
    while (usbRxLen > 0) {
      if (b_ota) return;
      bool timedOut = allowTimeout && usbRxTimedOut();

      if (usbRxBuffer[0] == 0x03) {
        size_t frameLen = decentCommandFrameLength(usbRxBuffer, usbRxLen, timedOut);
        if (frameLen == 0) {
          if (timedOut) {
            Serial.println("Dropping incomplete USB binary frame");
            consumeUsbRxBytes(1);
            continue;
          }
          return;
        }

        onWrite(usbRxBuffer, frameLen);
        consumeUsbRxBytes(frameLen);
        continue;
      }

      size_t textLen = bufferedTextLength(timedOut);
      if (textLen == 0) {
        return;
      }

      onWrite(usbRxBuffer, textLen);
      consumeUsbRxBytes(textLen);
    }
  }

  void onStream(uint8_t *data, size_t len) {
    if (data == nullptr || len == 0) {
      return;
    }

    appendToUsbRxBuffer(data, len);
    processUsbRxBuffer(false);
  }

  void poll() {
    processUsbRxBuffer(true);
  }

  void onWrite(uint8_t *data, size_t len) {
    Serial.print("Timer ");
    Serial.print(millis());
    Serial.print(" onWrite counter:");
    Serial.print(i_onWrite_counter++);
    Serial.print(" ");


    if (data == nullptr || len <= 0) {
      return;
    }


    Serial.print("Received HEX: ");
    for (size_t i = 0; i < len; i++) {
      if (data[i] < 0x10) {
        Serial.print("0");
      }
      Serial.print(data[i], HEX);
    }
    Serial.println(" ");

    if (data[0] != 0x03) {
      String input((const char *)data, len);
      handleStringCommand(input);
      return;
    }
    UsbDecentCommandSink sink;
    handleDecentBinaryCommand(sink, data, len);
  }




  void handleStringCommand(String inputString) {
    inputString.trim();
    Serial.printf("handling %s\n", inputString.c_str());
    if (inputString.startsWith("welcome ")) {
      storagePutWelcome(inputString.substring(8));
    }
#if defined(ACC_MPU6050) || defined(ACC_BMA400)
    if (inputString.startsWith("gyro")) {
      Serial.print("\tGyro:");
      Serial.println(gyro_z());
    }
#endif

    if (inputString.startsWith("cp ")) {
      INPUTCOFFEEPOUROVER = inputString.substring(3).toFloat();
      storagePutFloat(KEY_POUROVER, INPUTCOFFEEPOUROVER);
    }

    if (inputString.startsWith("v")) {
      Serial.print("Battery Voltage:");
      Serial.print(f_batteryVoltage);
      if (b_ads1115InitFail && fuelGaugeLegacyHardware()) {
        int adcValue = analogRead(BATTERY_PIN);
        float voltageAtPin = (adcValue / adcResolution) * referenceVoltage;
        Serial.print("\tADC Voltage:");
        Serial.print(voltageAtPin);
        Serial.print("\tbatteryCalibrationFactor: ");
        Serial.print(f_batteryCalibrationFactor);
      }
      Serial.print("\tlowBatteryCounterTotal: ");
      Serial.print(i_lowBatteryCountTotal);
    }

    if (fuelGaugeLegacyHardware() && inputString.startsWith("vf ")) {
      int adcValue = analogRead(BATTERY_PIN);
      float voltageAtPin = (adcValue / adcResolution) * referenceVoltage;
      float batteryVoltage = voltageAtPin * dividerRatio;
      f_batteryCalibrationFactor = inputString.substring(3).toFloat() / batteryVoltage;
      storagePutFloat(KEY_BAT_CAL, f_batteryCalibrationFactor);

      Serial.print("Battery Voltage Factor set to: ");
      Serial.println(f_batteryCalibrationFactor);
    }

    if (inputString == "bc" || inputString.startsWith("bc ")) {
      uint16_t cap;
      if (!b_hasFuelGauge) {
        Serial.println("Battery gauge unavailable");
      } else if (inputString == "bc") {
        Serial.printf("Battery capacity: %u mAh\n", fuelGaugeDesignCapacityMah());
      } else if (!fuelGaugeParseCapacity(inputString.c_str() + 3, cap)) {
        Serial.println("Invalid capacity (300-2000 mAh)");
      } else if (!storagePutInt(KEY_BAT_CAPACITY, cap)) {
        Serial.println("Battery capacity storage failed; unchanged");
      } else {
        fuelGaugeRuntime.capacityPersistPending = false;
        storagePutBool(KEY_BAT_CAPACITY_SET, true);
        if (fuelGaugeSetCapacity(cap)) {
          Serial.printf("Battery capacity set to: %u mAh\n", cap);
        } else {
          Serial.println("Capacity saved; gauge configuration failed, charging disabled; retry pending");
        }
      }
    }

    if (inputString.startsWith("cv ")) {
      float newCalibrationValue = inputString.substring(3).toFloat();
      if (isValidCalibrationValue(newCalibrationValue)) {
        f_calibration_value = newCalibrationValue;
        scale.setCalFactor(f_calibration_value);
        storagePutFloat(KEY_CAL1, f_calibration_value);
        b_calibrationInvalid = false;
        snprintf(c_calibrationStatus, sizeof(c_calibrationStatus), "%s",
                 calibrationRejectReasonText(CAL_REJECT_NONE));
      } else {
        Serial.print("Ignoring invalid calibration value: ");
        Serial.println(inputString.substring(3));
        b_calibrationInvalid = true;
        snprintf(c_calibrationStatus, sizeof(c_calibrationStatus), "%s",
                 calibrationRejectReasonText(
                   fabsf(newCalibrationValue) > CALIBRATION_VALUE_MAX_ABS
                     ? CAL_REJECT_FACTOR_TOO_LARGE
                     : CAL_REJECT_FACTOR_SIGN));
      }
    }

    if (inputString.startsWith("sot ")) {
      if (setStableOutputThreshold != nullptr) {
        setStableOutputThreshold(inputString.substring(4).toFloat());
      }
    }

    if (inputString.startsWith("tt ")) {
      if (setTrackingThreshold != nullptr) {
        setTrackingThreshold(inputString.substring(3).toFloat());
      }
    }

    if (inputString.startsWith("tui ")) {
      if (setTrackingUpdateInterval != nullptr) {
        setTrackingUpdateInterval(inputString.substring(4).toFloat());
      }
    }

    if (inputString.startsWith("oled ")) {
      int i_oled_contrast = inputString.substring(5).toInt();

      i_oled_contrast = constrain(i_oled_contrast, 0, 255);

#if HDS_ENABLE_ENERGY_MENU
      requestEnergyContrast(static_cast<uint8_t>(i_oled_contrast));
      applyEnergyLowPowerCommand();
#else
      u8g2.setContrast(i_oled_contrast);
#endif

      Serial.print("OLED contrast set to ");
      Serial.println(i_oled_contrast);
    }

    if (inputString.startsWith("oledon")) {
#if HDS_ENABLE_ENERGY_MENU
      requestEnergyDisplay(true);
      applyEnergyDisplayCommand(true);
#else
      u8g2.setPowerSave(0);
#endif
    }
    if (inputString.startsWith("oledoff")) {
#if HDS_ENABLE_ENERGY_MENU
      requestEnergyDisplay(false);
      applyEnergyDisplayCommand(false);
#else
      u8g2.setPowerSave(1);
#endif
    }

    if (inputString.startsWith("reset")) {
      reset();
    }

    if (inputString.startsWith("cal0")) {
      leaveMenu();
      i_cal_weight = 0;
      i_button_cal_status = 1;
      b_calibration = true;
      i_calibration = 0;
    }

    if (inputString.startsWith("cal1")) {
      leaveMenu();
      i_cal_weight = 0;
      i_button_cal_status = 1;
      b_calibration = true;
      i_calibration = 1;
    }

    if (inputString.startsWith("tare")) {
      if ((b_menu || b_calibration || b_showChargingUI) && buttonCircle_Pressed != NULL) {
        buttonCircle_Pressed();
      } else {
        requestRemoteTare();
      }
    }

    if (inputString.startsWith("set")) {
      if ((b_menu || b_calibration || b_showChargingUI) && buttonSquare_Pressed != NULL) {
        buttonSquare_Pressed();
      } else if (toggleTimer != NULL) {
        toggleTimer();
      }
    }

    if (inputString.startsWith("debug ")) {
      b_debug = inputString.substring(6).toInt();
      Serial.print("Debug:");
      if (b_debug)
        Serial.print("On ");
      else
        Serial.print("Off ");
    }

    if (inputString == "tapd on" || inputString == "tapd off") {
      b_tapTraceEnabled = inputString == "tapd on";
      Serial.printf("[TAPTRACE] enabled=%d tare=%d timer=%d\n",
                    b_tapTraceEnabled, b_tapTareEnabled, b_tapTimerEnabled);
    }

#ifdef ESP32
    if (inputString == "wakeinfo") {
      Serial.printf("[wake] reset=%u cause=%u ext1=%llu wow=%d charge=%d circle=%d square=%d",
                    (unsigned)esp_reset_reason(), (unsigned)esp_sleep_get_wakeup_cause(),
                    (unsigned long long)esp_sleep_get_ext1_wakeup_status(), i_wow_interval,
                    digitalRead(BATTERY_CHARGING), digitalRead(BUTTON_CIRCLE), digitalRead(BUTTON_SQUARE));
#ifdef USB_DET
      Serial.printf(" usb=%d", digitalRead(USB_DET));
#endif
      Serial.println();
#if HDS_ENABLE_ENERGY_MENU
      const char *lightSleepProfile =
        !energyPolicy.featureEnabled(EnergyFeature::LightSleep)
          ? "off"
          : energyPolicy.settings.lightSleepPlusActive() ? "plus" : "normal";
      const long buttonPollMs = energyIdle.lastLightSleepButtonPollAt == 0
                                  ? -1
                                  : static_cast<long>(energyIdle.lastLightSleepButtonPollAt -
                                                      energyIdle.lastLightSleepButtonWakeAt);
      const long buttonEventMs = energyIdle.lastLightSleepButtonEventAt == 0
                                   ? -1
                                   : static_cast<long>(energyIdle.lastLightSleepButtonEventAt -
                                                       energyIdle.lastLightSleepButtonWakeAt);
      Serial.printf("[lswake] profile=%s mask=%llu buttons=%lu fast_poll_ms=%ld event_ms=%ld\n",
                    lightSleepProfile,
                    (unsigned long long)energyIdle.lastLightSleepWakeMask,
                    (unsigned long)energyIdle.lightSleepButtonWakeCount,
                    buttonPollMs, buttonEventMs);
#endif
#ifdef ADS1232ADC
      Serial.printf("[wow] source=%d armed=%u baseline=%ld threshold=%ld count=%u raw=%ld,%ld,%ld\n",
                    GPIO_power_on_with, (unsigned)wowRtc.armed,
                    (long)wowRtc.baselineRaw, (long)wowRtc.thresholdRaw,
                    (unsigned)wowWakeDiagnostics.samplesRead,
                    (long)wowWakeDiagnostics.raw[0], (long)wowWakeDiagnostics.raw[1],
                    (long)wowWakeDiagnostics.raw[2]);
#endif
    }
#endif

    if (inputString.startsWith("adsd ")) {
      String cmd = inputString.substring(5);
      cmd.trim();
      if (cmd == "on" || cmd == "1") {
        scale.setDebugEnabled(true);
        Serial.println("ADS1232 debug enabled");
      } else if (cmd == "off" || cmd == "0") {
        scale.setDebugEnabled(false);
        Serial.println("ADS1232 debug disabled");
      } else if (cmd == "info") {
        ADS1232DebugInfo info = scale.getDebugInfo();
        Serial.println("=== ADS1232 Debug Snapshot ===");
        Serial.print("Raw: "); Serial.print(info.rawValue);
        Serial.print(" | Smooth: "); Serial.print(info.smoothedValue);
        Serial.print(" | Tare: "); Serial.println(info.tareOffset);
        Serial.print("SPS: "); Serial.print(info.sps, 2);
        Serial.print(" | ConvTime: "); Serial.print(info.conversionTimeMs, 3);
        Serial.print("ms | Valid: "); Serial.println(info.validSamples);
        Serial.print("CalFactor: "); Serial.print(f_calibration_value, 2);
        Serial.print(" | CalStatus: "); Serial.print(c_calibrationStatus);
        Serial.print(" | CalInvalid: "); Serial.println(b_calibrationInvalid ? "true" : "false");
        Serial.print("LastCal zero/load/delta: ");
        Serial.print(i_lastCalibrationZeroRaw);
        Serial.print(" / ");
        Serial.print(i_lastCalibrationLoadRaw);
        Serial.print(" / ");
        Serial.println(i_lastCalibrationRawDelta);
        Serial.print("LastCal candidate/verified/spread: ");
        Serial.print(f_lastCalibrationCandidate, 2);
        Serial.print(" / ");
        Serial.print(f_lastCalibrationVerifiedWeight, 2);
        Serial.print(" / ");
        Serial.println(i_lastCalibrationSpread);
        Serial.println("==============================");
      }
    }

#ifdef BUZZER
    if (inputString.startsWith("beep")) {
      b_beep = !b_beep;
      storagePutInt(KEY_BEEP, b_beep);
    }
    Serial.print("\tBuzzer:");
    if (b_beep)
      Serial.println("On");
    else
      Serial.println("Off");
#endif
  }
};

void sendUsbVoltage() {
  byte data[7];
  buildVoltagePacket(data);
  Serial.write(data, 7);
}

void sendUsbHeartBeat() {
  byte data[7];
  buildHeartBeatPacket(data);
  Serial.write(data, 7);
}

#if defined(ACC_MPU6050) || defined(ACC_BMA400)
void sendUsbGyro() {
  byte data[7];
  buildGyroPacket(data);
  Serial.write(data, 7);
}
#endif

void sendUsbWeight() {
  byte data[7];
  buildWeightPacket(data);
  Serial.write(data, 7);
}

void sendUsbTextWeight() {
  Serial.print(millis());
  Serial.print(" Weight: ");
  Serial.println(f_displayedValue);
}

void sendUsbButton(int buttonNumber, int buttonShortPress) {
  byte data[7];
  buildButtonPacket(data, buttonNumber, buttonShortPress);
  Serial.write(data, 7);
}

void sendUsbLedResponse() {
  byte data[7];
  buildLedResponsePacket(data);
  Serial.write(data, 7);
}

void buildAdsDebugPacket(byte data[41]) {
  ADS1232DebugInfo info = scale.getDebugInfo();

  data[0] = 0x03;
  data[1] = 0x25;

  data[2] = (info.timestamp >> 24) & 0xFF;
  data[3] = (info.timestamp >> 16) & 0xFF;
  data[4] = (info.timestamp >> 8) & 0xFF;
  data[5] = info.timestamp & 0xFF;

  data[6] = (info.rawValue >> 24) & 0xFF;
  data[7] = (info.rawValue >> 16) & 0xFF;
  data[8] = (info.rawValue >> 8) & 0xFF;
  data[9] = info.rawValue & 0xFF;

  data[10] = (info.smoothedValue >> 24) & 0xFF;
  data[11] = (info.smoothedValue >> 16) & 0xFF;
  data[12] = (info.smoothedValue >> 8) & 0xFF;
  data[13] = info.smoothedValue & 0xFF;

  data[14] = (info.tareOffset >> 24) & 0xFF;
  data[15] = (info.tareOffset >> 16) & 0xFF;
  data[16] = (info.tareOffset >> 8) & 0xFF;
  data[17] = info.tareOffset & 0xFF;

  uint16_t convTime = encodeScaledUInt16(info.conversionTimeMs, 100.0f);
  data[18] = (convTime >> 8) & 0xFF;
  data[19] = convTime & 0xFF;

  uint16_t sps = encodeScaledUInt16(info.sps, 100.0f);
  data[20] = (sps >> 8) & 0xFF;
  data[21] = sps & 0xFF;

  data[22] = info.readIndex & 0xFF;

  data[23] = info.samplesInUse & 0xFF;

  data[24] = g_resetReasonCode;
  memset(&data[25], 0, 13);

  data[38] = (info.dataOutOfRange ? 0x01 : 0x00) |
             (info.signalTimeout ? 0x02 : 0x00);

  data[39] = 0;

  byte checksum = 0;
  for (int i = 0; i < 40; i++) {
    checksum ^= data[i];
  }
  data[40] = checksum;
}

void buildAdsResetResponsePacket(byte data[5], uint8_t mode, uint8_t status) {
  data[0] = 0x03;
  data[1] = 0x26;
  data[2] = mode;
  data[3] = status;
  data[4] = data[0] ^ data[1] ^ data[2] ^ data[3];
}

void sendUsbAdsResetResponse(uint8_t mode, uint8_t status) {
  byte data[5];
  buildAdsResetResponsePacket(data, mode, status);
  Serial.write(data, 5);
}

void handleAdsReset(uint8_t mode) {
  Serial.print("ADS reset mode 0x0");
  Serial.println(mode);

#if HDS_ENABLE_GRINDER
  if (grinderSettings.enabled && grinderRuntime.state != GRINDER_STATE_ERROR &&
      grinderRuntime.state != GRINDER_STATE_DISABLED) {
    grinderEnterError("ADS reset");
  }
#endif
  scale.powerDown();
  delay(500);
  scale.powerUp();

  unsigned long startTime = millis();
  bool adsAlive = false;
  while (millis() - startTime < 500) {
    if (digitalRead(scale.getDoutPin()) == LOW) {
      adsAlive = true;
      break;
    }
    yield();
  }

  if (!adsAlive) {
    Serial.println("ADS reset FAILED: DOUT timeout");
    sendUsbAdsResetResponse(mode, 0x01);
    return;
  }

  Serial.println("ADS reset: DOUT went low, ADC alive");

  if (!refreshScaleDatasetAfterDiscontinuity("ADS reset")) {
    Serial.println("ADS reset FAILED: dataset refresh timeout");
    sendUsbAdsResetResponse(mode, 0x02);
    return;
  }

  if (mode == 0x02) {
    if (!tareScaleWhenAdcReady("ADS reset tare")) {
      Serial.println("ADS reset FAILED: tare refresh timeout");
      sendUsbAdsResetResponse(mode, 0x02);
      return;
    }
    Serial.println("ADS reset: tare complete");
  }
  resetScaleOutputAfterAdcDiscontinuity();

  sendUsbAdsResetResponse(mode, 0x00);
  Serial.println("ADS reset complete");
}

void sendUsbAdsDebug() {
  byte data[41];
  buildAdsDebugPacket(data);
  Serial.write(data, 41);

  Serial.println("ADS Debug packet sent (41 bytes)");
}

#endif
