decentespresso/openscale/include/custom_build_ota.h

#ifndef CUSTOM_BUILD_OTA_H
#define CUSTOM_BUILD_OTA_H

#if HDS_FEATURE_PULL_OTA

#include <Preferences.h>
#include <esp_system.h>

#if __has_include("custom_ota_public_key.h")
#include "custom_ota_public_key.h"
#endif

#ifndef HDS_CUSTOM_OTA_MANIFEST_PUBLIC_KEY_1_PEM
#define HDS_CUSTOM_OTA_MANIFEST_PUBLIC_KEY_1_PEM ""
#endif

#ifndef HDS_CUSTOM_OTA_MANIFEST_PUBLIC_KEY_2_PEM
#define HDS_CUSTOM_OTA_MANIFEST_PUBLIC_KEY_2_PEM ""
#endif

#ifndef HDS_CUSTOM_BUILD_COMBINATION_HASH
#define HDS_CUSTOM_BUILD_COMBINATION_HASH ""
#endif

#ifndef HDS_CUSTOM_BUILD_SERVICE_URL
#define HDS_CUSTOM_BUILD_SERVICE_URL "https://openscale-custom-builds.odevstudio.workers.dev"
#endif

static const char HDS_CUSTOM_BUILD_NVS_NAMESPACE[] = "ota_custom";
static const unsigned long HDS_CUSTOM_BUILD_SCREEN_TIMEOUT_MS = 30000;
static const unsigned long HDS_CUSTOM_BUILD_HOLD_MS = 1200;
static const size_t HDS_CUSTOM_BUILD_RESPONSE_MAX_BYTES = 2048;

struct CustomBuildAssignment {
  bool linked = false;
  bool identityRejected = false;
  String state = "";
  String combinationHash = "";
};

void customBuildRandomHex(char *output, size_t byteCount) {
  uint8_t bytes[32];
  if (output == nullptr || byteCount > sizeof(bytes)) return;
  esp_fill_random(bytes, byteCount);
  for (size_t index = 0; index < byteCount; index++) {
    snprintf(output + index * 2, 3, "%02x", bytes[index]);
  }
  output[byteCount * 2] = '\0';
}

bool customBuildHexValueValid(const String &value, size_t length) {
  if (value.length() != length) return false;
  for (size_t index = 0; index < length; index++) {
    const char character = value.charAt(index);
    if (!((character >= '0' && character <= '9') ||
          (character >= 'a' && character <= 'f'))) return false;
  }
  return true;
}

void customBuildHashPrefix(const String &hash, char output[9]) {
  if (!customBuildHexValueValid(hash, 64)) {
    output[0] = '\0';
    return;
  }
  for (size_t index = 0; index < 8; index++) {
    const char character = hash.charAt(index);
    output[index] = character >= 'a' && character <= 'f'
        ? character - 'a' + 'A' : character;
  }
  output[8] = '\0';
}

bool customBuildLoadCredentials(String &deviceId, String &deviceSecret, bool *pairInitialized = nullptr) {
  Preferences preferences;
  if (!preferences.begin(HDS_CUSTOM_BUILD_NVS_NAMESPACE, false)) return false;
  deviceId = preferences.getString("device_id", "");
  deviceSecret = preferences.getString("device_secret", "");
  if (!customBuildHexValueValid(deviceId, 32) || !customBuildHexValueValid(deviceSecret, 64)) {
    char newDeviceId[33];
    char newDeviceSecret[65];
    customBuildRandomHex(newDeviceId, 16);
    customBuildRandomHex(newDeviceSecret, 32);
    const bool stored = preferences.putBool("pair_init", false) == 1 &&
                        preferences.putString("device_id", newDeviceId) == 32 &&
                        preferences.putString("device_secret", newDeviceSecret) == 64;
    if (!stored) {
      preferences.remove("device_id");
      preferences.remove("device_secret");
      preferences.end();
      return false;
    }
    deviceId = newDeviceId;
    deviceSecret = newDeviceSecret;
  }
  if (pairInitialized != nullptr) *pairInitialized = preferences.getBool("pair_init", false);
  preferences.end();
  return true;
}

bool customBuildRelinkAvailable() {
  Preferences preferences;
  if (!preferences.begin(HDS_CUSTOM_BUILD_NVS_NAMESPACE, true)) return false;
  const bool initialized = preferences.getBool("pair_init", false);
  preferences.end();
  return initialized;
}

void customBuildSerialHint(char output[7]) {
  const uint64_t mac = ESP.getEfuseMac();
  snprintf(output, 7, "%06lX", (unsigned long)(mac & 0xFFFFFFUL));
}

uint32_t customBuildPairPin() {
  const uint32_t range = 1000000;
  const uint32_t limit = UINT32_MAX - UINT32_MAX % range;
  uint32_t value;
  do {
    value = esp_random();
  } while (value >= limit);
  return value % range;
}

bool customBuildRequest(
    const char *path,
    const char *method,
    const String &requestBody,
    String &responseBody,
    int *responseStatus = nullptr) {
  if (responseStatus != nullptr) *responseStatus = 0;
  String deviceId;
  String deviceSecret;
  if (!customBuildLoadCredentials(deviceId, deviceSecret)) return false;
  HTTPClient http;
  WiFiClientSecure client;
  const String url = String(HDS_CUSTOM_BUILD_SERVICE_URL) + path;
  if (!pullOtaBeginHttp(http, client, url)) return false;
  http.addHeader("Authorization", "Bearer " + deviceSecret);
  http.addHeader("X-OpenScale-Device-ID", deviceId);
  int status;
  if (strcmp(method, "POST") == 0) {
    http.addHeader("Content-Type", "application/json");
    status = http.POST(requestBody);
  } else {
    status = http.GET();
  }
  if (responseStatus != nullptr) *responseStatus = status;
  if (status != HTTP_CODE_OK) {
    http.end();
    return false;
  }
  const bool read = pullOtaReadHttpBody(http, responseBody, HDS_CUSTOM_BUILD_RESPONSE_MAX_BYTES);
  http.end();
  return read;
}

bool customBuildCheckIn(
    const String &installedCombination,
    CustomBuildAssignment &assignment,
    const String &installCombination = "",
    const char *installState = "installing") {
  JsonDocument request;
  request["installed_combination"] = !filesystemRecoveryActive.load() && installedCombination.length() > 0
      ? installedCombination.c_str() : nullptr;
  request["firmware_version"] = pullOtaCurrentVersion();
  if (installCombination.length() > 0) {
    request["install_combination"] = installCombination;
    request["install_state"] = installState;
  }
  String requestBody;
  serializeJson(request, requestBody);
  String body;
  int status = 0;
  if (!customBuildRequest("/api/v1/device/check-in", "POST", requestBody, body, &status)) {
    assignment.identityRejected = status == HTTP_CODE_UNAUTHORIZED;
    return assignment.identityRejected;
  }
  JsonDocument document;
  if (deserializeJson(document, body)) return false;
  JsonObject root = document.as<JsonObject>();
  const char *state = root["state"] | "";
  const char *combinationHash = root["desired_combination"] | "";
  assignment.linked = root["linked"] | false;
  assignment.state = state;
  assignment.combinationHash = combinationHash;
  if (assignment.combinationHash.length() > 0 &&
      !customBuildHexValueValid(assignment.combinationHash, 64)) return false;
  return true;
}

void customBuildReportInstallState(const String &combinationHash, const char *state) {
  if (!customBuildRelinkAvailable() || combinationHash.length() == 0) return;
  CustomBuildAssignment assignment;
  customBuildCheckIn(pullOtaCurrentCombinationHash(), assignment, combinationHash, state);
}

void customBuildReportInstalled() {
  if (!customBuildRelinkAvailable()) return;
  pullOtaDraw("Update done", "Syncing status");
  if (!pullOtaEnsureWifi() || !pullOtaClockReady()) return;
  for (uint8_t attempt = 0; attempt < 3; attempt++) {
    CustomBuildAssignment assignment;
    if (customBuildCheckIn(pullOtaCurrentCombinationHash(), assignment)) return;
    if (attempt < 2) delay(1000);
  }
  Serial.println("[custom-ota] Install status report failed");
}

bool customBuildRegisterPairCode(const char *pairCode) {
  JsonDocument document;
  document["pair_code"] = pairCode;
  String requestBody;
  serializeJson(document, requestBody);
  String responseBody;
  if (!customBuildRequest("/api/v1/device/pair", "POST", requestBody, responseBody)) return false;
  JsonDocument response;
  if (deserializeJson(response, responseBody)) return false;
  if (String(response["pair_code"] | "") != pairCode) return false;
  Preferences preferences;
  if (!preferences.begin(HDS_CUSTOM_BUILD_NVS_NAMESPACE, false)) return false;
  const bool stored = preferences.putBool("pair_init", true) == 1;
  preferences.end();
  return stored;
}
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
