decentespresso/openscale/(commit log)

2024-05-28 v4.2
    2024-04-06 v4.0 Add BLE and uuid.
    2024-04-28 v4.1 fix - wrong button oled indicator on rotated display
    fix - "disabled weight in serial" works but "auto tare on espresso mode" doesn't
    fix - when ble app connected, scale can't power off via both button down
    2024-05-13 v4.2 fix - wrong map() usage. map only use long for input, not float.
2025-04-17 Update menu.h
    Fixed a problem that caused calibration to fail.
    [menu.h]
2025-04-17 Update menu.h
    Fixed low/high value rejection broke calibration.
    [menu.h]
2025-05-19 Create README.md
    Establish correct folder ,for uploading current web apps.
2025-05-23 Create dosing_assistant.html
    upload current live version of dosing assistant. 23.05.25
2025-05-23 Add files via upload
    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
2025-05-23 upload current version of dosing assistant
    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
2025-05-23 Create dosing.js
    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
2025-05-23 Create export.js
    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
2025-05-23 Create presets.js
    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
2025-05-23 Create scale.js
    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
2025-05-23 Create state-machine.js
    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
2025-05-23 Create ui-controller.js
    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
2025-05-23 Create same_weight.css
    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
2025-05-26 Create qc.css
    Upload current live version of Quality Control Assistant 26.05.2025
2025-05-26 Create quality_control.js
    upload current version of Quality Control Assistant 26.05.2025
2025-05-26 Create quality_control.html
    upload current version of quality control assistant 26.05.2025
2025-05-27 Create webweigh_output.css
    upload current live version of weigh and save 27.05.2025
2025-05-27 Create main.js
    upload current version of weigh and save 27.05.2025
2025-05-27 Create constants.js
    upload current live version of weigh and save - 27.05.2025
2025-05-27 Create debug-logger.js
    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
2025-05-27 Create debug-logger.js
    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
2025-05-27 Create dosing.js
    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
2025-05-27 Create export.js
    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
2025-05-27 Create led.js
    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
2025-05-27 Add files via upload
    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
2025-05-27 Create base-connection.js
    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
2025-05-27 Create bluetooth-connection.js
    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
2025-05-27 Create usb-connection.js
    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
2025-05-27 Update README.md
    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
2025-06-16 v2.7.2
    Change-log:
    Added a menu option to flip the screen 180 degrees.
    Added a menu option to swap the positions of weight and time.
    Fixed a potential crash when the HDS remained powered on for more than approximately 24.5 days.
    Removed the buzzer menu option and disabled the buzzer function on HDS 8.1.
    Removed gyro initialization code on HDS 8.1 to speed up power-on; gyro functionality has also been removed for HDS 8.1.
    [ble.h, config.h, declare.h, display.h, gyro.h, menu.h, parameter.h, power.h]
2025-06-17 v2.7.3
    Added a menu option to enable button while BLE is connected.
2025-06-19 v2.7.4
    🔧 Fixes
    Fixed an issue where uninitialized EEPROM values (e.g., 255) could cause unexpected behavior in boolean logic.
    Previously, EEPROM.get() would return 255 on first use, which wasn't correctly handled by if (val != 0 && val != 1), due to implicit conversion to bool.
    Now uses explicit validation with uint8_t to ensure only 0 or 1 are treated as valid boolean values.
    ✅ Improvements
    Added helper function readBoolEEPROMWithValidation() to safely read boolean flags from EEPROM and auto-correct invalid values.
    Prevented potential logic bugs in features like screen flip, weight on top, and BLE button, which also relied on improper bool evaluation.
    This change improves stabil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
    [config.h, hds.ino, menu.h, parameter.h]
2025-06-23 v2.7.5
    Unified firmware support for V7.5, V8.0, and V8.1 boards
    Removed PCB version display from the About page
    Fixed - V8.0 HDS can't power up with FW2.7.4
    [ble.h, config.h, menu.h, parameter.h, power.h, usbcomm.h]
2025-08-13 Add web server file hosting (#4)
    Use littlefs
    Switch wifi menu to Wifi toggle (to be replaced with complete wifi menu)
    Start wifi/ota/webserver together if enabled through previously mentioned menu entry
    Update gitignore to exclude pio build
    Build filesystem image from web_apps folder directly
    [hds.ino, menu.h, parameter.h, webserver.h, wifi_ota.h]
2025-08-13 change board name, add nightly builds
2025-08-13 fix: start server even if fs not working
    [webserver.h]
2025-08-13 add websocket sample and implementation (#7)
    Add websocket handler to webserver handling
    Send message via websocket to all clients
    Allow tare from clients via websockets
    Add a sample implementation to index.html
2025-08-13 Wifi connectivity improvements (#9)
    Limit number of websocket clients to 1
    Drop messages if client can't handle them all (to prevent connection dropping)
    Update platform sdk
    Add stop functions, to disconnect from AP and turn off Wifi and web server when powering down
    Increase wait time for connecting to Wifi from 10 to 20 seconds
    Configure webserver to run on core 1 to prevent interference with RF core
    [hds.ino, webserver.h, wifi_setup.cpp, wifi_setup.h]
2025-08-13 Additional WiFi improvements (#11)
    extract wifi intialization functionality
    allow ota loop only while updating firmware in ota mode
    fix shutdown bug with square button
    Increase wifi TX power when connected to another station
    change wifi indicator glyph when in AP mode
    [hds.ino, wifi_setup.cpp]
2025-08-13 Add WebSocket support to web apps (#12)
    * -Implement web socket to weigh and save app
    -When accessing wegh and save from hds.local, no connection via BLE or USB is needed, weight value will render directly via web socket.
    - update main.js , scale.js logic to handle websocket.
    - Added favicon to weigh_save.html.
    * extract wifi init, different glyph for AP, increase power on STA
    * Remove debug level 5
    * qc_assistant_websocket_update
    - implemented web socket
    - remove tare button
    - Added favicon to .html
    * ReconnectingWebSocket update
    -using ReconnectingWebSocket library to improve connection quality.
    -ws will now auto reconnect
    * dosing_assistant_update
    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
2025-08-13 revert to original wifi security and ip settings
    [wifi_setup.cpp]
2025-09-22 button press timing tweaks
2025-10-09 Change charging UI to an icon on bottom right
2025-10-09 Disabled weight check during calibration
    If a user did something wrong during a calibration, a wrong calibration value will be stored. That'll prevent the user from doing another calibration to make it right. So disable the weight check will allow user to correct the calibration value.
    [menu.h]
2025-10-10 new sendledresponse function
    ## Changelog
    ### LED On/Off Command Response
    When receiving the LED on/off command (`03 0A 01` / `03 0A 00`), the program will call `sendBleLedResponse()` / `sendUsbLedResponse()` to send back a data packet containing:
    - **Weight**
    - Encoded in two bytes using `encodeWeight()`.
    - **Battery Status**
    - `0xFF` if the device is charging.
    - Otherwise, the battery percentage is calculated from the measured voltage:
    ```cpp
    perc = (voltage - showEmptyBatteryBelowVoltage) /
    (showFullBatteryAboveVoltage - showEmptyBatteryBelowVoltage) * 100;
    ```
    - Clamped to 0–100%
    - Sent as a single byte in the respons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
2025-10-12 Fix crash when BLE command LED ON was called
    ADS_init(); should be called before ble_init();
    [hds.ino]
2025-10-12 b_ads1115InitFail should be true
    b_ads1115InitFail should be true as default value, because if ads_init was never called, it should indicate a failed init.
    [parameter.h]
2025-10-12 Changed battery voltage reading and comm protocol
    Now the loop() will get the battery voltage every 30 seconds. That'll save ADC reading time, and avoid conflict when getting BLE/USB command to read battery level.
    The duplicated code in both ble and usbcomm was also reduced.
    [ble.h, parameter.h, power.h, usbcomm.h]
2025-10-12 Changed battery reading
    Read the battery once the ADC1115 was inited. And read the battery every 30s in loop()
2025-10-12 Revert "Changed battery reading"
    This reverts commit 84ba528feec42cac884a9e5df6f3c329a5e0d15c.
    [hds.ino]
2025-10-12 Revert "Changed battery voltage reading and comm protocol"
    This reverts commit 2b98dc7dfebd7391785dc573353d53acb6c77ab9.
    [ble.h, parameter.h, power.h, usbcomm.h]
2025-10-12 Revert "b_ads1115InitFail should be true"
    This reverts commit c775b0309b6252a728381ac733824126b0c9b604.
    [parameter.h]
2025-10-12 Changed battery reading
    Read the battery once the ADC1115 was inited. And read the battery every 30s in loop().
    And ADS_init was moved before ble_init was called.
2025-10-12 Fixed no Off on screen by BLE off command
    Add b_powerOff check in loop() to jump out of the u8g2 cycle to show Off message correctly when using BLE command to power off HDS.
    [hds.ino]
2025-10-12 Off message fix
    When the BLE command tells the HDS to power off, it often just blink a little and no Off message is shown.
    b_powerOff was added, and when it was set to true, the loop() will check it and goes off.
    This bug is because when inside a u8g2 cycle, another u8g2 cycle was called by BLE command. It should wait for the current cycle to complete then show the Off message.
    Also, the shut_down_now_nobeep called in setup() was also changed to esp32_sleep(), because the nobeep function contains u8g2 code, which was never inited.
    [ble.h, hds.ino, parameter.h, usbcomm.h]
2025-10-15 add reset wifi hds setup menu option
    [menu.h]
2025-11-24 use buffer for calibration value
2025-11-25 fix crash when wifi is disabled in eeprom
    [hds.ino]
2025-11-25 no battery update fix
    There should be a millis() given to t_batteryRefresh for it to update the battery level in loop(). Another if (t_batteryRefresh > 0){ was added to ensure the power off low battery was only called once the updateBattery() was called first.
    [hds.ino, power.h]
2025-11-26 very quick touch will drain battery fix
    very quick touch may drain the battery cause the else {
    // If the button is released
    if (b_button_pressed) {
    will make the program fall in to a while loop, when a very short press causing b_button_pressed is false, and esp32_sleep() would be never called.
    [hds.ino]
2025-12-02 don't turn on wifi if charging only
2025-12-02 reconfigure button taps
2025-12-04 fix: prevent scaleTimer trigger immediately after menu exit
    - Add t_menuExitTime variable to track menu exit time
    - Implement 500ms protection period after exiting menu
    - Prevent scaleTimer() from triggering during menu transition
    [hds.ino, menu.h, parameter.h]
2025-12-22 Drift factor debug test
    Usage
    TUI 500: Sets TRACKING_UPDATE_INTERVAL to 500 ms. This defines the tracking update interval.
    TT 0.2: Sets TRACKING_THRESHOLD to 0.2 g. This defines the tracking stability threshold.
    SOT 0.2: Sets STABLE_OUTPUT_THRESHOLD to 0.2 g. This defines the minimum change required to update the output. It does not affect drifting behavior.
    [hds.ino, parameter.h]
2025-12-22 added drift compensation and menu
    [hds.ino, menu.h, parameter.h]
2025-12-22 feat: add threshold-based drift compensation
    This option is enabled by default, with a threshold set to 0.05 g. When enabled, the HDS only registers a change if a new sample differs from the previous value by more than ±0.05 g.
    This function does not change the intrinsic resolution of the load cell, but it significantly improves the effective precision and measurement repeatability of the scale. By suppressing very small fluctuations and noise, repeated measurements under identical conditions become more stable and consistent.
    In addition, this feature helps compensate for slow drift caused by temperature-related effects. This includes not only changes in ambient temperature, but also the s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
    [hds.ino, parameter.h]
2026-01-12 finger detection
2026-01-12 finger detection for both buttons
2026-01-12 fix timer started when exiting menu
    [hds.ino]
2026-01-15 removed fingerDetectionSerial and move code to finger_detection.h
2026-01-28 ble delay and millis() suggestion
2026-02-02 removed no weight detected
    No weight detected used to prevent user from doing a wrong calibration.
    But when user change another load cell, or user accidentally performed a successful wrong calibration, the cal_value will be very wrong, thus enter the "if (abs(d_weight) < 5)" and oled will show no weight detected, and block user from recalibration.
    [menu.h]
2026-03-22 add send_on_enter filter to pio config
2026-03-22 wire to usb
2026-03-22 feat: add ADS reset response packet builder
    [usbcomm.h]
2026-03-22 feat: add ADS reset handler with failure detection
    [usbcomm.h]
2026-03-22 feat: wire ADS reset hex command 0x26 into dispatch
    [usbcomm.h]
2026-03-22 allow more samples
2026-03-24 fix: reset heartbeat timer on BLE connect to prevent immediate disconnect
    In v3.0.6 the onConnect callback stopped resetting t_heartBeat, causing
    disconnects after the t_firstConnect grace period if the client hadn't
    sent an explicit heartbeat packet yet.
    [ble.h]
2026-05-04 Harden USB commands and calibration refresh
2026-05-04 Fix charging wake recovery
    [hds.ino, power.h]
2026-05-08 Show ADC recovery instead of stuck zero
    [display.h, finger_detection.h, hds.ino, parameter.h, usbcomm.h]
2026-05-08 Revert AC() macro cast — degrade type safety, unnecessary since all callers pass const char*
    [display.h]
2026-05-11 Fix drift compensation reset state
    [hds.ino]
2026-05-11 Add BLE debug packet support (HDS Doctor over BLE)
    Add 0x25 BLE write command to stream the 41-byte ADS1232 debug
    packet over the existing notify characteristic (fff4). Uses the
    same buildAdsDebugPacket() builder as the USB path.
    Modes (data[2]):
    0x00 - OFF
    0x01 - CONTINUOUS (rate-limited to ~10 Hz)
    0x02 - SINGLE (auto-clears to OFF after one notify)
    Eliminates USB-cable drag during diagnostics, which was producing
    false drift failures.
    Closes #48
    [ble.h, hds.ino]
2026-05-11 Fix BLE monitor: heartbeats + write-with-response
    Firmware char 36f5 is PROPERTY_WRITE only (no write-without-response),
    so response=False was silently dropped on some stacks.
    Firmware also disconnects after 5s without a Decent Scale heartbeat
    (03 0A 03 FF FF 00 0A). Run a background task in BleMonitor that
    sends one every 2s while connected.
    [ads_debug_monitor_ble.py]
2026-05-14 Switch to trunk-based flow; bump version to 3.0.9
    Move to a single long-lived branch (main) plus short-lived feature
    branches. The develop/main split caused perpetual merge conflicts
    because commits were re-applied across branches rather than merged,
    so git treated identical changes as distinct patches.
    - nightly build now triggers on push to main instead of develop
    - release workflow now accepts any tag reachable from main, instead
    of requiring the tag to be exactly at main's tip, so development
    can continue while an older commit is released
    - bump firmware version to 3.0.9 for the next cycle
    [config.h]
2026-05-15 Normalize line endings to LF
    Add .gitattributes pinning all text files to LF. The include/ headers
    and src/hds.ino were CRLF while the rest of the tree was LF, which
    produced whitespace-only diff noise whenever an editor touched them.
    This commit is line-ending only — no content changes.
    [ble.h, config.h, declare.h, display.h, espnow.h, finger_detection.h, gyro.h, hds.ino]
2026-05-15 Fix BLE deviceConnected race on transient reconnect
    MyServerCallbacks only overrode the connId-blind 1-arg onConnect/
    onDisconnect. Under NimBLE (the esp32s3 BLE stack since arduino-esp32
    3.3), a transient central reconnect can deliver the disconnect event
    for an old conn handle *after* the new connection's onConnect. The
    stale onDisconnect then cleared deviceConnected/connId while the new
    link was still live — leaving the BLE icon blinking and weight
    notifications suppressed (sendBleWeight gates on deviceConnected),
    even though incoming writes like tare still worked.
    Use the NimBLE connection-aware overloads (BLEServer*, ble_gap_conn_desc*)
    and track connId by conn_handle. onDisconnect n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
    [ble.h]
2026-05-15 Gracefully tear down BLE before power-off and restart
    No shutdown path released BLE: the chip entered deep sleep (or
    restarted) without terminating the link, so the connected central only
    noticed via supervision timeout — an ungraceful drop. That stale link
    is also a likely trigger for the deviceConnected reconnect race fixed
    in the previous commit.
    Add bleShutdown() in ble.h: terminate the connection so the peer sees a
    clean disconnect, wait for the terminate to transmit and onDisconnect
    to run, stop advertising, then deinit the stack. A fixed delay is used
    rather than polling deviceConnected so BLEDevice::deinit() cannot race
    a still-running onDisconnect callback.
    Call it from esp32_sl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
    [ble.h, power.h]
2026-05-15 Centralize WiFi and web server teardown in shutdown path
    stopWebServer()/stopWifi() were called ad hoc at six shutdown trigger
    sites and missing from the timer, gyro, low-battery and accident-touch
    paths entirely. Move them to esp32_sleep() — the single chokepoint every
    shutdown path funnels through — next to bleShutdown(), and to reset(),
    so every power-off and restart tears down the network stack
    consistently.
    Removes the six scattered calls. The ble.h onWrite removal also gets
    the teardown off the NimBLE host-task context: the BLE power-off
    command now only sets b_powerOff, and the main loop owns teardown.
    Both stop functions are idempotent and safe to call when WiFi/server
    were nev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
    [ble.h, hds.ino, power.h]
2026-05-22 feat: WiFi scale support — WebSocket control + events
    Extend the /snapshot WebSocket beyond a one-way weight stream into a
    full control + event protocol so web/app clients reach feature parity
    with BLE:
    * Event broadcasts: button presses (sendWebsocketButton) and
    power-off reasons (sendWebsocketPowerOff) wired into the same call
    sites as their BLE/USB equivalents.
    * Status frames: sendWebsocketStatus / sendWebsocketStatusAll publish
    battery %, voltage, charging, timer, display, soft-sleep, LED, and
    rate state. Periodic broadcast every WEBSOCKET_STATUS_NOTIFY_INTERVAL_MS.
    * Commands accepted as text or JSON: status, events on/off, tare,
    timer start/stop/zero, led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
2026-05-22 fix: defer WS hardware ops to main loop; clean up webserver init
    The /snapshot WebSocket handler runs on the AsyncTCP task. Several
    commands (display, low_power, sleep, power_off) were calling
    u8g2.setPowerSave / u8g2.setContrast / digitalWrite(PWR_CTRL,...)
    directly from that task while the main loop hammered the same
    peripherals — under feature-test load at 10Hz this caused the device
    to stall for ~4s and HTTP responses to time out mid-body.
    * Add a portMUX-protected pending-action mask. The WS callback
    queues the hardware op and updates the matching state flag
    (b_u8g2Sleep / b_softSleep) synchronously so the status frame is
    accurate; the main loop drains the mask early in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
    [hds.ino, parameter.h, webserver.h, wifi_setup.cpp]
2026-05-22 fix: review feedback — volatile cross-task globals, atomic mask replace
    Code review on PR #54 caught two real bugs in the deferred-action fix:
    1. The pending-mask let opposing actions accumulate. If a client sent
    "display off" then "display on" before the main loop drained, both
    bits were set and processWsPendingCmds ran them in source order —
    final hardware ended up off while b_u8g2Sleep reported on. Add a
    wsReplacePending(set, clear) helper that atomically supersedes
    the opposing bit, and use it for the three mutually-exclusive
    pairs (display, low_power, sleep).
    2. The new WS state globals (weightWebsocketNotifyInterval,
    b_websocketEventsEnabled, b_websocketLowPo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
    [hds.ino, parameter.h]
2026-05-22 feat: allow multiple concurrent WS clients (web UI + app)
    The previous middleware returned 503 to any client past the first,
    which meant opening the on-device web UI prevented a phone/desktop
    app from connecting to the same scale. Drop the cap and let the
    library handle multi-client.
    * include/webserver.h: remove the count-checking middleware so any
    handshake within the library's DEFAULT_MAX_WS_CLIENTS limit
    succeeds.
    * src/hds.ino: call websocket.cleanupClients() with no argument so
    we inherit the library default (DEFAULT_MAX_WS_CLIENTS, which is
    8 on ESP32). Plenty of RAM headroom — ~12-14 KB per client on
    top of ~240 KB free heap.
    * src/hds.ino WS_EVT_DISCONNE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
    [hds.ino, webserver.h]
2026-05-22 feat: advertise _decentscale._tcp DNS-SD service for discovery
    A bare hds.local A record isn't reliably resolvable on Android (the
    OS resolver doesn't do mDNS and a direct app-socket query gets the
    unicast reply dropped). A DNS-SD service is discoverable through
    Android's NsdManager, Bonjour, and Avahi.
    Register `_decentscale._tcp` on port 80 (the HTTP/WS port) alongside
    the existing hostname, with a friendly instance name and TXT records
    so a discovery UI can label the device and connect without guessing:
    instance: "Half Decent Scale"
    port: 80
    TXT: fw=FW: 3.0.9 model=hds proto=ws path=/snapshot
    Uses the Arduino ESPmDNS wrapper (same ESP-IDF mdns component as the
    raw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
    [wifi_setup.cpp]
2026-05-22 refactor: move WS code to websocket.h + address review feedback
    Addresses tadelv's review on PR #54:
    - Extract all WebSocket protocol code from hds.ino into include/websocket.h
    - Multi-client: send weight/status per-client (getClients + canSend) instead
    of the availableForWriteAll() all-or-nothing gate that coupled every client
    to the slowest one
    - Document the unauthenticated trusted-LAN trust model (code + README),
    including the non-recoverable remote `power off` caveat
    - low_power: clear b_websocketLowPowerEnabled when a button restores full
    contrast so the status frame matches hardware
    - soft_sleep on: set b_u8g2Sleep so display_on reports correctly
    - Defer WS timer start/stop/z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
    [hds.ino, parameter.h, websocket.h, wifi_setup.cpp]
2026-05-22 fix: WS broadcast races getClients(); revert to lock-safe printfAll
    Follow-up to PR review: the per-client broadcast loop introduced a
    use-after-free. websocket.getClients() returns the client list without
    taking the library's _ws_clients_lock, so iterating it on the loop task
    races _handleDisconnect erasing a client on the AsyncTCP task
    (ASYNCWEBSERVER_USE_MUTEX defaults to 1).
    Use printfAll() instead: it holds the client-list mutex and queues to each
    client independently, so the multi-client decoupling is preserved (the
    availableForWriteAll() gate stays removed) without the race. With
    setCloseClientOnQueueFull(false) a backed-up client drops its own frame
    without blocking the others.
    Als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
    [websocket.h]
2026-05-22 feat: return error frame for unrecognized WS commands
    sendWebsocketError() existed but was never wired up, so malformed JSON or
    an unknown command produced silence — a client couldn't tell a rejected
    command from a frame that never arrived. The WS data handler now checks the
    handleWebsocketRateCommand() return value and replies with a
    {type:"error", code:"unknown_command"} frame on failure. The legacy bare
    `tare` string is handled earlier and stays intentionally silent. Error
    frame documented in README.
    [websocket.h]
2026-05-22 test: add WebSocket feature regression script
    Adds tools/ws_feature_test.py, a scriptable check of the /snapshot
    WebSocket protocol: weight stream, status fields (incl. led removal),
    events, rate negotiation, the new error frame, deferred-timer behavior,
    display/low_power/soft_sleep state, and multi-client serving (a peer
    disconnect must not stall the survivor). Run against a WiFi-enabled scale
    (pip install websocket-client); 16/16 pass on device. Linked from README.
    [ws_feature_test.py]
2026-05-25 docs: add CLAUDE.md with project gotchas
    * docs: add CLAUDE.md with project gotchas
    Captures project-specific knowledge that isn't obvious from the code:
    * Build / flash / serial commands (including the pyserial workaround
    when pio device monitor can't get a PTY).
    * Code layout: explains the unusual "headers contain implementations"
    pattern, where setup() / loop() live, what's in config.h.
    * Threading model: WS event callback runs on the AsyncTCP task on a
    different core; what's safe / unsafe to share with the main loop;
    the wsPendingMask deferral pattern; why cross-task globals need to
    be marked volatile.
    * WiFi/BLE coexistence: do NOT call WiFi.setSleep(false)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
2026-05-25 feat: WiFi reliability + true 10 Hz output across WiFi/BLE/USB (#56)
    * fix(wifi): recover from deauth with reconnect supervisor + heap watchdog
    Connect-once-at-boot left WiFi dead until reboot after a STA deauth (common
    under BT/WiFi coexistence). Add a WiFi event handler that logs disconnect
    reason + heap; a loop supervisor that reconnects with exponential backoff
    (quiet gaps so a rate-limiting AP can recover, and disables the core's fixed
    auto-reconnect), recovers from WL_STOPPED, and re-advertises mDNS on reconnect;
    plus a heap watchdog that reboots on sustained critically-low heap (an OOM
    otherwise wedges the lwIP/IP stack while the main loop keeps running).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
    [ble.h, ble_scale_client.py, conn_churn.py, declare.h, hds.ino, mdns_stress.py, parameter.h, reach_probe.py]
2026-05-26 fix: prevent WS-broadcast OOM crash under connection churn
    Root-caused from a captured panic backtrace: under sustained multi-client
    WiFi load (WS connection churn + the 10 Hz weight broadcast), free heap
    collapses and AsyncWebSocket's printfAll path allocates an
    AsyncWebSocketMessage per client -> operator new throws std::bad_alloc ->
    (Arduino-ESP32 is -fno-exceptions) std::terminate() -> abort() -> reboot.
    That OOM-reboot is the "weight stops being collected under load" failure
    (not thermal -- die temp was 33 C). Decoded stack:
    operator new -> __cxa_throw -> std::terminate -> abort
    AsyncWebSocketClient::_queueMessage (AsyncWebSocket.cpp:490)
    AsyncWebSocket::printfAll
    sendWebsocket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
    [websocket.h]
2026-05-27 first pass integrating adc lib
2026-05-27 swap adc repo
2026-05-27 chore: pin ADS1232 lib to sha + document ADC footguns
    Pin decentespresso/ADS1232_ADC to the reviewed/tested commit (lib has no
    semver tags; unpinned URL = non-reproducible builds). Document the new
    external-lib layout and its footguns: polling-mode only (its FreeRTOS task
    pins core 1, same as AsyncTCP), setSamplesInUse() buffer-wipe blip, and the
    zero-filled USB debug bytes.
2026-05-27 chore: bump ADS1232 pin to SPS-fix commit
    Picks up decentespresso/ADS1232_ADC 17703305 — conversion timing now
    measures the true inter-sample interval (reports ~10 SPS) instead of the
    bit-bang read duration (bogus ~11kHz). Verified on hardware.
2026-05-28 fix: tighten WS heap defenses (cap=4, broadcast floor 32K) (#61)
    Under sustained multi-protocol load (4+ WS clients + BLE + USB) the
    default WS client cap of 8 lets per-client queue + AsyncWebSocketMessage
    allocations overcommit heap to the point where lwIP TX buffers starve
    silently — WiFi reports status=CONNECTED, disc/rec never increment, but
    packets drop. Two small knobs together close the gap:
    * cleanupClients(4) — halves worst-case connection overcommit.
    Real workloads (on-device UI + PRs/Decenza + occasional second
    client) cap out at 3–4; 8 was always headroom for edge cases that
    don't happen on this hardware.
    * WS_BROADCAST_HEAP_FLOOR raised 25000 → 32000. T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
    [hds.ino, websocket.h]
2026-05-28 fix(ws): remove periodic status broadcast; align push pattern with BT (#62)
    * fix(ws): remove periodic status broadcast; align push pattern with BT
    The /snapshot WebSocket was the only protocol pushing periodic state
    snapshots. BT notifies only weight + on-event (power_off, buttons); USB
    binary follows the same shape. WiFi did a periodic status frame every
    5 s when events_enabled, which:
    - allocated ~310 B x N clients every 5 s for state the on-device web
    apps never consumed (verified: zero references to battery_percent,
    timer_seconds, charging, low_power, etc. in web_apps/)
    - was the dominant heap-pressure source in the 8 h soak that
    motivated PR #61
    - was inconsistent w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
    [hds.ino, parameter.h, websocket.h]
2026-05-28 feat(adc-debug): expose esp_reset_reason in ADS1232 debug packet
    Capture esp_reset_reason() once in setup() and surface the raw code at
    byte 24 of the 41-byte ADS1232 debug packet (USB binary 0x25 + BLE
    notify on fff4). Byte 24 was previously zero-filled after the ADC
    library swap freed up the old stats window; bytes 25-37 stay reserved.
    Makes a spontaneous brownout / panic / watchdog mid-capture attributable
    from the same channel host tools are already consuming, instead of
    looking like a clean power-on. No protocol shape change; existing
    consumers ignoring byte 24 are unaffected.
    Boot log gets a one-line "[boot] reset_reason=<name> (<code>)" for
    serial captures.
    [hds.ino, parameter.h, usbcomm.h]
2026-06-03 Expose more settings in status frame
2026-06-08 fix: harden firmware bug-audit findings
    [ble.h, display.h, espnow.h, hds.ino, menu.h, parameter.h, usbcomm.h]
2026-06-08 fix: load quick boot status at startup
    [hds.ino]
2026-06-08 fix: report wifi credential save failures
    [webserver.h, wifi_setup.cpp, wifi_setup.h]
2026-06-08 fix: validate calibration factors
    [hds.ino, menu.h, parameter.h, usbcomm.h]
2026-06-08 fix: buffer usb stream frames
    [hds.ino, usbcomm.h]
2026-06-09 fix: pick strongest BSSID across multi-AP SSIDs
    arduino-esp32's WiFi.begin() defaults are FAST_SCAN + persistent(true): it
    stops scanning at the first BSSID that matches the configured SSID, and
    caches that BSSID in NVS for the next association. On a single-AP network
    that's fine. On a multi-AP setup where the same SSID is broadcast from
    several APs on different channels (common with UniFi / mesh / multi-room
    deployments), it associates to whichever BSSID happens to be on the first-
    scanned channel -- or worse, to a cached BSSID from a previous association
    where the scale was somewhere else in the building. The scale ends up
    sticky to a weak or unreachable AP even when a stronger one is righ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
    [wifi_setup.cpp]
2026-06-18 fix: round oled weight display
    [hds.ino]
2026-06-22 fix: disable LittleFS web app caching
    Add no-store Cache-Control headers for LittleFS static files so updated HTML, JS, and CSS assets are not served stale after firmware/filesystem updates.
    [webserver.h]
2026-06-22 fix: harden calibration fault handling
    Harden calibration by using fresh zero/load ADC captures, validating raw-delta-derived factors before saving, preserving the previous EEPROM calibration on failures, and surfacing clear calibration fault diagnostics without changing the /snapshot schema or ADS debug packet format.
    [ble.h, calibration_validation.h, hds.ino, menu.h, parameter.h, test_calibration_validation.py, usbcomm.h]
2026-06-22 chore: pin pioarduino platform to 3.3.9 + warn when behind stable
    The `platform =` pin used the rolling `stable` tag, whose release asset
    mutates in place. It silently moved to arduino-esp32 3.3.9 on 2026-06-04,
    but both local and CI builds stayed on the cached 3.3.8 -- the v3.0.10
    release build resolved framework 3.3.8 (confirmed in the Release CI log),
    so the framework version was neither knowable from platformio.ini nor
    reproducible. 3.3.8 also lacks the upstream BLE map-lock fix for the
    nimble_host LoadProhibited crash tracked in #59.
    Changes:
    - Pin platform to the explicit 55.03.39 URL (= arduino-esp32 3.3.9), which
    carries the BLE fix (BLEServer now guards m_connectedServersMap with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
    [check_platform_freshness.py]
2026-06-22 fix: wait for ADC to settle before capturing calibration load
    Since 3.0.10 the hardened calibration routine (commit ffa4cbb) rejected
    otherwise-valid calibrations with reason=unstable_load on hardware that
    weighs perfectly. Root cause is an interaction with the #60 ADS1232_ADC
    lib swap: setSamplesInUse(16) clears the lib's ring buffer and the
    smoothed value ramps up over the next ~16 samples (and again after a load
    step). calibrationCaptureRaw() grabbed the first two reads where
    validSamples>=16 -- i.e. mid-ramp -- so the captured load delta was a
    fraction of the settled value and the two reads differed wildly.
    Observed on a unit with a known-good factor (~1133, reads a 50 g weight as
    49.95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
    [menu.h]
2026-06-22 docs: note setSamplesInUse ramp affects one-shot calibration captures
    The setSamplesInUse() ramp footgun has a second victim beyond live
    sensitivity switches: a one-shot measurement taken mid-ramp (calibration
    load capture) reads far below settled and trips the stability gate. Cross-
    reference PR #71 and the settle-wait fix so the next reader connects the
    two changes.
2026-06-22 test: add ADC calibration and tare regressions
2026-06-22 fix: harden ADC tare and calibration state after discontinuities
    [calibration_validation.h, hds.ino, menu.h, parameter.h, usbcomm.h, websocket.h]
2026-06-22 tools: update ADS reset mode descriptions
    [ads_debug_monitor.py, decode_ads_debug.py]
2026-06-23 fix: 0g stuck
    ## Root cause: GPIO back-feed through ESD diodes
    The `TPS22860` load switch that gates `3V3_PERIPH` (power for OLED, ADS1232,
    REF5025, ADS1115) does not fully isolate when off. During deep sleep, ESP32
    GPIOs connected to these devices leak current through their internal ESD
    protection diodes into the `3V3_PERIPH` rail, keeping it at a small residual
    voltage:
    | Battery | 3V3_PERIPH residual |
    |---------|---------------------|
    | 3.5V | 0.295V |
    | 3.6V | 0.308V |
    | 3.7V | 0.319V |
    | 3.8V | 0.331V |
    | 3.9V | 0.342V |
    | 4.0V | 0.356V |
    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
    [hds.ino, power.h]
2026-06-23 fix(power): improve deep-sleep wake handling
    Improve GPIO hold behavior during deep sleep and keep existing HDS wake behavior intact.
    [hds.ino, power.h]
2026-06-24 refactor(protocol): share USB frame length metadata
2026-06-24 fix(power): centralize battery voltage conversion
    [power.h]
2026-06-24 fix(tools): align ADS debug decoder with current packet layout
    [decode_ads_debug.py, test_decode_ads_debug.py]
2026-07-01 Prepare HDS 3.1.12-preview.2 ADS startup and wake handling
    Pins the official hardened ADS1232 driver, refreshes ADS after Soft Sleep wake without auto-tare, and defers boot tare until startup input conditions settle.
2026-07-04 fix: allow signed HDS calibration factors
    [calibration_validation.h, test_calibration_validation.py]
2026-07-04 fix: delay boot tare until wake buttons are released
    [hds.ino, test_calibration_validation.py]
2026-07-04 fix(firmware): make wifi shutdown idempotent
    [wifi_setup.cpp]
2026-07-04 fix: allow calibration with usb attached
    [menu.h, test_calibration_validation.py]
2026-07-04 fix: show calibration choices with usb attached
    [menu.h, test_calibration_validation.py]
2026-07-10 fix: make remote soft wake idempotent (#83)
    [ble.h, test_soft_sleep_ads_wake.py, usbcomm.h, websocket.h]
2026-07-10 fix: enable radios when waking from charging (#84)
    [hds.ino, test_charging_wake_contract.py]
2026-07-13 Add HDS Tasmota grinder TCP mode (#82)
    * feat: add experimental Tasmota grinder mode
    * feat: add grinder zero-exit cutoff guard
    * feat: harden grinder arming and discovery
    * fix: guard grinder menu chord entry
    * fix: start wifi for manual grinder discovery
    * fix: stop grinder cutoff on stale plug connection
    * fix: keep grinder plug lookup lightweight
    * refactor: prune grinder discovery cleanup
    * fix: timeout grinder pending commands
    * docs: add HDS Tasmota grinder manual
    * docs: clarify Tasmota grinder usage
    * fix: default grinder safety to 2g
    * fix: add manual grinder TCP discovery fallback
    * fix: harden grinder discovery and WiFi handling
    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
    [grinder_adaptive_safety.h, grinder_discovery.h, grinder_protocol.h, grinder_runtime.h, grinder_runtime_adaptive.h, grinder_runtime_low_latency.h, grinder_settings_persistence.h, hds.ino]
2026-07-13 fix: lock partition table to default_8MB.csv (#90)
    * fix: lock partition table to default_8MB.csv
    Replace the commented-out placeholder partition table with the upstream
    arduino-esp32 default_8MB.csv. This gives two ~3.2 MB OTA app slots,
    ~1.5 MB LittleFS, and a 64 KB coredump partition.
    HDS <= 2.0 uses 16 MB flash; HDS 2.0 will use 8 MB. Pinning to 8 MB now
    ensures the HDS 2.0 flash-size transition needs no partition table
    change — the firmware already fits in 8 MB, avoiding a flash erase +
    re-flash that OTA alone can't perform.
    Trade-off: wastes upper 8 MB on current HDS 1.x hardware (16 MB flash).
    * fix: vendor partition CSV and add CI assertion
    Vendor the upstream default_8MB.csv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
    [default_8MB.csv]
2026-07-13 fix: recover grinder after stable zero (#91)
    [grinder_runtime.h, grinder_runtime_low_latency.h, test_grinder_tcp_contract.py]
2026-07-13 Add production signed WiFi OTA updates (#87)
    * build: add signed OTA manifest tooling
    * feat: add signed WiFi pull OTA picker
    * feat: stage LittleFS OTA with rollback
    * docs: document production WiFi OTA flow
    * build: always require LittleFS for WiFi OTA releases
    * fix: recover staged OTA transaction
    * fix: bound OTA release catalog
    * fix: verify generated OTA manifest signature
    * fix: reject stale pending LittleFS state
    * test: cover OTA version selection natively
    * test: exercise OTA catalog ordering natively
    * test: cover OTA headers in storage contract
    * fix(ota): skip rollback check when no updates
    [config.h, generate_release_manifest.py, hds.ino, menu.h, ota_rollback.h, parameter.h, pull_ota.h]
2026-07-14 docs: add token-friendly AI repository guidance (#89)
    * docs(ai): add firmware notes
    * docs(ai): add GPIO notes
    * docs(ai): add build notes
    * docs(ai): add OTA notes
    * docs(ai): add storage notes
    * docs(ai): add protocol notes
    * docs(ai): add repository map
    * docs(ai): add agent router
    * docs(ai): align Claude router
    * docs(ai): address routing review
    * docs(ai): correct OTA recovery and AP details
    * docs(ai): make guidance task-directed
    * test(docs): validate source-derived AI guidance
    * test(docs): cover all documented repository paths
    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
    [test_ai_docs_contract.py]
2026-07-22 fix: probe incomplete grinder mDNS results (#96)
    [grinder_discovery.h, test_grinder_tcp_contract.py]
2026-07-22 fix: tolerate transient grinder heartbeat loss (#94)
    * fix: tolerate transient grinder heartbeat loss
    * fix: reconnect after grinder plug restart
    [grinder_protocol.h, grinder_runtime.h, grinder_runtime_low_latency.h, test_grinder_contract.cpp, test_grinder_tcp_contract.py]
2026-07-22 feat(ota): trust three release signing keys (#93)
    * feat(ota): trust three release signing keys
    * fix(ota): keep existing release secret scope
    * fix(ota): validate release key ring
    [pull_ota.h, test_ota_public_key_header.py, test_pull_ota_contract.py, test_release_workflow_contract.py, write_ota_public_key_header.py]
2026-07-23 fix(ota): generate public keys for every build (#98)
    * fix(ota): generate public keys for every build
    * fix(ota): harden key prebuild portability
    [ota_public_key_header.py, test_ota_public_key_header.py, write_ota_public_key_header.py]
2026-07-23 fix(build): pin release dependencies (#100)
    * fix(build): pin release dependencies
    * fix(ci): build pinned dependencies in pull requests
    [test_release_workflow_contract.py]
2026-07-23 fix(release): derive firmware version from tag (#99)
    * fix(release): derive firmware version from tag
    * fix(release): preserve tag in manifest URLs
    [config.h, git_rev_macro.py, test_release_workflow_contract.py]
2026-07-23 fix(ci): separate snapshot dependency inventory (#102)
    [test_release_workflow_contract.py]
2026-07-26 fix: recover grinder plug connection after heartbeat loss (#105)
    * fix grinder reconnect recovery
    * preserve tare baseline across reconnects
    * bound grinder recovery retries
    * keep grinder recovery retrying
    * fix grinder plug mDNS browsing
    * update esp mDNS browser fixes
    * shorten grinder plug mDNS browsing
    [grinder_discovery.h, grinder_protocol.h, grinder_runtime.h, parameter.h, test_grinder_contract.cpp, test_grinder_tcp_contract.py]
2026-07-26 avoid WebSocket weight formatting allocation (#106)
    [websocket.h]
2026-07-29 Round Decent fixed-point values (#110)
    [decent_protocol.h]
2026-07-31 Fix BLE notification and heartbeat state races (#112)
    * fix BLE weight delivery after reconnect
    * use live BLE state for notifications
    * keep BLE button state consistent
    * load heartbeat policy before BLE startup
    * keep scale awake for live BLE clients
    * recover FFF4 subscriptions
    * serialize FFF4 recovery mailbox
    * run BLE recovery checks in CI
    * fix BLE recovery edge cases
    [ble.h, finger_detection.h, hds.ino, parameter.h, test_ble_subscription_contract.py]
2026-08-02 feat(wifi): make the mDNS name configurable
    Every scale hardcoded MDNS.begin("hds"), MDNS.setInstanceName("Half Decent
    Scale"), and WiFi.setHostname("hds.local"), so two scales on one LAN both
    asked for the same identity. The mDNS stack resolves that collision by
    suffixing the loser to hds-2.local, but which scale wins follows boot order,
    and hostname and instance name are probed independently -- so a browse can
    show a scale whose address and label disagree.
    Store a device name in the NVS wifi namespace under mdns_name, defaulting to
    "hds" so an unrenamed scale still answers at hds.local. The name drives the
    mDNS hostname, the DHCP hostname (now a bare label, not "hds.local"), the
    DNS-SD in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
    [mdns_name.h, menu.h, test_mdns_name_contract.py, webserver.h, websocket.h, wifi_setup.cpp, wifi_setup.h]
2026-08-02 fix(wifi): route OTA reboots through mDNS withdrawal, fix hostname order, wrap OLED name
    Addresses review on the mDNS naming PR:
    - ElegantOTA and pull OTA success paths called ESP.restart() directly,
    bypassing stopWifi()'s mDNS withdrawal. ElegantOTA auto-reboot is now
    disabled and both paths queue the restart through the existing
    remoteQueueResetAt() mechanism instead, keeping the teardown on the
    main loop task. hdsOtaRollback() now calls stopWifi() before its
    direct reboot too, since the pending-LittleFS resume flow can bring
    WiFi/mDNS up before a rollback.
    - WiFi.setHostname() ran after WiFi.config(), which already starts STA
    and copies the prior default hostname to the int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
    [menu.h, ota_rollback.h, pull_ota.h, test_ota_reboot_routing_contract.py, wifi_ota.h, wifi_setup.cpp]
2026-08-02 fix(display): wrap the mDNS name at the real OLED column limit
    The WiFi status screen split the device name after 16 characters, but the
    name is drawn at x=40 with the 6x12 font, leaving only 88 pixels (14
    characters) before the 128-pixel display edge. Characters 15 and 16 were
    clipped from the first line and skipped on the second, so a 24-character
    name could not be read back from the OLED.
    Move the split into a pure mdnsNameSplitOledLine1() helper in mdns_name.h,
    cut at 14 characters, and static_assert that the two lines together hold
    MDNS_NAME_MAX_CHARS. Cover the boundary with native tests.
    [mdns_name.h, menu.h]
2026-08-11 fix(custom-build): complete service integration
    [build_custom_firmware.py, config.h, configure_custom_build.py, hds_features.h, test_custom_build_execution.py, test_custom_cache_transport.py, test_grinder_feature_flag_contract.py, test_plugin_catalog.py]
2026-08-11 fix(custom-build): identify worker requests
    [build_custom_firmware.py, publish_custom_build.py, test_custom_cache_transport.py, update_custom_build_status.py]
2026-08-11 fix(custom-build): harden artifact delivery
    [build_custom_firmware.py, configure_custom_build.py, publish_custom_build.py, test_custom_build_execution.py, test_custom_cache_transport.py, update_custom_build_status.py]
2026-08-11 fix(custom-build): accept refreshed main hash
    [test_custom_build_execution.py]
2026-08-11 fix(energy): preserve soft sleep and battery baseline
    [energy_runtime_policy.h, hds.ino, power.h, test_energy_stage0_contract.py, test_soft_sleep_ads_wake.py]
2026-08-12 fix(ble): preserve soft sleep on disconnect
    [ble.h, test_soft_sleep_ads_wake.py]
2026-08-13 fix(ota): retain LittleFS recovery through validation
    [pull_ota.h, test_ai_docs_contract.py, test_ota_rollback_contract.py]
2026-08-13 fix(ota): skip rewrite after LittleFS validation
    [pull_ota.h, test_ota_rollback_contract.py]
2026-08-13 fix(ota): require persisted boot attempts
    [ota_rollback.h, test_ota_rollback_contract.py]
2026-08-13 fix(ble): throttle heartbeat disconnect retries
    [hds.ino, test_ble_subscription_contract.py]
2026-08-13 fix(ble): separate heartbeat retry timing
    [ble.h, hds.ino, test_ble_subscription_contract.py]
2026-08-13 fix(usb): restore text tare and timer actions
    [hds.ino, test_usb_text_actions_contract.py, usbcomm.h]
2026-08-13 fix(power): notify BLE before low-battery sleep
    [power.h, test_low_battery_notification_contract.py]
2026-08-13 fix(usb): construct text from its known length
    [test_usb_text_buffer_contract.py, usbcomm.h]
2026-08-13 fix(power): debounce low battery with fresh samples
    [power.h, test_low_battery_debounce_contract.py]
2026-08-13 fix(power): pause battery checks in soft sleep
    [power.h, test_low_battery_debounce_contract.py]
2026-08-13 fix(ota): keep updates awake
    [hds.ino, test_ota_reboot_routing_contract.py]
2026-08-13 fix(buttons): reject long finger presses
    [finger_detection.h, test_finger_press_duration_contract.py]
2026-08-13 fix(power): stamp battery samples at acquisition
    [hds.ino, power.h, test_battery_refresh_timestamp_contract.py]
2026-08-13 fix(ble): queue voltage responses
    [ble.h, hds.ino, parameter.h, test_ble_voltage_mailbox_contract.py]
2026-08-13 fix(ota): isolate update input
    [hds.ino, test_ota_input_isolation_contract.py]
2026-08-13 fix(ota): stop same-pass input dispatch
    [hds.ino, test_ota_input_isolation_contract.py, usbcomm.h]
2026-08-13 fix(ota): gate every USB parser iteration
    [test_ota_input_isolation_contract.py, usbcomm.h]
2026-08-13 fix(ota): wake before pull update
    [menu.h, test_soft_sleep_ads_wake.py]
2026-08-13 fix(power): defer soft-wake state transition
    [ble.h, test_soft_sleep_ads_wake.py, websocket.h]
2026-08-13 fix(power): defer display wake state
    [ble.h, test_soft_sleep_ads_wake.py, websocket.h]
2026-08-13 fix(ble): deliver notifications to iOS 9 clients
    On iOS 9 (CoreBluetooth) the arduino-esp32 BLE server never runs its
    connect path for the client: onConnect does not fire and
    getConnectedCount() stays 0, so BLECharacteristic::notify() bails with
    ERROR_NO_CLIENT and the scale never streams weight -- even though the
    client connects, subscribes to FFF4, and every write is ACKed. This is
    why de1app on a jailbroken iPad mini 1 (iOS 9.3.5) connected the Decent
    Scale but reported "abandoning scale updates". macOS and modern iOS are
    unaffected because their connect path runs normally.
    onSubscribe does fire on iOS 9, so:
    - adopt that subscription as the live connection when none was registered
    (se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
    [ble.h]
2026-08-13 fix(ota): wake for async updates
    [hds.ino, test_ota_reboot_routing_contract.py]
2026-08-13 fix(power): publish applied soft-sleep state
    [ble.h, parameter.h, test_ota_reboot_routing_contract.py, test_soft_sleep_ads_wake.py, websocket.h]
2026-08-13 fix(ota): defer remote actions during updates
    [test_ota_reboot_routing_contract.py, websocket.h]
2026-08-13 fix(ota): synchronize async update start
    [test_ota_reboot_routing_contract.py, wifi_ota.h]
2026-08-13 fix(ota): preserve deferred remote actions
    [parameter.h, pull_ota.h, test_ota_reboot_routing_contract.py, websocket.h, wifi_ota.h]
2026-08-13 fix(ota): serialize remote action dispatch
    [parameter.h, test_ota_reboot_routing_contract.py, websocket.h, wifi_ota.h]
2026-08-14 feat(hds): support BQ27427 fuel gauge on 9.0.5 hardware
    HDS 9.0.5 adds a TI BQ27427 battery fuel gauge at I2C 0x55. Probe the
    address and DEVICE_TYPE at boot; when absent (8.3.1 and earlier) all
    gauge features stay disabled and the menu looks unchanged. When present,
    enforce Chem ID 1202 (4.2 V cell), expose a paged Bat. Info menu with
    voltage/temperature/current/power/capacity/health/SOC/charging/USB, and
    provide a deep-sleep hook. ADS1115 battery path is kept for older boards.
2026-08-14 feat(hds): 9.0.5 board config, battery protect, capacity command
    - Add V9_0_5 board variant (CHRG_CTRL=6, GPOUT=14, no BATTERY_PIN) and
    esp32s3-905 env; battery voltage/percent come from the gauge on 9.0.5
    while 8.3.1 keeps the legacy ADC/ADS1115 path (batteryPercent helper).
    - Bat. Info menu now works on both boards: full dual-column page with the
    gauge, limited voltage/CRG/USB page without it. Charging state reads the
    TP4056 CHRG pin (GPIO10) instead of gauge current.
    - Battery Protect menu (off by default, NVS): charge cutoff at 80% SOC via
    CHRG_CTRL, resume at 75%.
    - Boot detection retries to cover cold-start timing; CC_GAIN sign-bit fix
    (early batch bug) re-applied on every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
    [config.h, decent_protocol.h, fuel_gauge.cpp, hds.ino, menu.h, parameter.h, power.h]
2026-08-14 perf(ram): remove unused finger sample state
2026-08-14 perf(ram): compact finger sample timing state
2026-08-14 fix(ci): rebase pressensor patch for menu changes
    [test_plugin_ci_contract.py]
2026-08-14 feat(hds): single firmware for 9.0.5 and 8.x, one-time capacity write
    - Merge the two board variants into one binary: runtime I2C detection of
    the BQ27427 selects the battery path and GPIO6 role (CHRG_CTRL on
    9.0.5 vs battery ADC on 8.x). The 8.1 pin block stays pure; 9.0.5
    differences live in a separate config section.
    - Design capacity written once (700 mAh) guarded by an NVS flag, so
    reflashing never resets it; the bc USB command still allows manual
    query/set.
    - Battery percent clamped to 0-100 (legacy voltage map extrapolates
    above 100 % at full charge).
    - Bat. Info on 8.x boards becomes a 4-line page; migration path ensures
    the new NVS keys so fresh boards boot cleanly.
    C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
    [config.h, fuel_gauge.cpp, hds.ino, menu.h, power.h, storage.h, usbcomm.h]
2026-08-15 fix(menu): restart after WiFi setting changes
    [menu.h, parameter.h, test_ota_reboot_routing_contract.py]
2026-08-15 fix(menu): consume restart on every menu exit
    [decent_protocol.h, menu.h, parameter.h, test_ota_reboot_routing_contract.py, usbcomm.h]
2026-08-15 fix(custom-build): retain setup server with WiFi
    [configure_custom_build.py, test_plugin_catalog.py]
2026-08-15 fix: strengthen custom build verification
    [build_custom_firmware.py, list_changed_patch_plugins.py, test_custom_build_execution.py, test_plugin_ci_contract.py]
2026-08-15 fix: canonicalize plugin dependency order
    [configure_custom_build.py, test_plugin_catalog.py]
2026-08-16 fix: harden idle websocket and button timing
    [hds.ino, test_idle_optimizations_contract.py, websocket.h]
2026-08-17 fix(battery): correct CHRG_CTRL polarity for 9.0.5 hardware
    Q15 (S8050 NPN) inverts CHRG_CTRL before the TP4056 CE pin on the 9.0.5
    PCB: LOW = charging enabled, HIGH = disabled. Update fuelGaugeLoop,
    fuelGaugeProtectSet, fuelGaugeBegin and the PR description accordingly.
    [config.h, fuel_gauge.cpp]
2026-08-17 fix(energy): make menu selectable and refresh PR contracts
    [energy_menu.h]
2026-08-17 fix(energy): preserve stock battery debounce
    [power.h, test_energy_stage0_contract.py]
2026-08-17 perf(power): add runtime light sleep control
2026-08-17 fix(power): apply PM sdkconfig to energy builds
    [test_energy_stage0_contract.py]
2026-08-17 fix(power): preserve opt-in energy behavior
    [build_custom_firmware.py, configure_custom_build.py, power.h, test_energy_stage0_contract.py, test_low_battery_debounce_contract.py, test_plugin_catalog.py, test_plugin_ci_contract.py]
2026-08-17 fix(ble): use main xtal for modem sleep
    [test_energy_stage0_contract.py]
2026-08-17 fix(power): clear light-sleep timer before shutdown
    [power.h, test_energy_stage0_contract.py]
2026-08-17 fix(energy): isolate stock firmware behavior
    [ble.h, gyro.h, menu.h, power.h, test_energy_stage0_contract.py, test_low_battery_debounce_contract.py, test_plugin_ci_contract.py, test_soft_sleep_ads_wake.py]
2026-08-18 perf(power): make Light Sleep idle event-driven
2026-08-18 fix(power): configure light sleep wake sources
    [energy_idle_wake.h, hds.ino, power.h, test_energy_stage0_contract.py]
2026-08-18 fix(power): restore RTC wake pins after light sleep
    [energy_idle_wake.h, test_energy_stage0_contract.py]
2026-08-18 fix(power): simplify cadence and OLED redraw
    [ble.h, energy_menu.h, energy_policy.h, energy_runtime_policy.h, hds.ino, menu.h, parameter.h, power.h]
2026-08-18 fix(power): restore OLED idle and boot rendering
    [ble.h, energy_menu.h, energy_policy.h, energy_runtime_policy.h, hds.ino, menu.h, parameter.h, storage.h]
2026-08-18 perf(memory): aggregate finger press samples
2026-08-18 Avoid duplicate pull OTA release lists
    [pull_ota.h, test_pull_ota_contract.py]
2026-08-18 feat(power): add persistent USB sleep test
2026-08-18 fix(power): add per-source wake fallback
    [energy_idle_wake.h, energy_policy.h, energy_power_management.h, hds.ino, parameter.h, test_energy_stage0_contract.py]
2026-08-18 fix(power): anchor ADC fallback deadline
    [hds.ino, test_energy_stage0_contract.py]
2026-08-19 fix(ble): handle uncounted subscription peers
    [ble.h, parameter.h, test_ble_subscription_contract.py]
2026-08-19 fix(custom-build): preserve firmware binaries across buildfs
    [build_custom_firmware.py, test_custom_build_execution.py]
2026-08-19 fix: preserve argparse module descriptions
    [ble_scale_client.py, conn_churn.py, ws_drop_repro.py, ws_feature_test.py]
2026-08-26 fix(custom-build): keep staged rollout recoverable
    [test_custom_build_execution.py]
2026-08-27 fix(custom-build): refresh stale catalog during retry
    [test_custom_build_execution.py]
2026-08-27 fix(plugins): mark grinder and pressensor incompatible
    [test_plugin_catalog.py]
2026-08-27 fix(custom-build): render firmware label
    [test_plugin_catalog.py]
2026-08-28 fix(custom-build): simplify ready downloads
    [test_plugin_catalog.py]
2026-08-28 fix(custom-build): default to newest release
    [test_plugin_catalog.py]
2026-08-28 fix(custom-build): restrict sources to releases
    [configure_custom_build.py, test_custom_build_execution.py, test_plugin_catalog.py, test_plugin_ci_contract.py]
2026-08-28 feat(ota): start a targeted firmware update from any transport
    Decent opcode 0x1B gains an optional three-byte version payload, and the
    /snapshot WebSocket gains a wifi_update control command. When a request
    names a release the scale installs it without the on-OLED picker or the
    hold-to-confirm gesture; a request with no version keeps the interactive
    flow on every transport.
    Each version byte is encoded 0x80 | value. The USB reader enters the
    binary framer only on a leading 0x03, so a biased byte can never be read
    as the start of a command. Firmware predating this change therefore
    frames 03 1B as two bytes, starts its picker, and discards the payload
    through the text path. One request form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
2026-08-28 test(ota): cover remote start framing and unattended selection
    Add native cases to test_decent_protocol for the 0x1B framing rule now
    that decentCommandFrameLength lives in decent_protocol_frame.h: a bare
    request frames as two bytes, a biased payload frames as five, an
    incomplete payload returns 0 rather than dispatching bare, a following
    command is not swallowed, and biased bytes decode to the right version.
    Add a native contract for the target version helpers and a source
    contract for the pieces a regression would silently break: the framing
    rule, the biased payload decode, the volatile pending and requested
    target state, and the wsPendingMux critical sections around both. The
    source cont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
2026-08-28 docs(ota): document remote start and unattended install
    Record the two 0x1B forms, the 0x80 encoding and its 127 cap, and the
    framing rule that lets one request form serve every firmware. Note in the
    compatibility checklist why the bias is load-bearing: an unbiased payload
    could hold 0x03, so a 3.10.2 target would decode to 03 0A 02, the
    power-off command, on older firmware.
    Add an unattended-install section covering resolution against the picker's
    selection list, the full refusal list, that a refusal never falls back to
    the picker, and the acknowledgement boundary.
2026-08-29 fix(ota): reject truncated targeted update requests
    The USB length resolver waited for five bytes once the version payload
    began, so a request cut short by a new 0x03 frame boundary consumed the
    following command as version data. Every byte of a started payload must
    now carry the 0x80 bias; an unbiased byte resynchronizes the resolver
    after a single byte, and the dispatcher repeats the check before
    decoding so whole packets from any transport are refused the same way.
    [decent_protocol.h, decent_protocol_frame.h, pull_ota_target.h, test_pull_ota_target_contract.cpp]
2026-08-29 fix(ota): keep a start request atomic across dispatch
    processWsPendingCmds() cleared WSP_WIFI_UPDATE when it snapshotted the
    target, but the running flags were only set later inside wifiUpdate().
    A request arriving in that window saw no queued bit and no running
    update, so it was accepted and could run after the first attempt failed
    or vanish when the first install rebooted. A pendingOtaDispatching flag
    now covers the handoff and is cleared only once the update is running,
    or with the pending bit when the request is deferred.
    [parameter.h, test_decent_ota_target_contract.py, websocket.h]
2026-08-29 fix(ota): admit every start request through one path
    USB called wifiUpdate() directly after checking only the running flags,
    so a request already queued by BLE or the WebSocket could be overtaken:
    the queued request then either ran once the USB update failed or was lost
    when it rebooted. USB now admits through remoteQueueWifiUpdate() like the
    other transports, and that helper reads the queued bit, the dispatch flag,
    and both running flags in one critical section. A request that reaches
    dispatch while an update is already running is dropped and logged instead
    of being requeued for later.
    [test_decent_ota_target_contract.py, usbcomm.h, websocket.h]
2026-08-29 fix(ws): refuse a non-string JSON action
    An action of the wrong JSON type collapsed to an empty string, so
    {"command":"wifi_update","action":false} behaved like a bare wifi_update
    and started the interactive OTA flow. A present action that is not a
    string now answers invalid_action; an omitted or null action still means
    the bare form.
    [test_decent_ota_target_contract.py, websocket.h, ws_command_test.py]
2026-08-29 fix(ota): register handlers before server start
    [hds.ino]
2026-08-29 fix(ota): isolate flash writes from main loop work
    [hds.ino, test_ota_runtime_isolation_contract.py, websocket.h]
2026-08-29 fix(ota): retain pull update isolation until exit
    [pull_ota.h, test_pull_ota_contract.py]
2026-08-29 fix(ota): suspend BLE traffic during updates
    [ble.h, hds.ino, test_ota_runtime_isolation_contract.py]
2026-08-29 fix(ota): reject competing network traffic during updates
    [hds.ino, test_ota_runtime_isolation_contract.py, webserver.h]
2026-08-29 fix(ota): reject unprotected filesystem uploads
    [test_ota_runtime_isolation_contract.py, webserver.h]
2026-08-29 fix(ota): recover abandoned upload sessions
    [hds.ino, parameter.h, test_ota_runtime_isolation_contract.py, wifi_ota.h]
2026-08-29 perf(ota): throttle upload progress rendering
2026-08-29 docs(ota): tighten remote start notes
2026-08-29 test(ota): remove stale battery ordering contract
2026-08-30 fix(custom-build): disable unselected Pressensor plugin
    [test_plugin_ci_contract.py]
2026-08-30 fix(ota): close remaining runtime isolation races
    [ble.h, hds.ino, parameter.h, pull_ota.h, test_ota_runtime_isolation_contract.py, test_pull_ota_contract.py, websocket.h, wifi_ota.h]
2026-08-31 feat(hds): double/triple tap on scale top for tare and timer controls based on weight changes
    - New DoubleTapTare menu with independent toggles for double-tap tare
    and triple-tap timer, both off by default and persisted in NVS
    (tap_tare / tap_timer).
    - Steady-state scale-top tap detector: 100 ms sampling, 500 ms / 0.5 g
    steady baseline, 20 g peak, 400 ms sequence window, 500 ms action
    delay. The third peak cancels a pending double decision, so a 3-tap
    never falls back to tare.
    - Tap actions reuse the existing button paths (b_tareByButton for tare,
    scaleTimer for the timer start/stop/reset cycle) so quick-zero,
    grinder hooks, and protocol behavior stay consistent.
    - Detector run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
    [hds.ino, menu.h, parameter.h, storage.h, tap_detection.h, test_menu_memory_contract.py]
2026-08-31 fix(hds): harden scale-top tap recognition
    [finger_detection.h, tap_detection.h, tap_detector.h, test_tap_action_contract.py]
2026-08-31 fix(hds): require final tap recovery
    [tap_detection.h, tap_detector.h, test_tap_action_contract.py]
2026-08-31 fix(hds): reduce tap action latency
    [tap_detection.h, tap_detector.h, test_tap_action_contract.py]
2026-08-31 fix(hds): gate taps during active workflows
    [tap_detection.h, tap_detector.h, test_tap_action_contract.py]
2026-09-01 fix(menu): consume dismissing button release
    [hds.ino, menu.h, test_menu_memory_contract.py]
2026-09-01 fix(custom-build): verify Pressensor release patch
    [test_custom_build_execution.py, test_plugin_ci_contract.py]
2026-09-01 Fix fleet pairing CI contracts
    [test_plugin_catalog.py, test_pull_ota_contract.py]
2026-09-01 Clarify custom build install flow
2026-09-01 Fix fleet OTA trust and ownership boundaries
    [configure_custom_build.py, pull_ota.h, test_custom_build_execution.py, test_ota_rollback_contract.py, test_plugin_catalog.py, test_plugin_ci_contract.py, test_pull_ota_contract.py]
2026-09-01 Keep tagged build fixtures self-contained
    [test_custom_build_execution.py]
2026-09-01 Resolve main in plugin CI fixture
    [test_plugin_ci_contract.py]
2026-09-01 Use switch for detached main fixture
    [test_plugin_ci_contract.py]
2026-09-01 Fix custom OTA rollback identity
    [custom_build_ota.h, pull_ota.h, test_custom_build_ota_contract.py, test_ota_rollback_contract.py, test_pull_ota_contract.py]
2026-09-03 Fix fleet pairing lifecycle and OTA key bootstrap
    [build_custom_firmware.py, test_custom_build_ota_contract.py, test_custom_ota_public_key_header.py, test_release_workflow_contract.py, write_custom_ota_public_key_header.py]
2026-09-03 Add custom OTA key rotation slot
2026-09-04 Fix main custom build validation
    [test_plugin_ci_contract.py]
2026-09-05 Fix Custom Build first pairing and rejected identity relink
    [custom_build_ota.h, test_custom_build_ota_contract.py]
2026-09-05 Fix local tap actions and timing from preview hardware tests
    [tap_detection.h, tap_detector.h, test_tap_action_contract.py]
2026-09-05 Fix custom build navigation and simplify fleet controls
    [custom_build_ota.h, menu.h, test_custom_build_ota_contract.py]
2026-09-05 Wait for network startup before opening mini server sockets
2026-09-06 fix: persist browser fleet access across sessions
    [test_plugin_catalog.py]
2026-09-06 fix: keep pairing code visible and simplify fleet editing
    [custom_build_ota.h, test_custom_build_ota_contract.py, test_plugin_catalog.py]
2026-09-07 Resolve release OTA rollback from installed custom identity (#185)
    [pull_ota.h, test_pull_ota_contract.py]
2026-09-08 Improve custom build installation status reporting (#190)
    * Validate preview dispatch without a published stable tag
    * fix: poll pending custom build installations
    * Fix custom-build cache references and run fleet polling tests
    [test_plugin_catalog.py]
2026-09-09 feat: optional Wake-on-Weight mode via RTC timer polling (#180)
    * feat: add optional Wake-on-Weight mode via RTC timer polling
    After deep sleep, an RTC timer wakes the scale on a user-selectable
    interval (0.5/1/2 s or off, Power menu 'Wake:' row, NVS wow_interval);
    the micro-wakeup powers the load-cell rail, reads one raw ADS1232
    conversion at 10 SPS, and either re-enters deep sleep (|raw - baseline|
    under a 50 g-equivalent threshold stored in RTC_DATA_ATTR at sleep
    entry) or falls through to a full normal boot. Disabled on low battery,
    inert until calibrated; charging allowed; button/charging EXT1 wake
    unchanged.
    * fix: wake-on-weight hardwa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
    [hds.ino, menu.h, parameter.h, power.h, storage.h, test_wake_on_weight_contract.py, test_wake_on_weight_runtime.py, wake_on_weight.h]
2026-09-09 Fix signed recovery assets and exact rollback lookup for previews (#192)
    * fix: publish and resolve exact prerelease rollback assets
    * fix: version the exact-release recovery capability gate
    [generate_release_manifest.py, pull_ota.h, pull_ota_version.h, test_generate_release_manifest.py, test_pull_ota_contract.py, test_release_workflow_contract.py]
2026-09-09 fix: restore RTC wake inputs before Wake-on-Weight checks (#195)
    [menu.h, parameter.h, power.h, test_usb_text_actions_contract.py, test_wake_on_weight_contract.py, test_wake_on_weight_runtime.py, usbcomm.h, wake_on_weight.h]
2026-09-10 Report WiFi install progress and completion to fleet (#194)
    * fix: report custom install progress and completion to fleet
    * Keep WiFi recovery usable after LittleFS failure and prioritize buttons
    * Preserve attempted build identity through filesystem rollback
    [configure_custom_build.py, custom_build_ota.h, filesystem_recovery.h, generate_custom_ota_manifest.py, generate_release_manifest.py, hds.ino, ota_rollback.h, parameter.h]
2026-09-10 Fail closed on catalog retrieval and verify uploaded release assets (#198)
    * Fail release preparation when previous signed catalog is unavailable
    * Verify downloaded draft release assets before publication
    [test_release_catalog_download.py, test_release_workflow_contract.py, test_verify_release_assets.py, verify_release_assets.py]
2026-09-10 Keep Wake on Weight active without session or failure cutoffs (#199)
    [parameter.h, test_wake_on_weight_contract.py, test_wake_on_weight_runtime.py, wake_on_weight.h]
2026-09-10 Fix draft release verification by resolving release IDs (#201)
    [release_publication.py, test_release_publication.py]
2026-09-14 Reset auto-off timer on meaningful weight changes
    [auto_off_activity.h, parameter.h, power.h, test_auto_off_weight_activity.py]
2026-09-15 chore: remove temporary probe file
2026-09-15 perf(power): improve Light Sleep button responsiveness
2026-09-15 test(power): follow shared button input helper
2026-09-15 test(power): follow shared button service in OTA isolation
2026-09-15 fix(ci): pin nested pioarduino core for energy builds
    [test_plugin_ci_contract.py]
2026-09-16 fix(power): simplify Light Sleep selection and boost button wakes
    [check_energy_ble_redraw.py, check_energy_button_regressions.py, display.h, energy_menu.h, hds.ino, storage.h, test_energy_stage0_contract.py]
2026-09-23 Style default web apps to match HDS custom build
    Keep the custom-build page unchanged while using its palette and toggle as the LittleFS visual reference. Add app-only theme assets, responsive layout fixes, catalog hashes, and contract coverage.
    [test_web_theme.py]
2026-09-23 fix(webapp): preserve filesystem recovery route order
    [test_webapp_contract.py, webserver.h]
2026-09-23 fix(custom-build): stage webapp presentation helper
    [build_custom_firmware.py]
2026-09-23 test(custom-build): include webapp helper in fixture
    [test_custom_build_execution.py]
2026-09-23 fix(webapp): reject managed gzip assets and invalid index
    [configure_custom_build.py, test_webapp_contract.py]
2026-09-24 Skip preview refs in plugin PR verification
    [list_changed_patch_plugins.py, test_plugin_ci_contract.py]
2026-09-28 fix: preserve soft-sleep wake and WiFi recovery
    [ble.h, hds.ino, test_energy_stage0_contract.py, test_soft_sleep_ads_wake.py, test_soft_sleep_runtime.py, websocket.h]
2026-09-28 fix: initialize local calibration at its first stage
    [menu.h, test_calibration_entry.py]
2026-09-28 fix: latch grinder error before ADC recovery
    [hds.ino, test_grinder_adc_recovery.py]
2026-09-28 fix: reconnect dashboard WebSocket after disconnect
    [test_dashboard_reconnect.py]
2026-09-28 fix: quote measurement CSV export fields
    [test_csv_exports.py]
2026-09-28 fix: reset Weigh Save baseline for new objects and runs
    [test_weigh_sessions.py]
2026-09-28 fix: save current stable doses only in active sessions
    [test_dosing_lifecycle.py]
2026-09-28 fix: isolate dosing and QC preset storage
    [test_preset_isolation.py]
2026-09-28 fix: persist dosing and QC measurement history
    [test_measurement_history.py]
2026-09-29 fix: discard superseded sleep commands before dispatch
    [test_soft_sleep_runtime.py, websocket.h]
2026-09-29 fix: preserve Pressensor patch compatibility after calibration entry fix
    [test_calibration_entry.py, test_plugin_ci_contract.py]
2026-09-30 Fix USB calibration menu selection fallthrough
    [hds.ino, test_calibration_entry.py]
2026-09-30 Include NULL definition in native calibration test
2026-10-01 fix: serialize USB soft sleep with remote commands
    [test_soft_sleep_ads_wake.py, test_soft_sleep_runtime.py, usbcomm.h]
2026-10-01 fix: stop grinder before USB ADC reset
    [test_grinder_adc_recovery.py, usbcomm.h]
2026-10-01 fix: isolate calibration from charging and square actions
    [hds.ino, test_calibration_entry.py, test_calibration_mode_runtime.py]
2026-10-01 fix: decouple pressensor patch from charging guard
2026-10-01 fix: preserve setup through calibration and OTA actions
    [hds.ino, menu.h, parameter.h, test_calibration_entry.py, test_calibration_mode_runtime.py, test_ota_reboot_routing_contract.py]
2026-10-02 Cover independent grinder ADC outcomes and compile grinder in CI
2026-10-03 fix: version preset stores and bound legacy selection migration
    [test_preset_isolation.py]
2026-10-03 Fix measurement history warnings and denied-storage startup
    [test_measurement_history.py]
2026-10-09 Add verified WiFi switching and network discovery
2026-10-09 Preserve scanned WiFi credentials and harden recovery resets
    [menu.h, test_wifi_setup_contract.py, test_wifi_setup_runtime.py, wifi_credentials.h, wifi_scan.cpp, wifi_settings.cpp, wifi_setup.h]
2026-10-09 Restore legacy WiFi controls and preserve failed reset operations
    [test_wifi_setup_contract.py, test_wifi_setup_runtime.py, wifi_setup.cpp, wifi_setup_page.h]
2026-10-09 Ask for network confirmation before checking WiFi switch
2026-10-09 Keep WiFi result button hidden without a pending check
2026-10-09 Keep WiFi results on the current page until verified
2026-10-09 Update fallback rename runtime fixture for identity guards
    [test_filesystem_recovery_runtime.py]
2026-10-10 Fix WiFi credential preservation for legacy OTA recovery
    [pull_ota.h, test_custom_build_reporting_runtime.py, test_pull_ota_contract.py, test_wifi_setup_contract.py, test_wifi_setup_runtime.py, wifi_settings.cpp, wifi_settings.h]
2026-10-10 Fail closed on legacy credential verification errors
    [test_wifi_setup_runtime.py, wifi_settings.cpp]
2026-10-10 Fix firmware upload timeout activity snapshot race
    [test_ota_timeout_runtime.py, wifi_ota.h]
2026-10-11 Fix OTA WiFi coordination and staged startup
2026-10-13 Preserve claimed device credentials through pairing expiry
2026-10-17 fix(power): ignore unserviceable soft-sleep scheduler work
2026-10-17 fix: refund weekly build slots after budget refusals
2026-10-17 fix(timer): preserve queued reset effects before stop
2026-10-17 fix: refresh stale ADC samples before tare
2026-10-17 fix(tools): preserve serial frame boundaries (F28)
2026-10-19 Pin nested PlatformIO Core in stock firmware CI builds
2026-10-19 Make fuel gauge sampling and charging fail closed
2026-10-19 Bound battery info formatting for strict host compilers
2026-10-19 Maintain protected charging during deep sleep
2026-10-19 Keep USB-powered scale awake during charge protection
2026-10-21 Restore manual USB standby and menu access while charging
2026-10-28 Keep credential confirmation buttons compact on narrow screens
2026-11-02 fix(battery): initialize charge control before first write
2026-11-02 Overlap fuel gauge detection with ADC startup
2026-11-02 fix(startup): address charging and boot contract review
2026-11-02 Make fuel gauge startup cooperative and interruption safe
2026-11-02 Persist POR capacity fallback before cleanup resets gauge
2026-11-02 Preload charger disable level before enabling GPIO output
2026-11-03 Hide battery level until the first published reading
2026-11-05 Integrate reviewed firmware, plugin, and web-app fixes with BLE App Text (#274)
    Integrate the tested combined changes from PRs #239, #245, #248, #249, #250, #254, #255, #256, #257, #260, #262, #263, #264, #268, #269, and #270. Exclude #209 and #217.
    Retain #269's immediate integration switching and mDNS fixes, but use #270's bounded OFF-before-shutdown policy with late-USB cancellation recovery. Preserve supported Pressensor patch variants and production custom-build defaults. Include opt-in 128-character BLE App Text with overflow scrolling.
    All 15 applicable GitHub checks passed. Local 81-script Python and 65-test Node suites passed; combined firmware was USB-flashed with calibration/set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
2026-11-08 build: stage post-tag 3.1.16 custom support
2026-11-08 Pin nested PlatformIO tooling in signed release builds
